reubenstr/MelodicChimes/README.md

# MelodicChimes

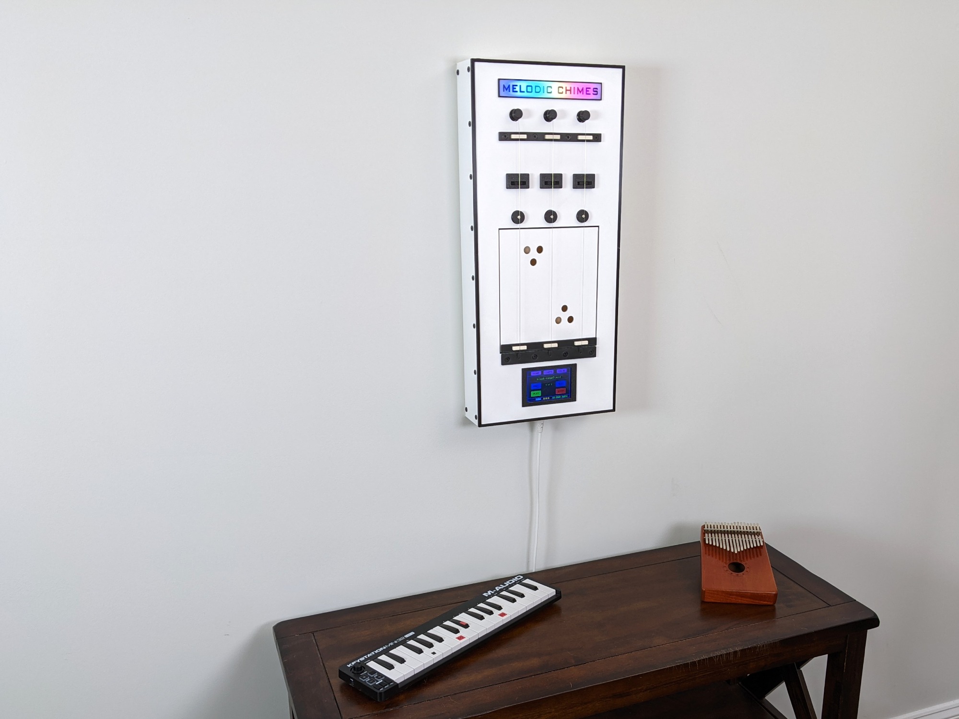
[picture p1: images/melodic-chimes-auto-tuning-string-midi-player-context.jpg]


Melodic Chimes is a three string auto-tuning wall chime playing MIDI files created in MuseScore.
