reubenstr/MelodicChimes/PCBs/README.md

# PCBs

PCBs created in the free version of DipTrace found here https://diptrace.com/
