reubenstr/MelodicChimes/notes/prototyping-notes.txt

HARDWARE:
tuning stepper mounting bolts 4x M3-20mm (12  total)
tuning stepper lower brass cover 1x M3-4mm (3 total)
tunign stepper printed mount 2x M3-10mm		
pcb M3-6mm course thread
psu M3-12mm 2x

PROJECT FIXES:
PCB main - add markings for UART headers.
PCB chime - break out stepper enables per stepper

STEPPER:
Tuner stepper: 5.18:1 gear head 200steps/rev * 5.18 = 1036

Stepper driver jumpers:
[M1 - M6]
MS1: J4, J5, J6, J10, J11, J12
MS2: J1, J2, J3, J7, J8, J9

MS1 MS2 Steps
+	-	1/2
-	+	1/4
-	-	1/8
+	+	1/16

DEVELOPMENT NOTES:

defined AUDIO_GUITARTUNER_BLOCKS value of 24 changed to 6 for
faster analysis at the sacrafice of less lower frequency detection
which is not required for this application.

Blocks : lowest frequncy (rough estimate) : milliseconds per note
3 : 233hz : 9
4 : 174hz : 12
5 : 139hz : 15

A weak magnet for the coil is has a low signal to noise ratio.
A stronger magnet provides a high signal to noise ration.
An overly strong magnet over dampens the string vibrations reducing the length of the signal.
