reubenstr/MelodicChimes/images/melodic-chimes-auto-picker-and-volume-position-steppers.jpg

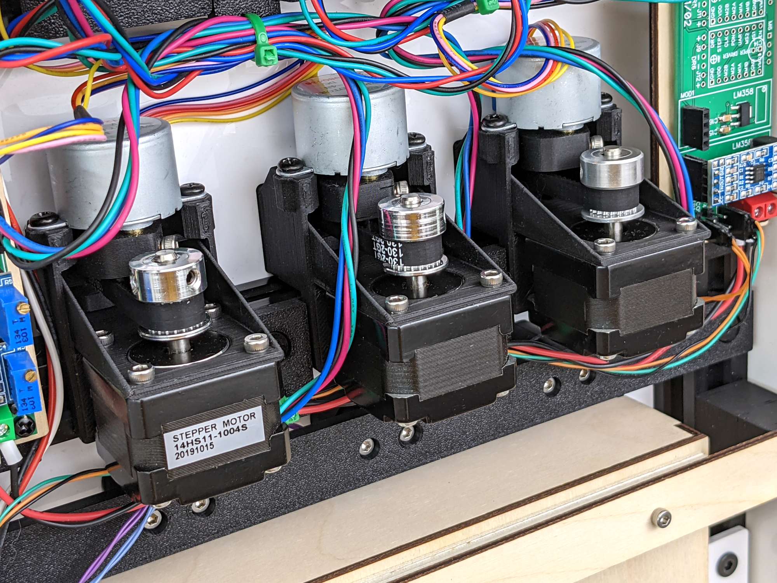
images/melodic-chimes-auto-picker-and-volume-position-steppers.jpg
