reubenstr/MelodicChimes/images/melodic-chimes-back-angled.jpg

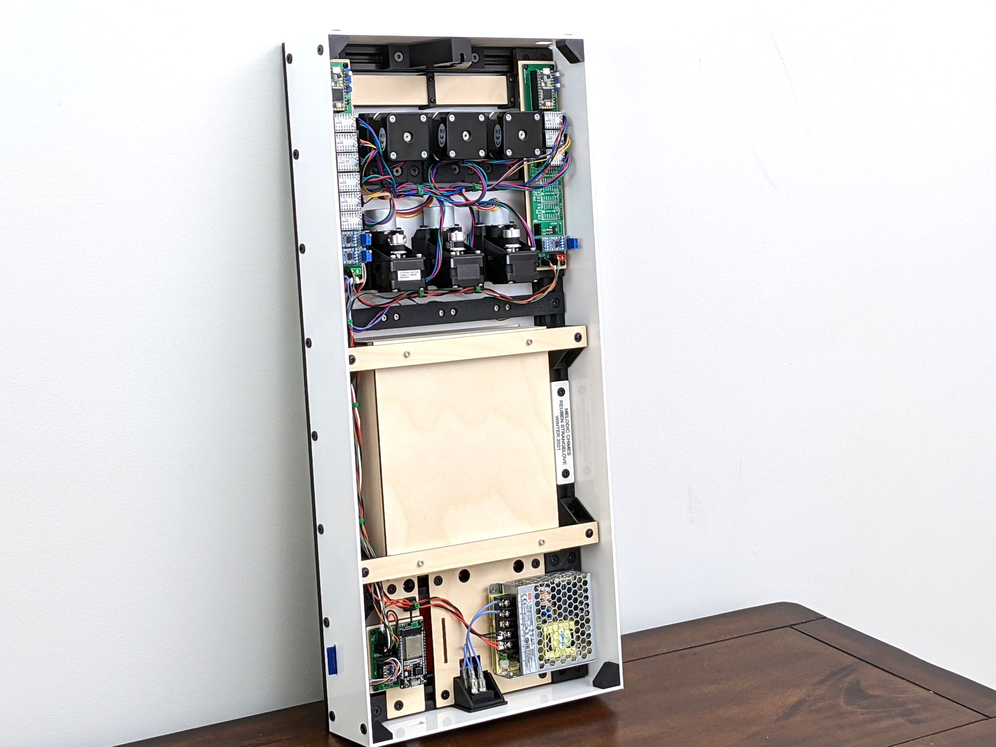
images/melodic-chimes-back-angled.jpg
