reubenstr/MelodicChimes/images/melodic-chimes-back.jpg

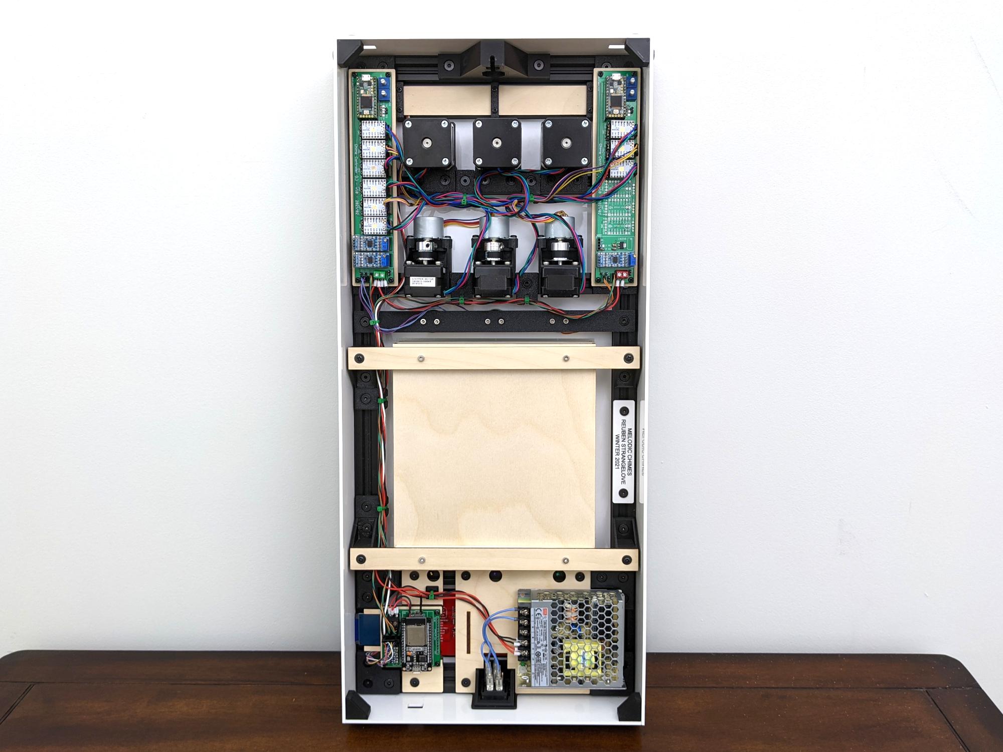
images/melodic-chimes-back.jpg
