reubenstr/MelodicChimes/images/melodic-chimes-CAD-laser-cutting.jpg

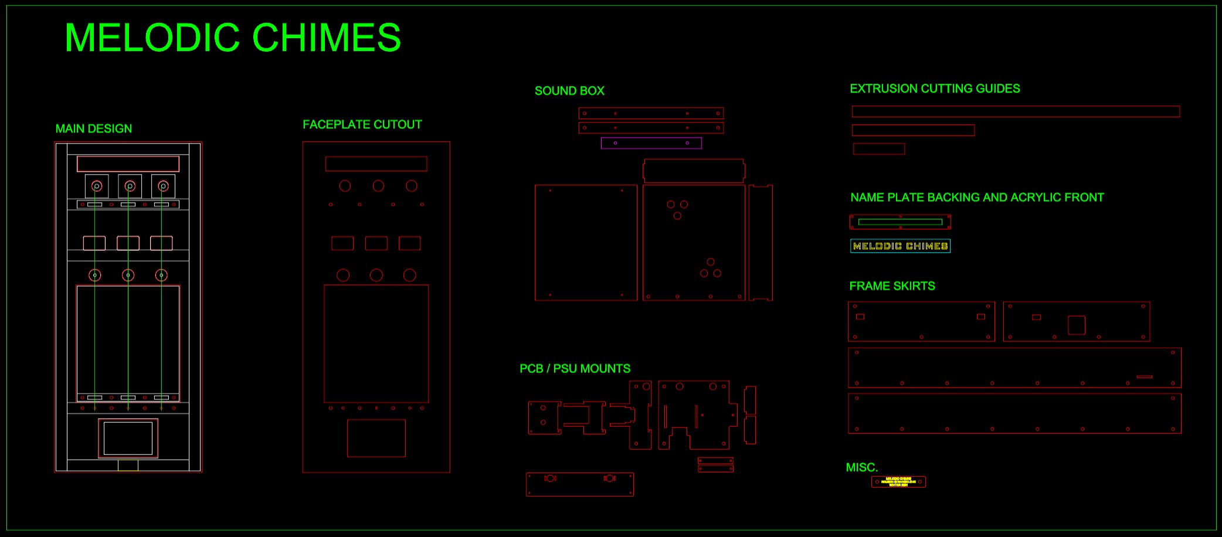
images/melodic-chimes-CAD-laser-cutting.jpg
