reubenstr/MelodicChimes/images/melodic-chimes-chime-controller-pcb-render.png

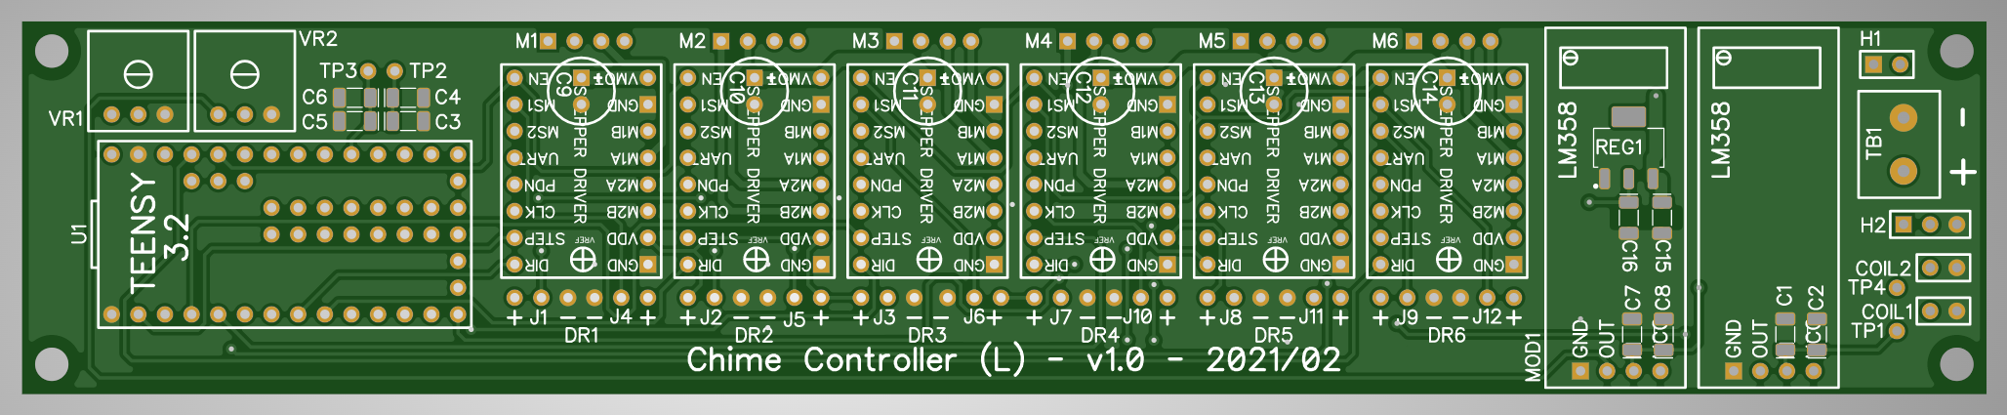
images/melodic-chimes-chime-controller-pcb-render.png
