reubenstr/MelodicChimes/images/melodic-chimes-chime-controller-schematic.png

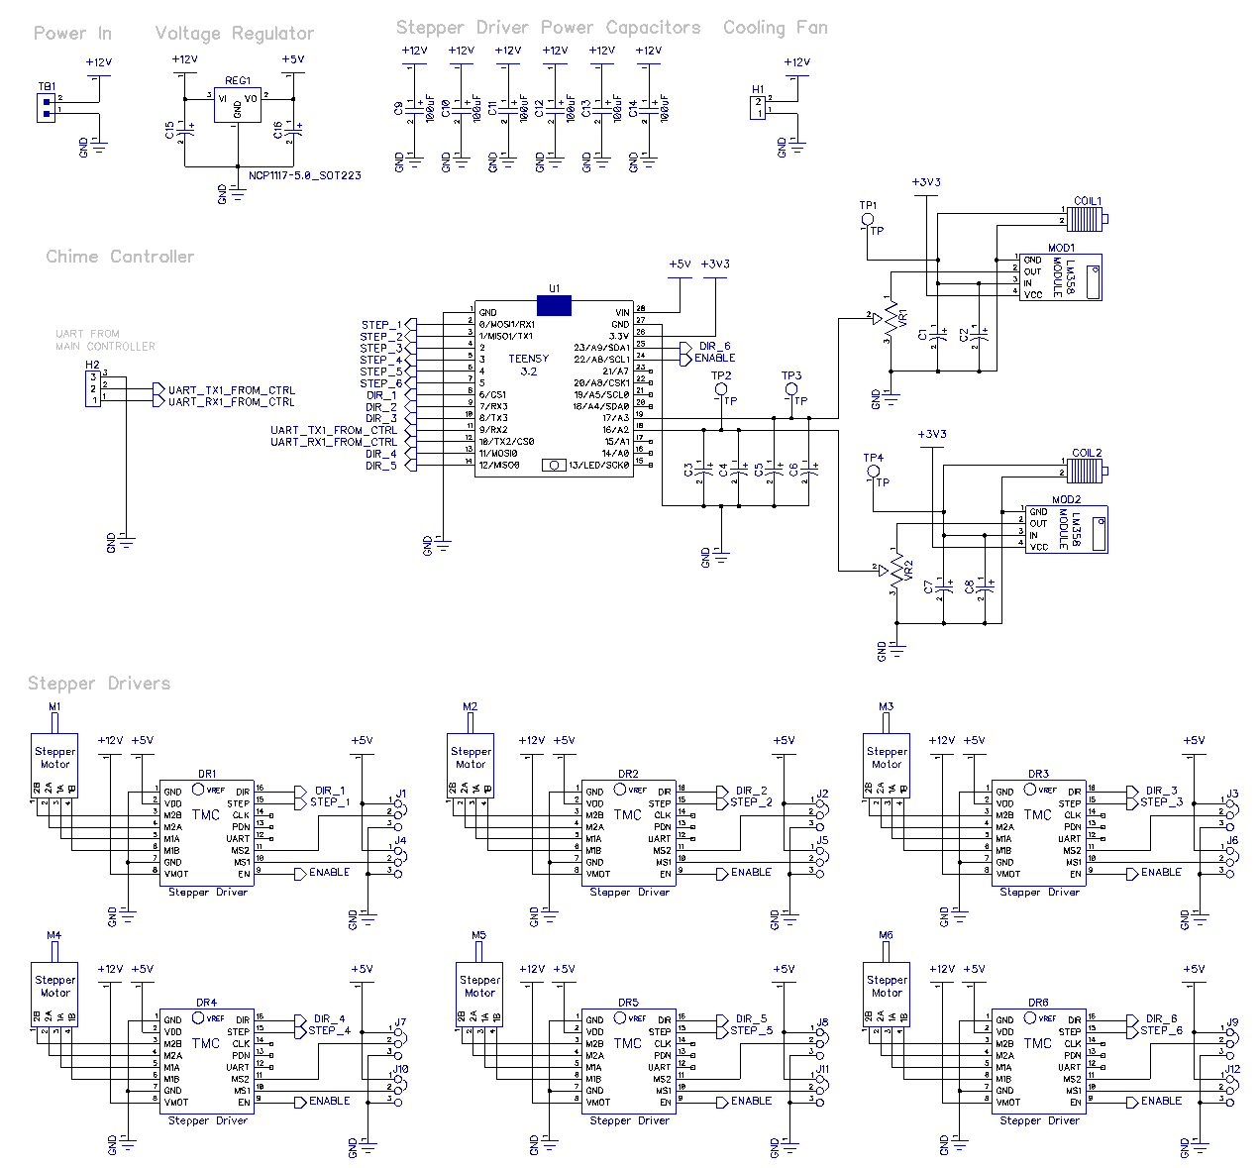
images/melodic-chimes-chime-controller-schematic.png
