reubenstr/MelodicChimes/images/melodic-chimes-corner-bracket.jpg

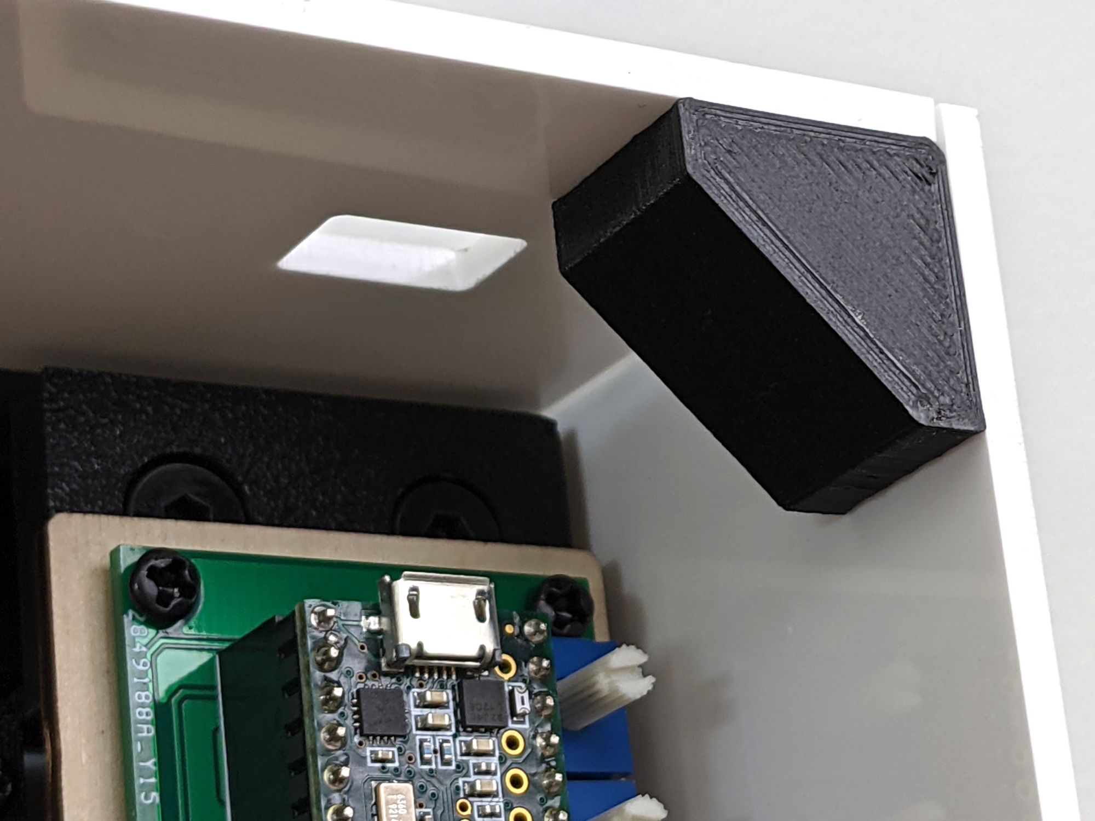
images/melodic-chimes-corner-bracket.jpg
