reubenstr/MelodicChimes/images/melodic-chimes-esp32-microcontroller-and-sd-card-slot.jpg

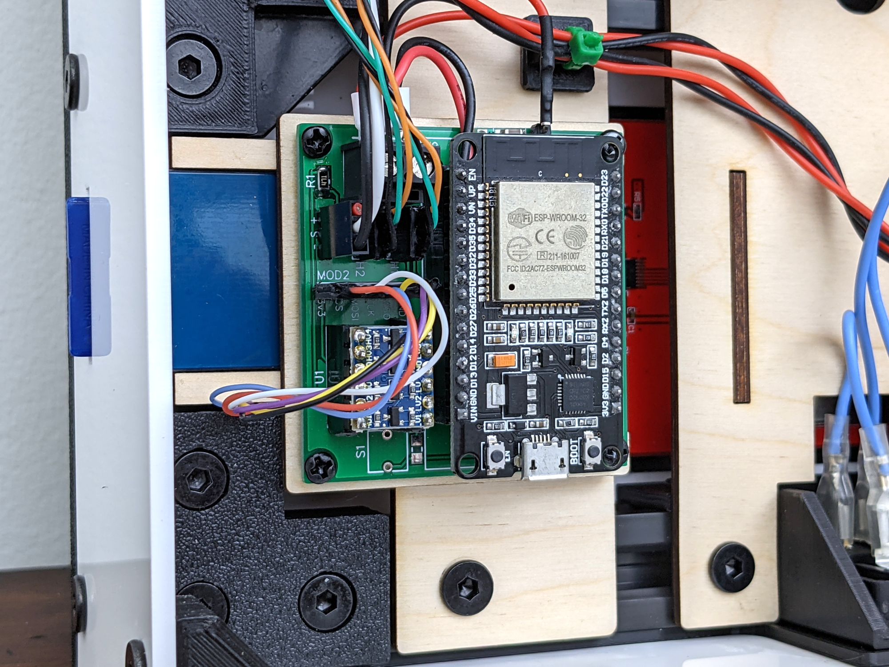
images/melodic-chimes-esp32-microcontroller-and-sd-card-slot.jpg
