reubenstr/MelodicChimes/images/melodic-chimes-guitar-string-single-pickup.jpg

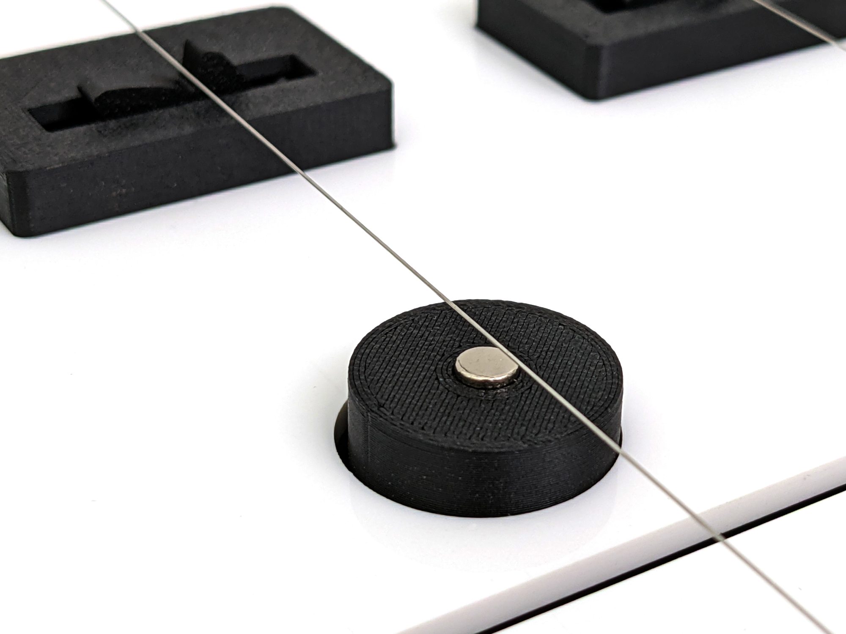
images/melodic-chimes-guitar-string-single-pickup.jpg
