reubenstr/MelodicChimes/images/melodic-chimes-illuminated-face-plate.jpg

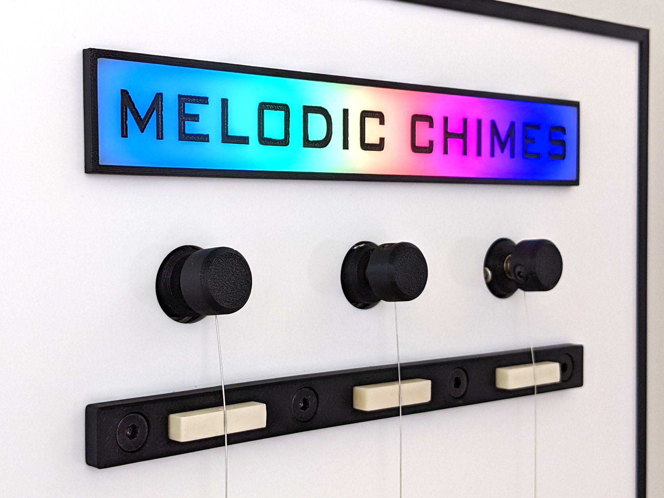
images/melodic-chimes-illuminated-face-plate.jpg
