reubenstr/MelodicChimes/images/melodic-chimes-keyboard-mini32-mk3.jpg

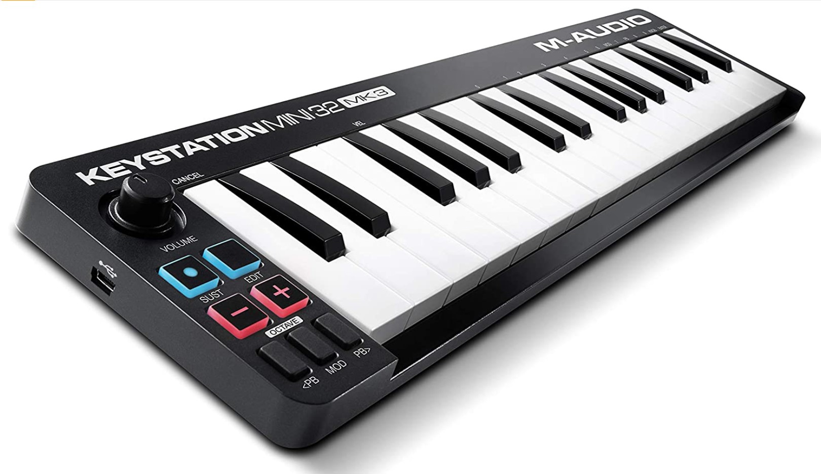
images/melodic-chimes-keyboard-mini32-mk3.jpg
