reubenstr/MelodicChimes/images/melodic-chimes-lower-bone-bridge.jpg

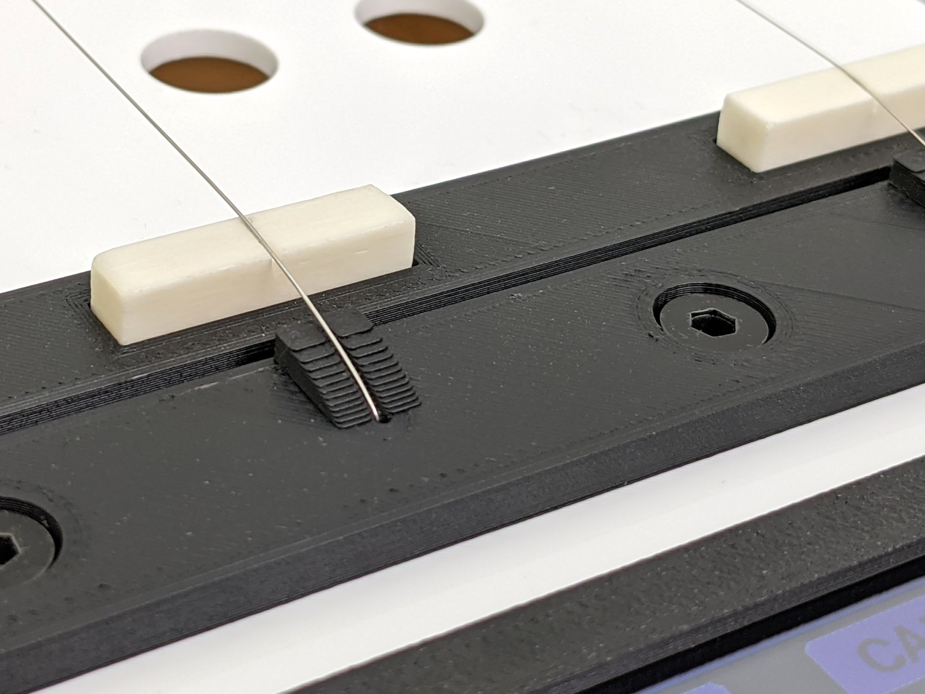
images/melodic-chimes-lower-bone-bridge.jpg
