reubenstr/MelodicChimes/images/melodic-chimes-main-controller-pcb-render.png

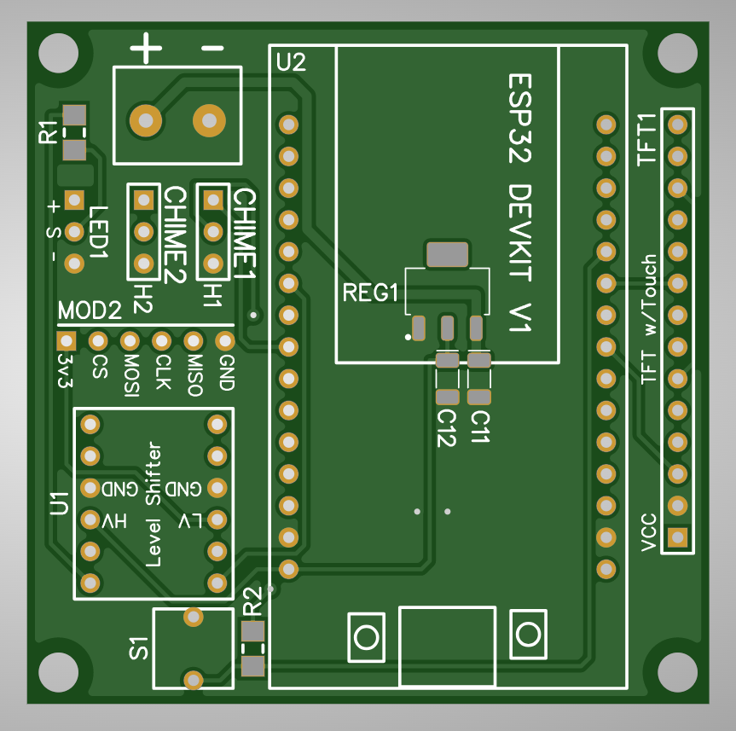
images/melodic-chimes-main-controller-pcb-render.png
