reubenstr/MelodicChimes/images/melodic-chimes-main-controller-schematic.png

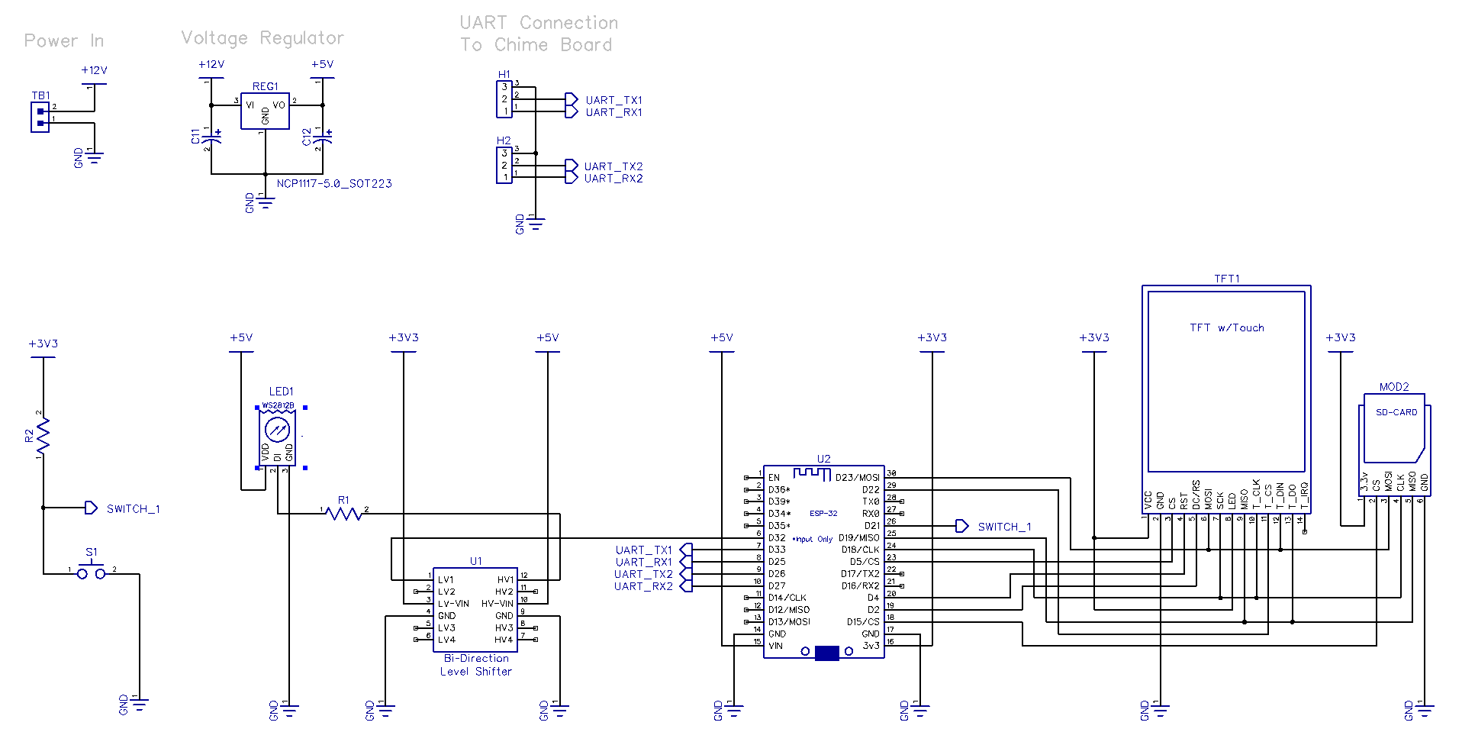
images/melodic-chimes-main-controller-schematic.png
