reubenstr/MelodicChimes/images/melodic-chimes-mean-well-power-supply.jpg

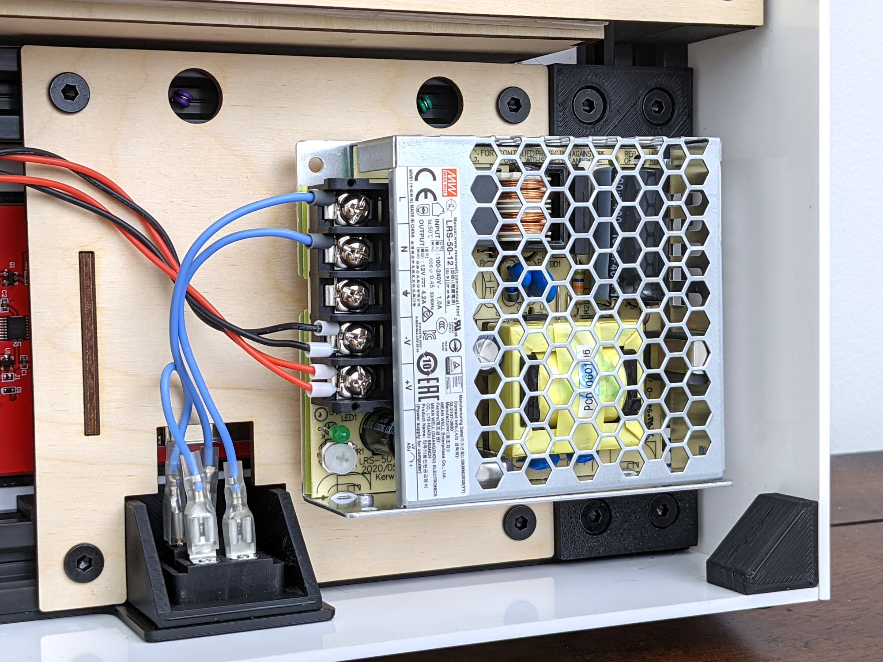
images/melodic-chimes-mean-well-power-supply.jpg
