reubenstr/MelodicChimes/images/melodic-chimes-musescore.png

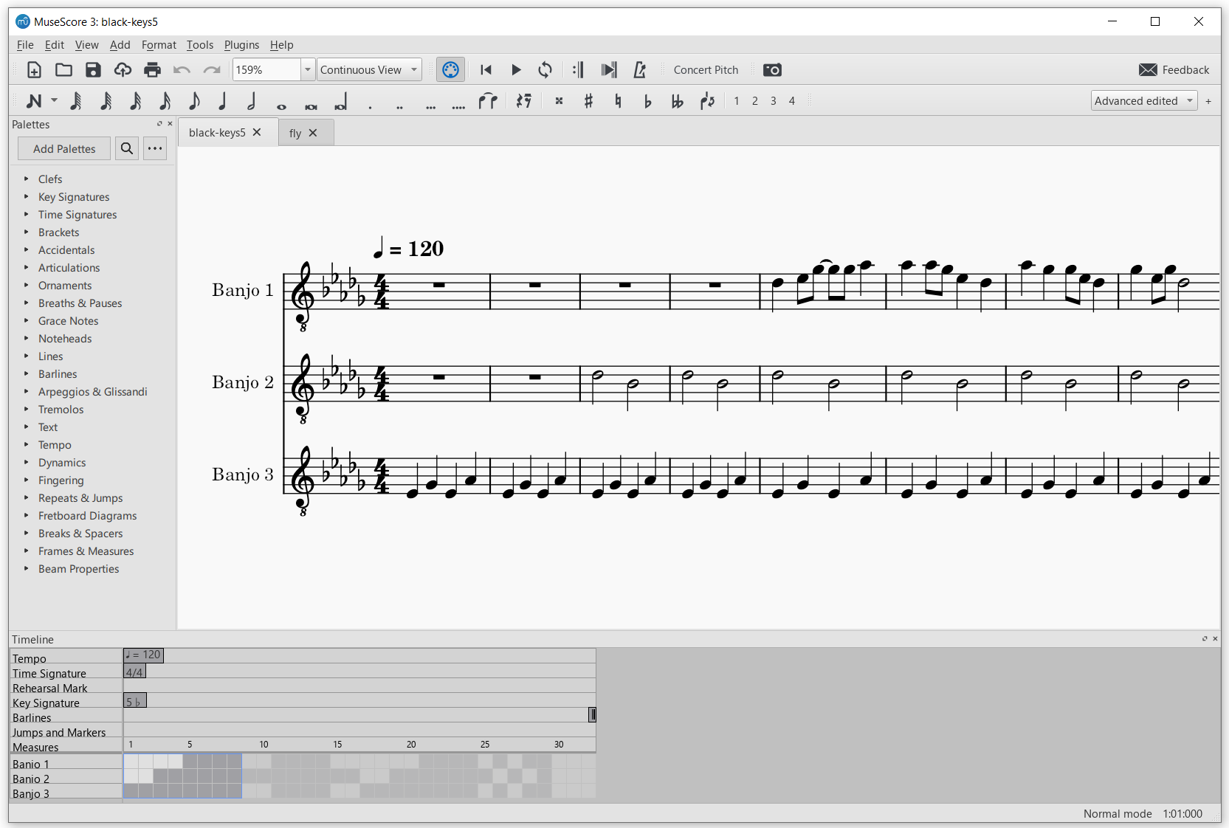
images/melodic-chimes-musescore.png
