reubenstr/MelodicChimes/images/melodic-chimes-pickup-mounting-bracket.jpg

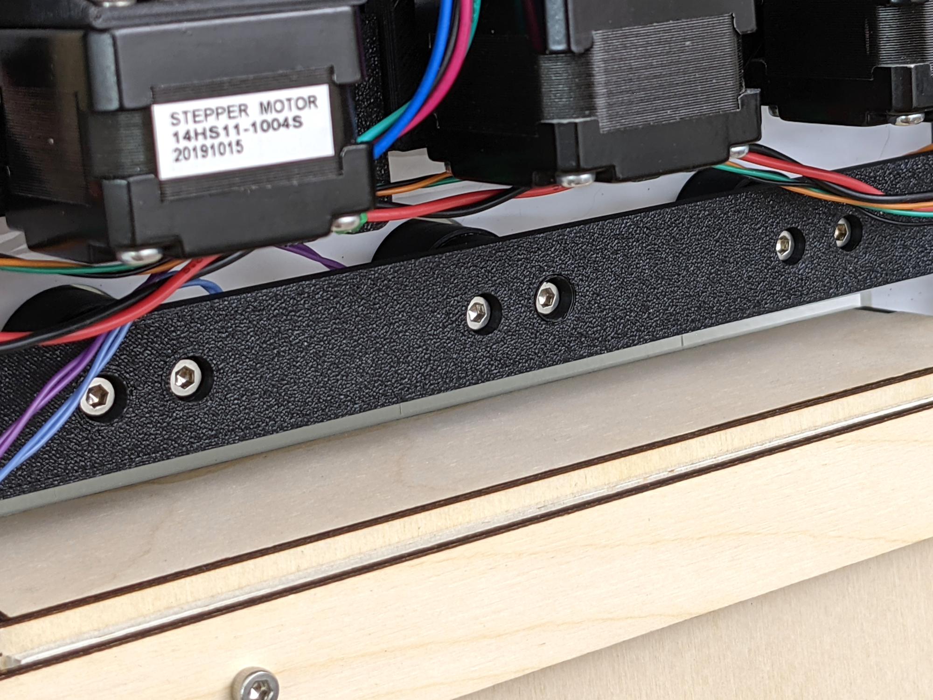
images/melodic-chimes-pickup-mounting-bracket.jpg
