reubenstr/MelodicChimes/images/melodic-chimes-pickup-preamps.jpg

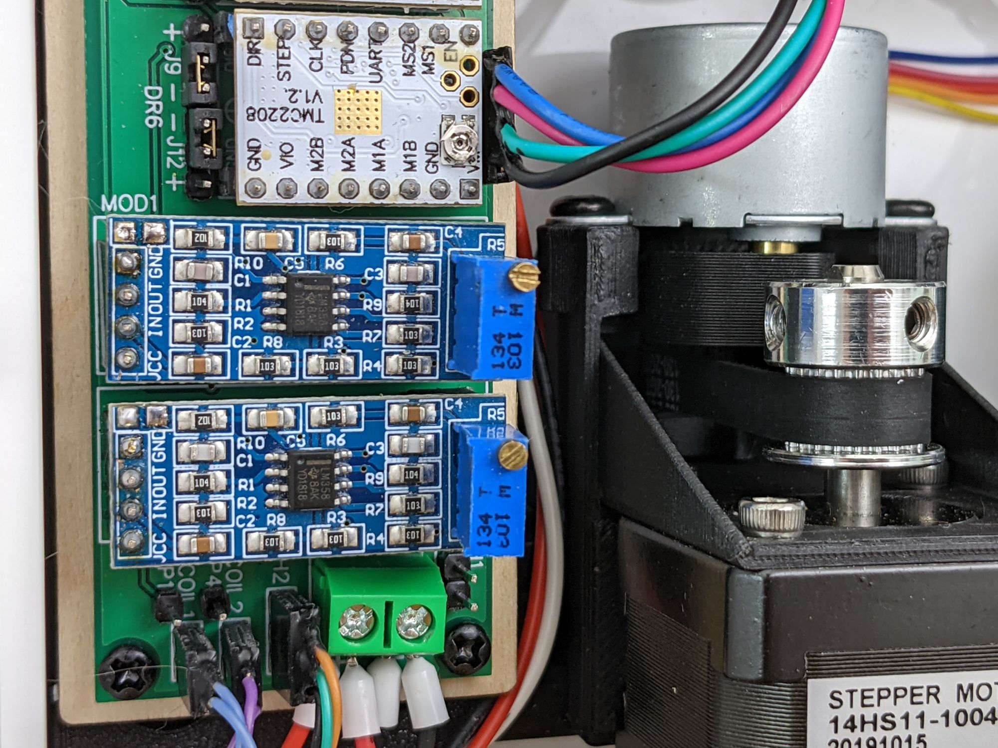
images/melodic-chimes-pickup-preamps.jpg
