reubenstr/MelodicChimes/images/melodic-chimes-pluctrum.jpg

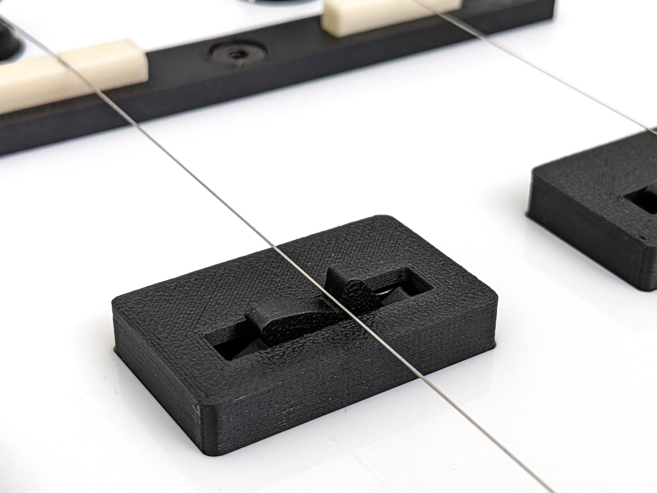
images/melodic-chimes-pluctrum.jpg
