reubenstr/MelodicChimes/images/melodic-chimes-power-plug-and-switch.jpg

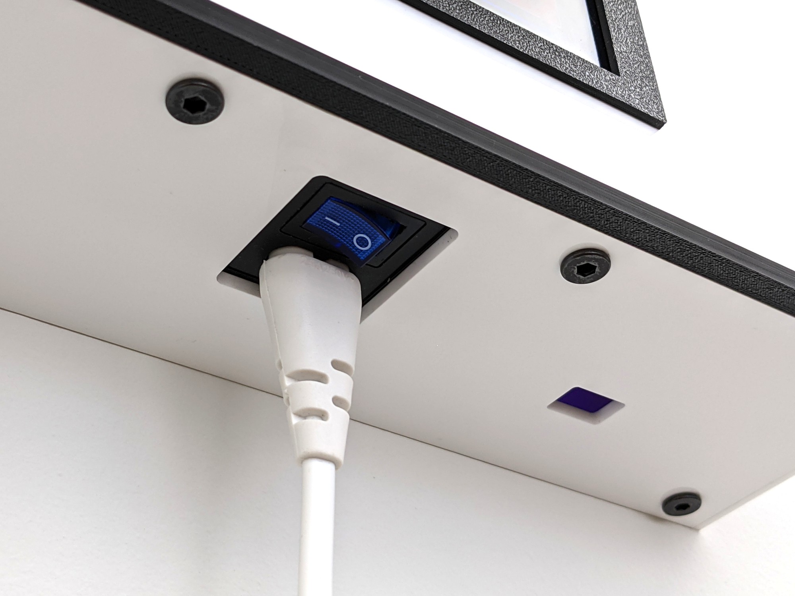
images/melodic-chimes-power-plug-and-switch.jpg
