reubenstr/MelodicChimes/images/melodic-chimes-programming-slot.jpg

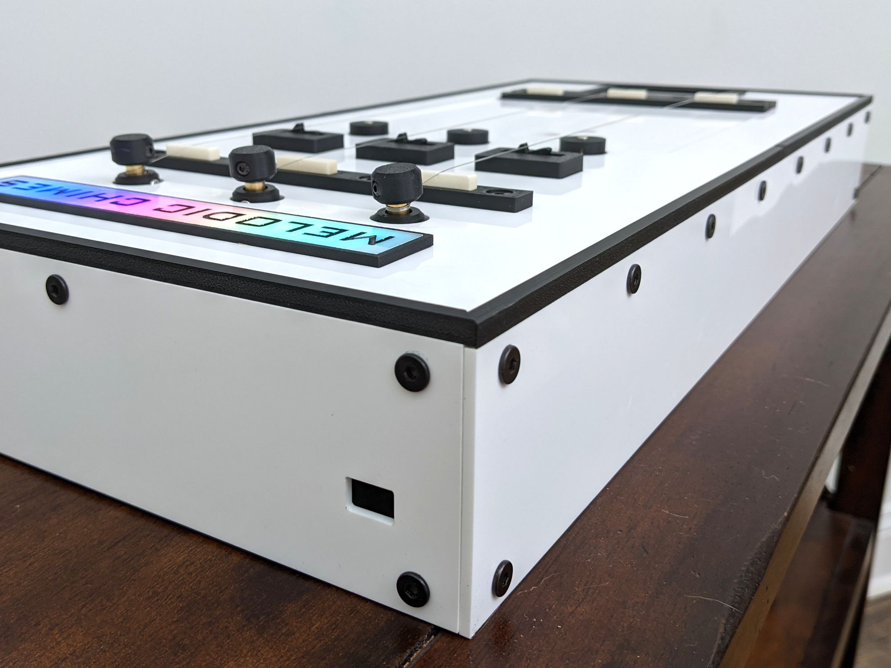
images/melodic-chimes-programming-slot.jpg
