reubenstr/MelodicChimes/images/melodic-chimes-read-sound-box.jpg

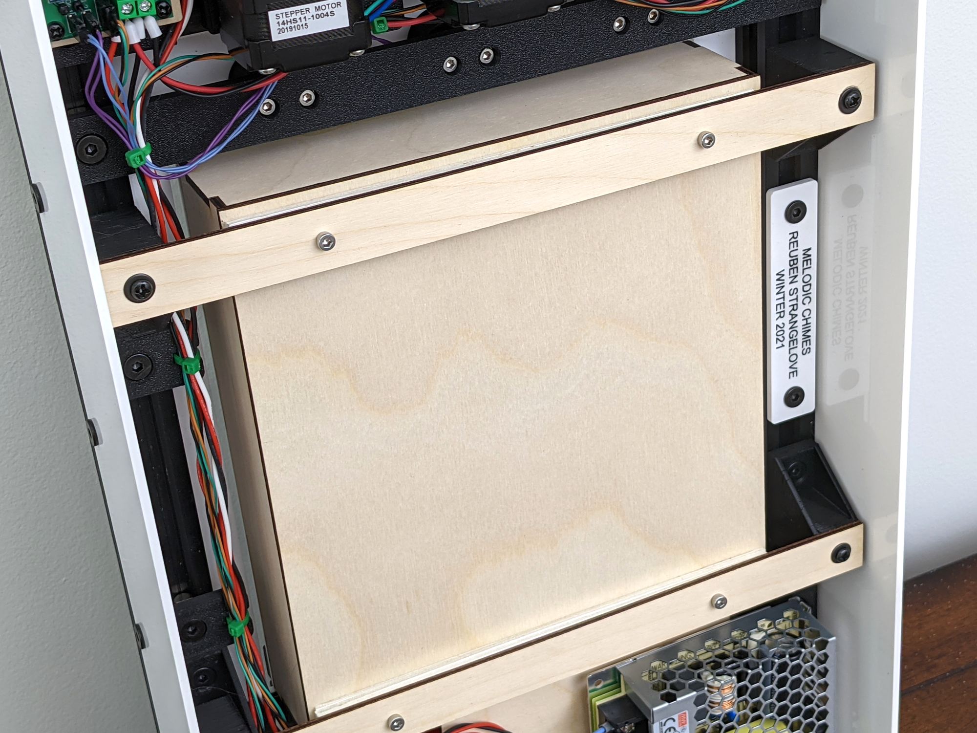
images/melodic-chimes-read-sound-box.jpg
