reubenstr/MelodicChimes/images/melodic-chimes-sd-card-slot.jpg

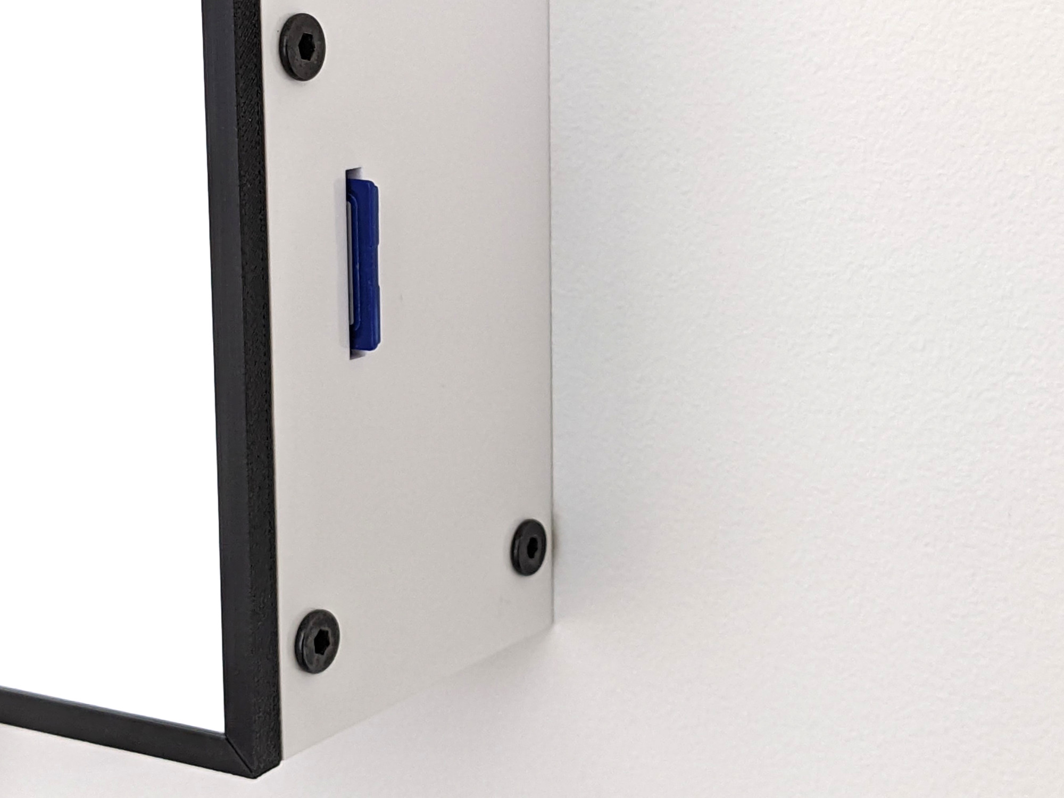
images/melodic-chimes-sd-card-slot.jpg
