reubenstr/MelodicChimes/images/melodic-chimes-sound-holes.jpg

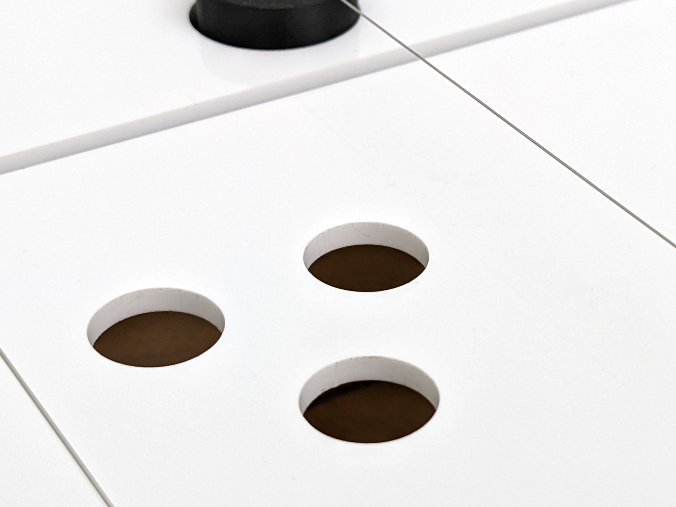
images/melodic-chimes-sound-holes.jpg
