reubenstr/MelodicChimes/images/melodic-chimes-stepper-motor-electronics.jpg

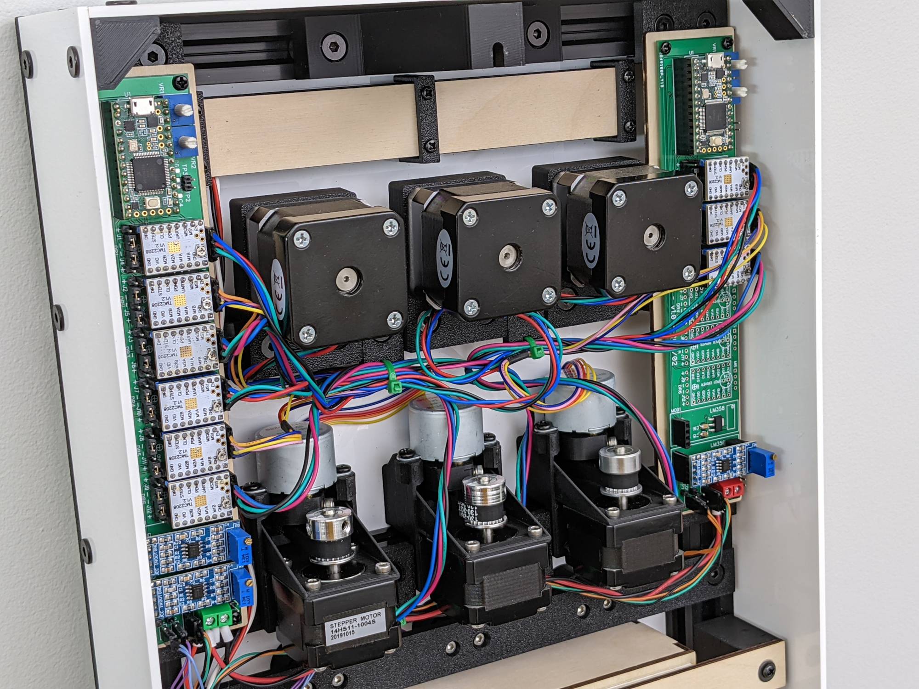
images/melodic-chimes-stepper-motor-electronics.jpg
