reubenstr/MelodicChimes/images/melodic-chimes-teensy-controller.jpg

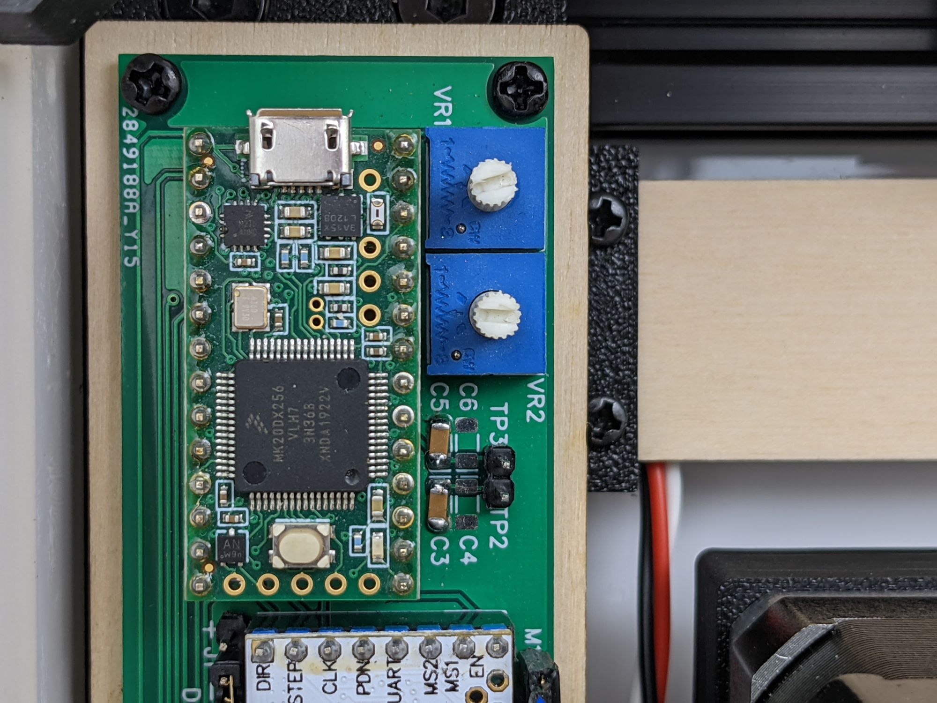
images/melodic-chimes-teensy-controller.jpg
