reubenstr/MelodicChimes/images/melodic-chimes-tft-interface.jpg

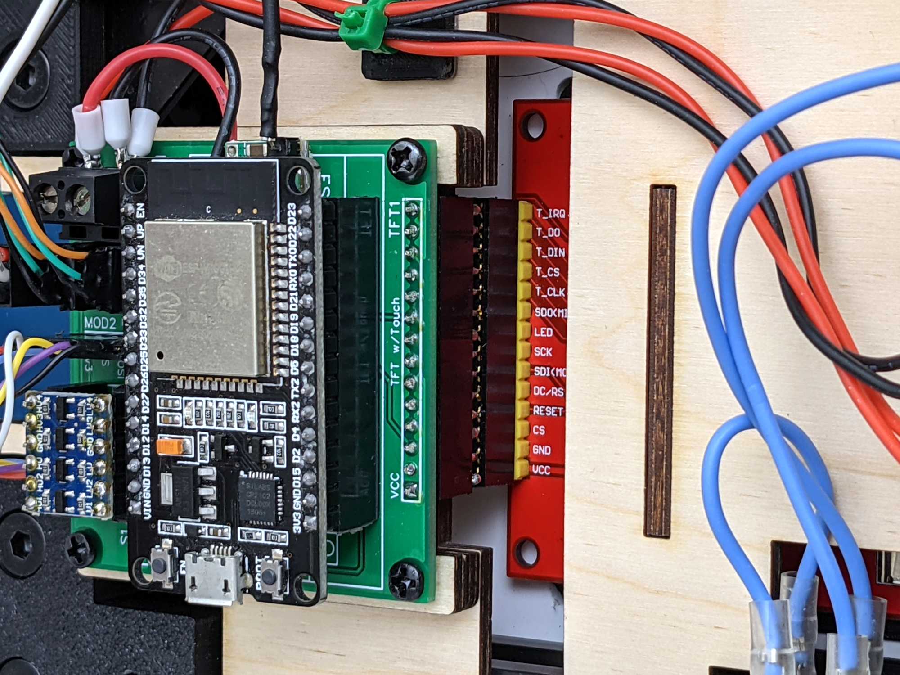
images/melodic-chimes-tft-interface.jpg
