reubenstr/MelodicChimes/images/melodic-chimes-tft-lcd-display-control-panel.jpg

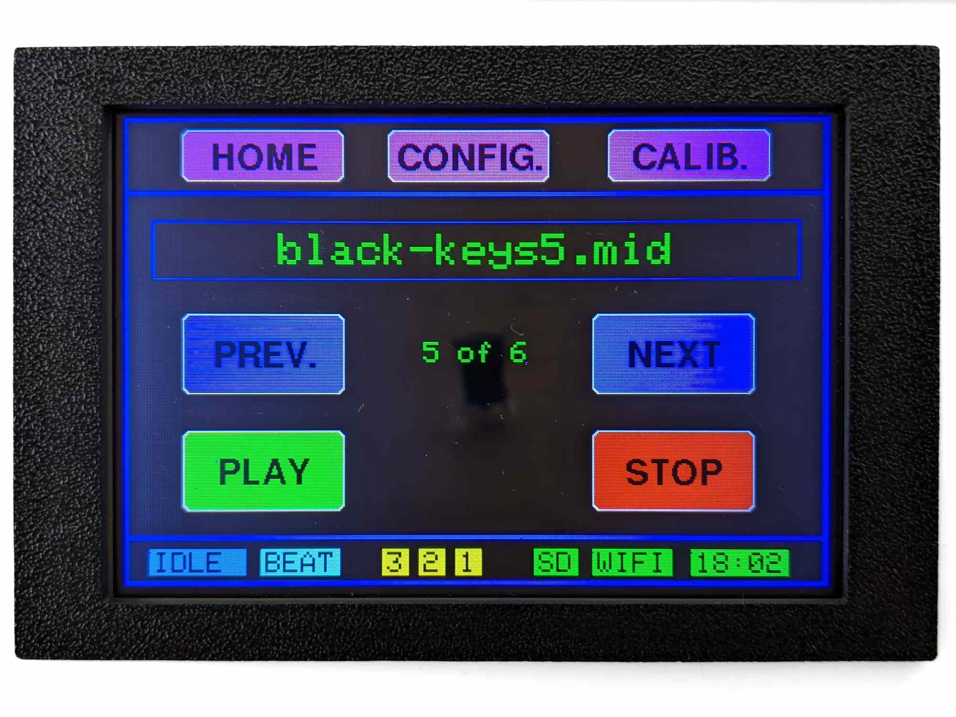
images/melodic-chimes-tft-lcd-display-control-panel.jpg
