reubenstr/MelodicChimes/images/melodic-chimes-tuner-gear-steppers.jpg

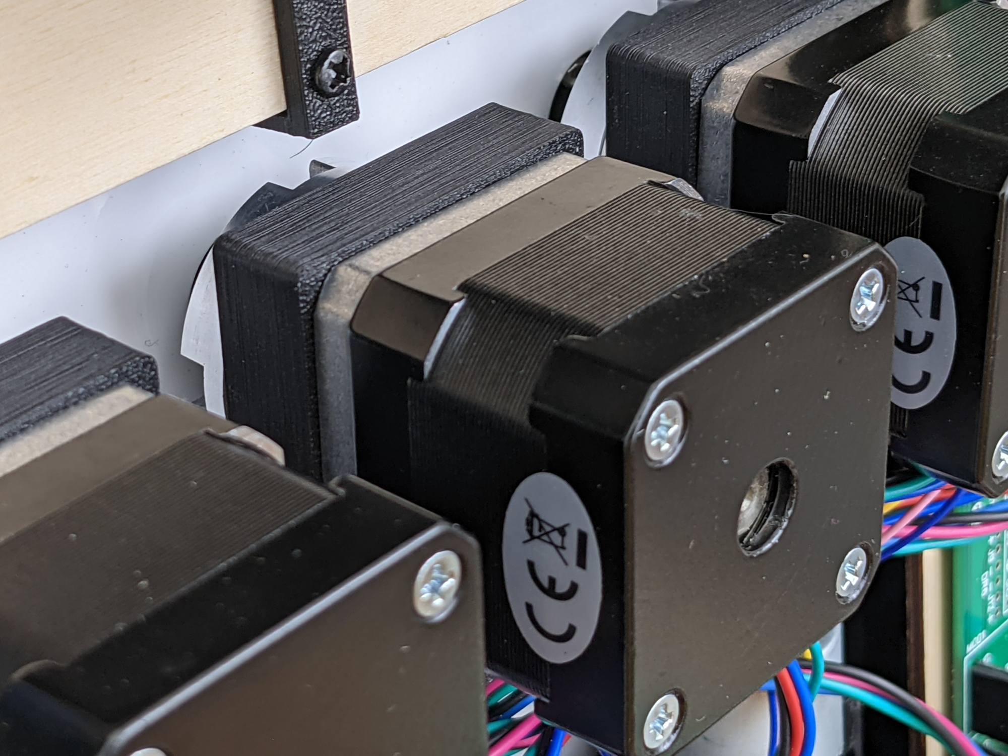
images/melodic-chimes-tuner-gear-steppers.jpg
