reubenstr/MelodicChimes/images/melodic-chimes-tuners-and-upper-bridge.jpg

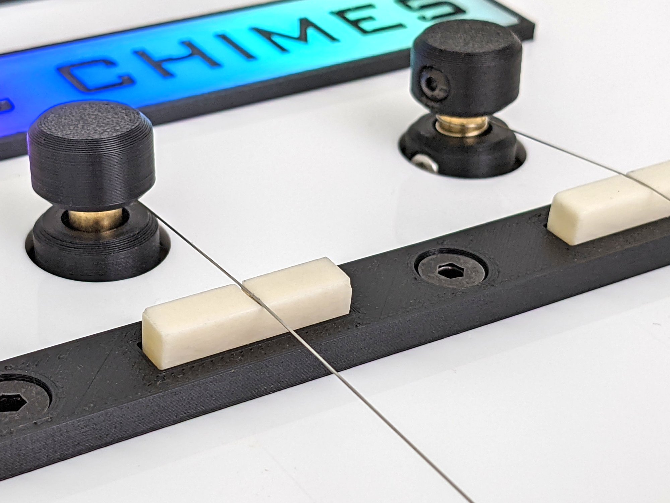
images/melodic-chimes-tuners-and-upper-bridge.jpg
