reubenstr/MelodicChimes/images/melodic-chimes-underview.jpg

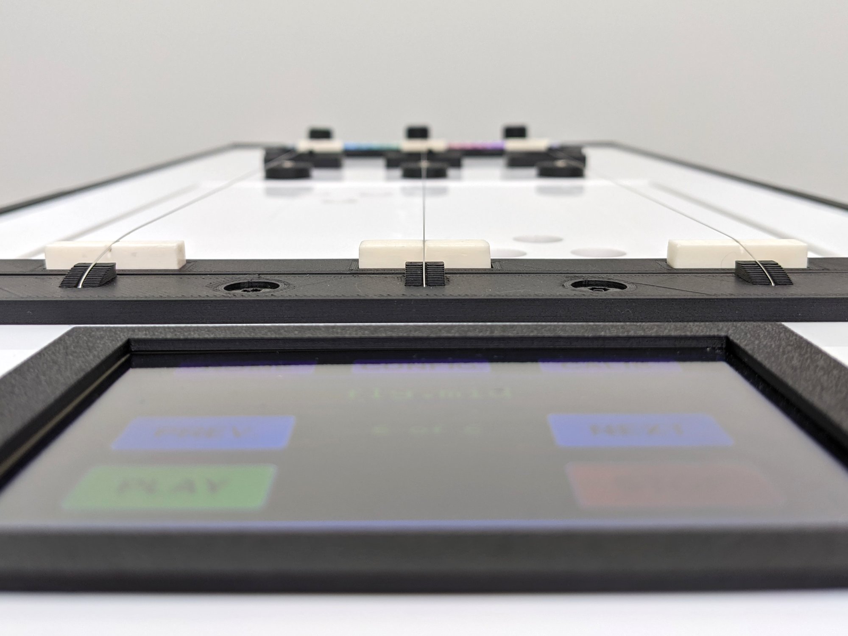
images/melodic-chimes-underview.jpg
