reubenstr/MelodicChimes/images/prototyping/melodic-chimes-prototype-breadboard.jpg

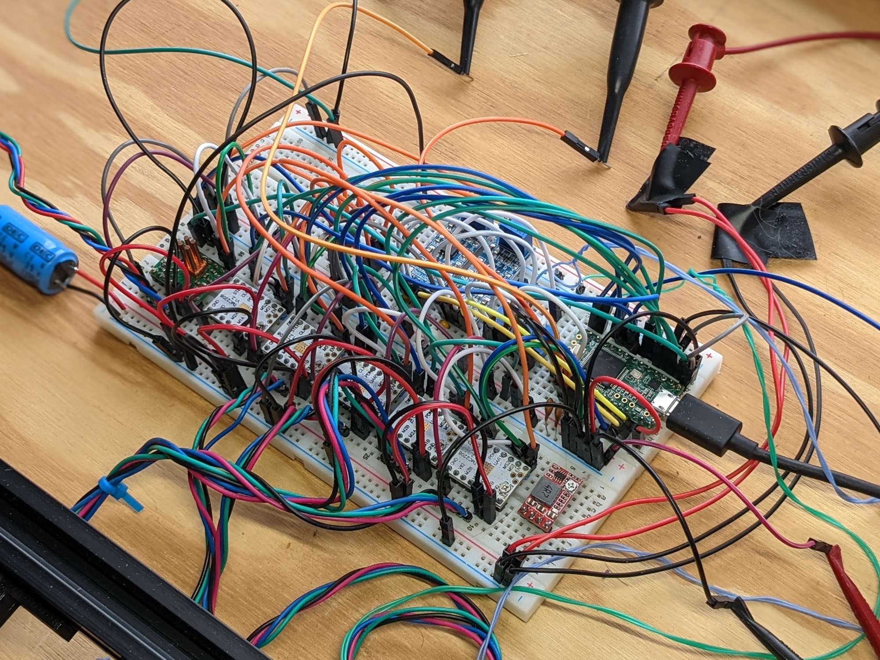
images/prototyping/melodic-chimes-prototype-breadboard.jpg
