reubenstr/MelodicChimes/images/prototyping/melodic-chimes-prototype-gear-head-picker.jpg

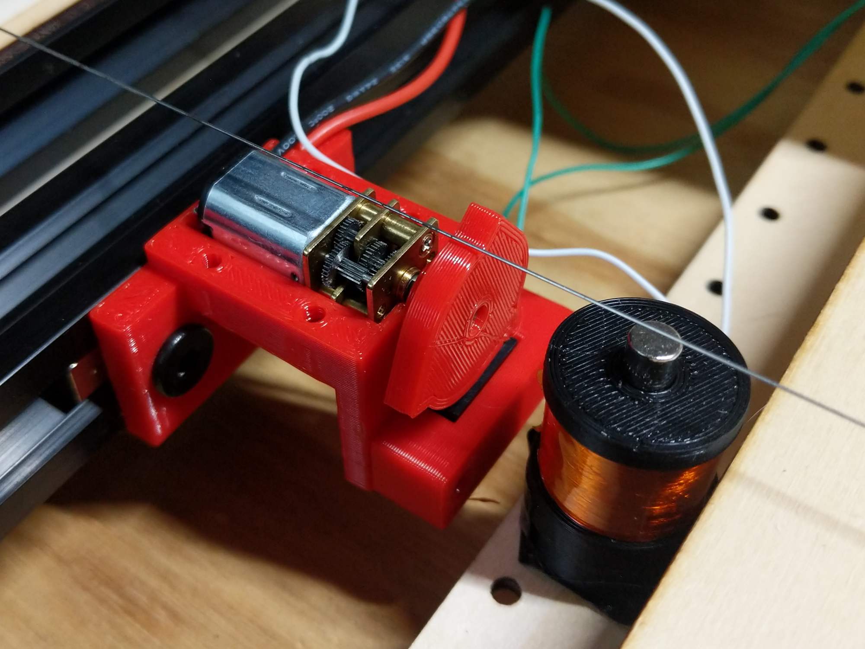
images/prototyping/melodic-chimes-prototype-gear-head-picker.jpg
