reubenstr/MelodicChimes/images/prototyping/melodic-chimes-prototype-glueing-soundboard.jpg

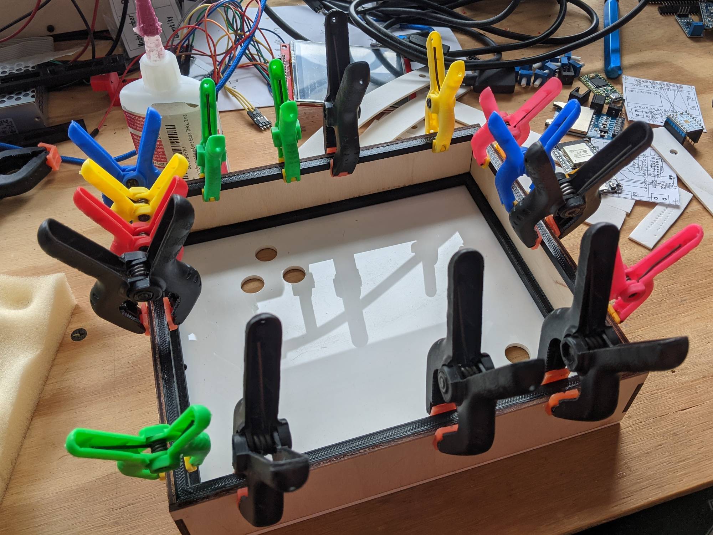
images/prototyping/melodic-chimes-prototype-glueing-soundboard.jpg
