reubenstr/MelodicChimes/images/prototyping/melodic-chimes-prototype-main-controller-pcb.jpg

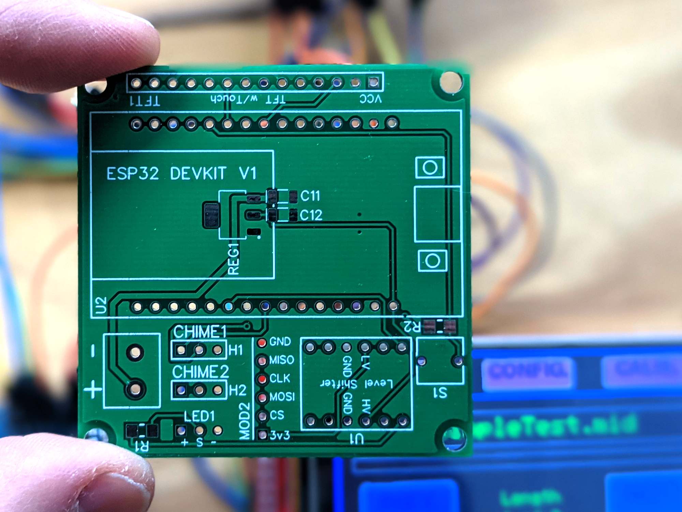
images/prototyping/melodic-chimes-prototype-main-controller-pcb.jpg
