reubenstr/MelodicChimes/images/prototyping/melodic-chimes-prototype-picker.jpg

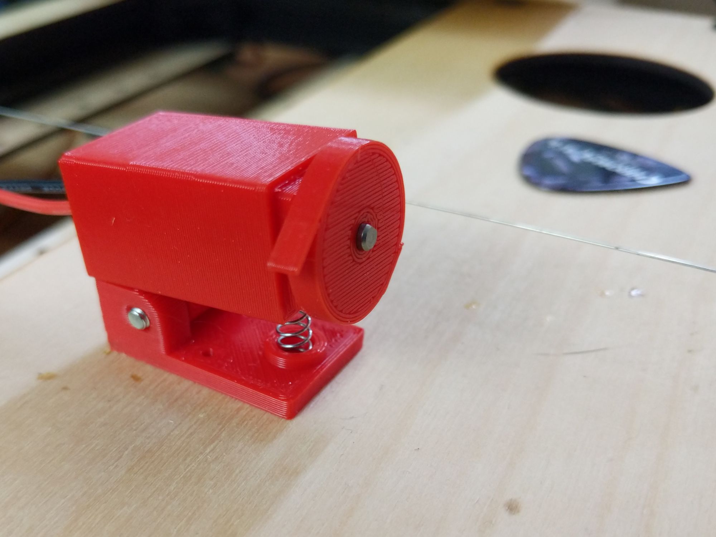
images/prototyping/melodic-chimes-prototype-picker.jpg
