reubenstr/MelodicChimes/images/prototyping/melodic-chimes-prototype-rc-servo-gearhead-motor.jpg

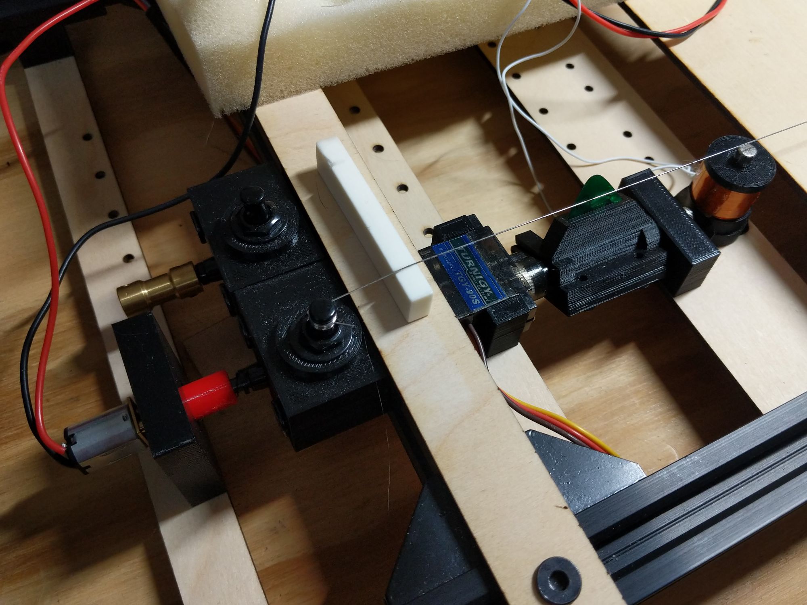
images/prototyping/melodic-chimes-prototype-rc-servo-gearhead-motor.jpg
