reubenstr/MelodicChimes/images/prototyping/melodic-chimes-prototype-snowfall.jpg

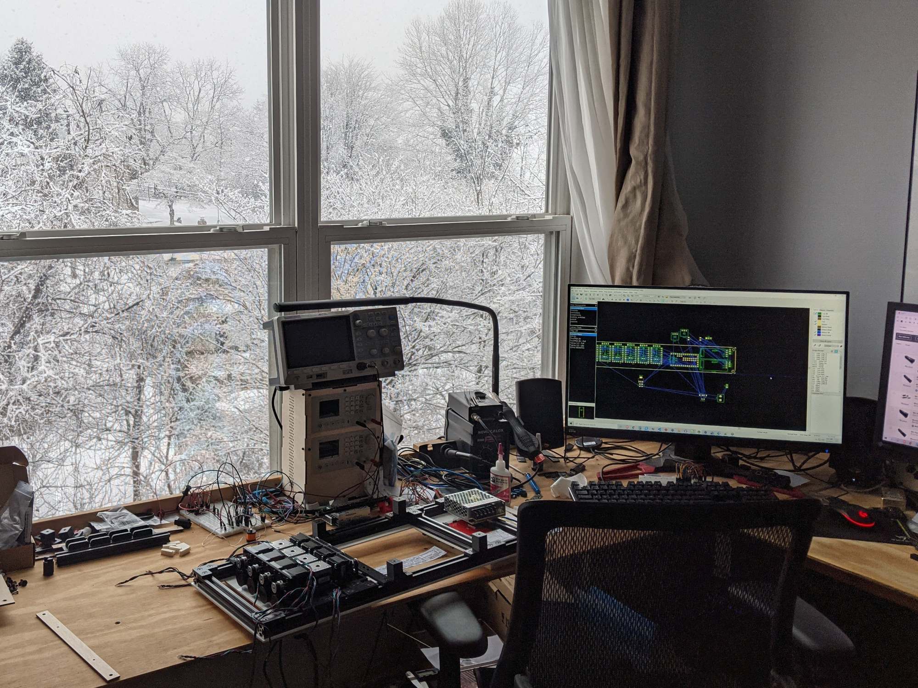
images/prototyping/melodic-chimes-prototype-snowfall.jpg
