reubenstr/MelodicChimes/images/prototyping/melodic-chimes-prototype-tft-lcd-dev.jpg

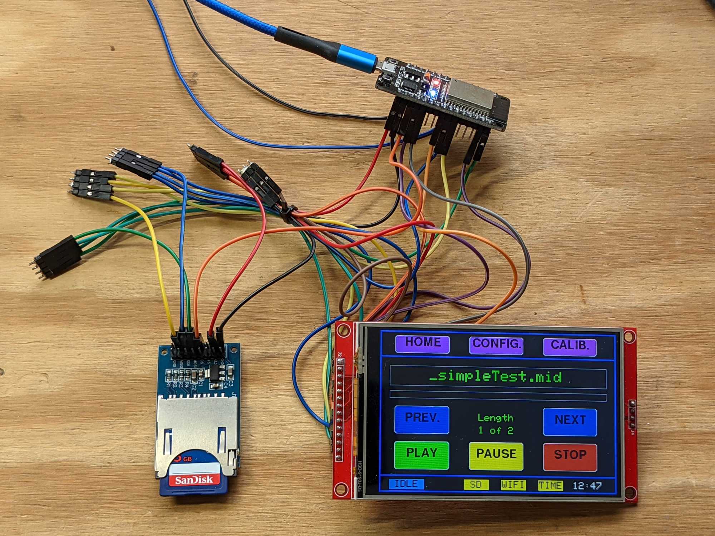
images/prototyping/melodic-chimes-prototype-tft-lcd-dev.jpg
