reubenstr/MelodicChimes/midi/note-range-per-chime.png

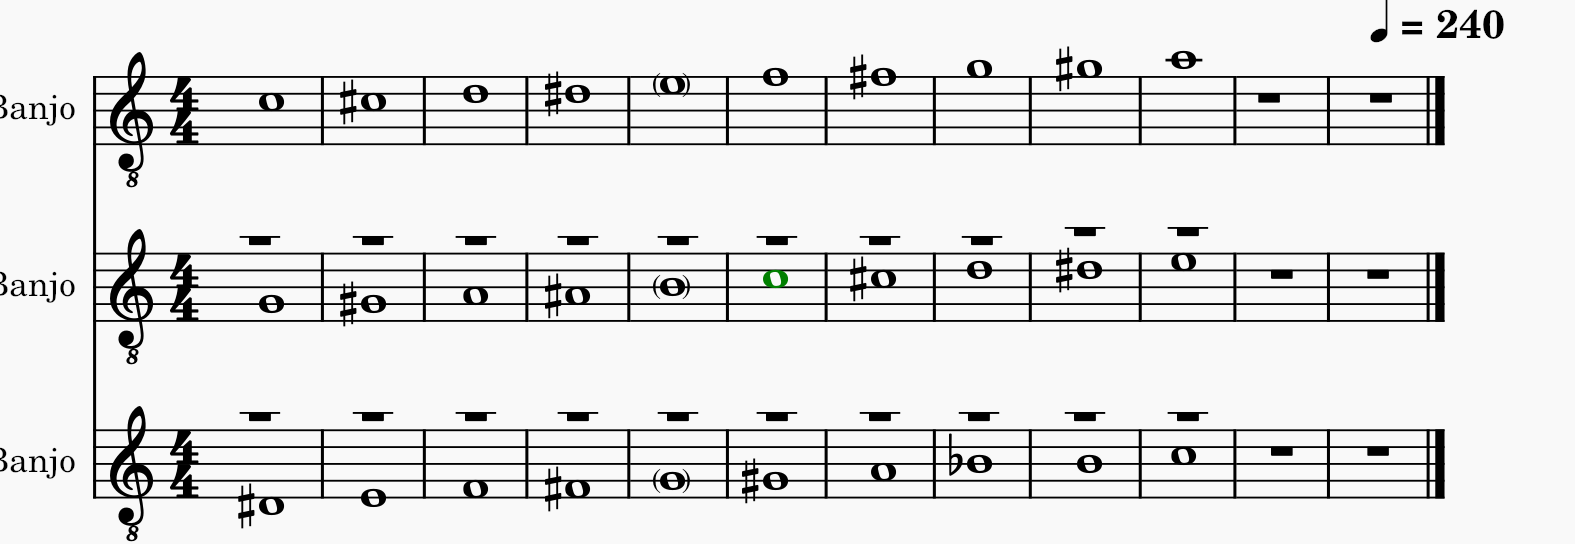
midi/note-range-per-chime.png
