reubenstr/MelodicChimes/notes/strings/guitar-fretboard.jpg

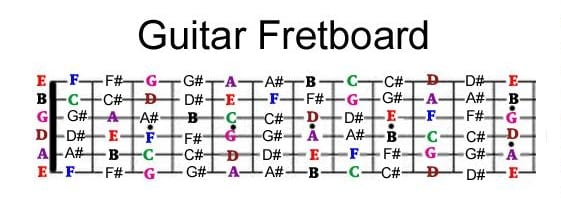
notes/strings/guitar-fretboard.jpg
