reubenstr/MelodicChimes/notes/strings/mechanism_a02_04.gif

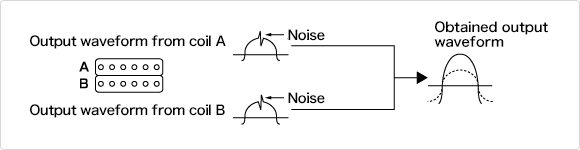
notes/strings/mechanism_a02_04.gif
