reubenstr/MelodicChimes/notes/strings/seventhstring-com-resources-notefrequencies.png

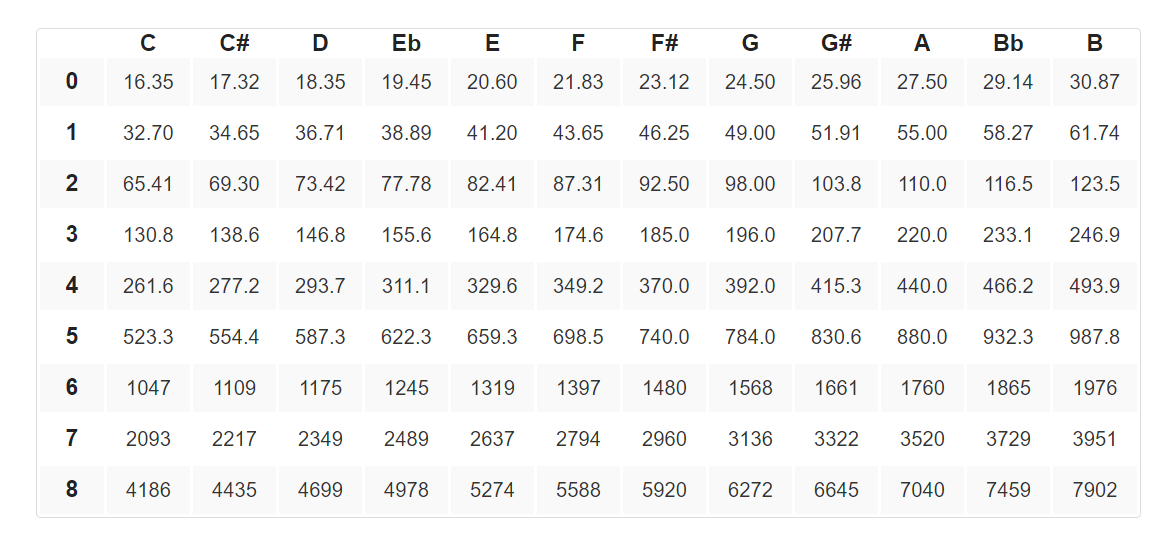
notes/strings/seventhstring-com-resources-notefrequencies.png
