reubenstr/MelodicChimes/images/melodic-chimes-fusion-360-CAD-3d-printed-parts.jpg

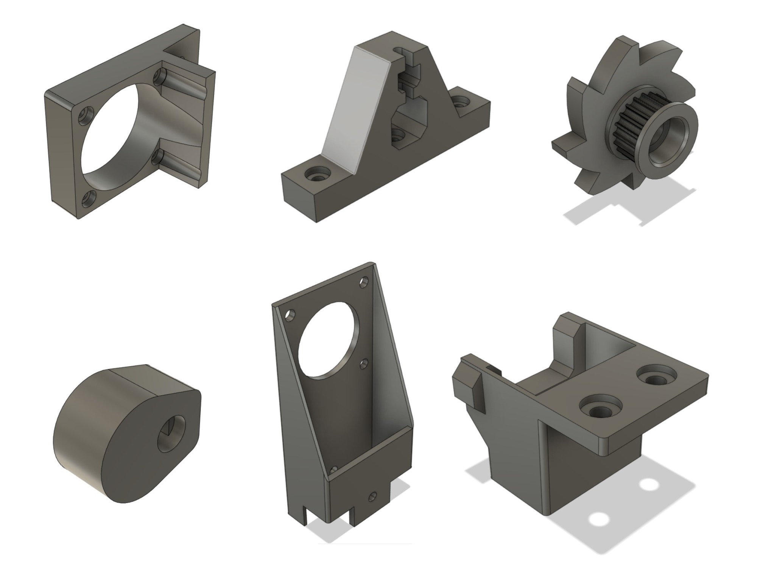
images/melodic-chimes-fusion-360-CAD-3d-printed-parts.jpg
