reubenstr/MelodicChimes/CAD/dxf/melodic-chimes-3.dxf

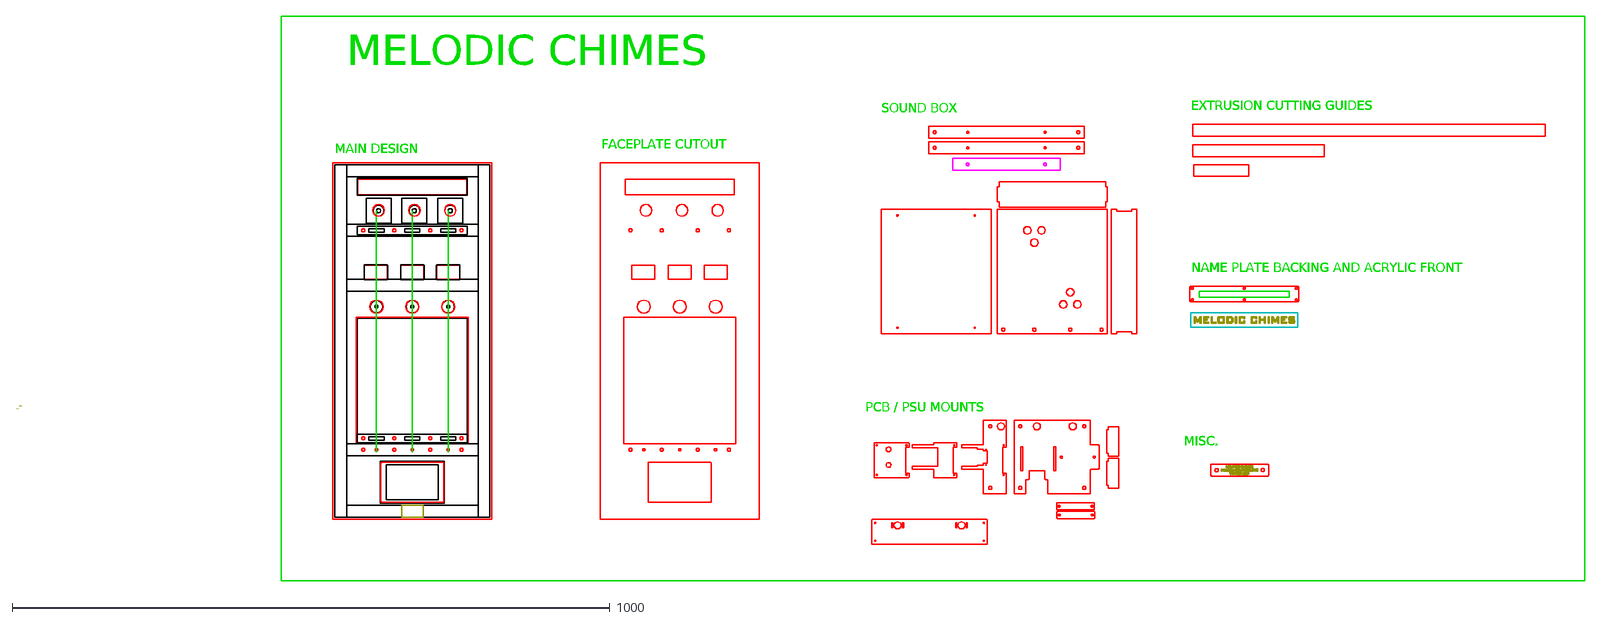
[picture p46: CAD file, 2021-12-23]
CAD/dxf/melodic-chimes-3.dxf
MELODIC CHIMES
FRAME CONTRUCTOR SPACERS
PCB / PSU MOUNTS
SOUND BOX
EXTRUSION CUTTING GUIDES
MISC.
NAME PLATE BACKING AND ACRYLIC FRONT
FACEPLATE CUTOUT
MAIN DESIGN
