reubenstr/MelodicChimes/CAD/stl/upper bridge v3.stl

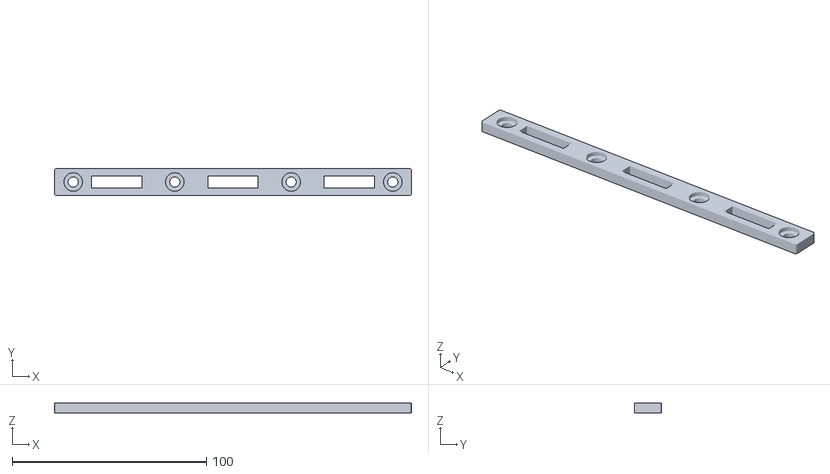
[picture p47: CAD file, 2022-01-09]
CAD/stl/upper bridge v3.stl
184.0 x 14.0 x 5.00
