reubenstr/MelodicChimes/CAD/stl/pcb mount riser v5.stl

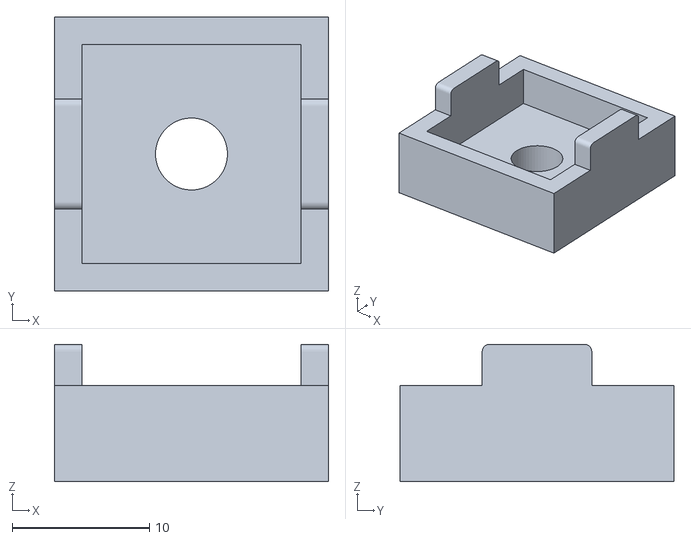
[picture p48: CAD file, 2022-01-09]
CAD/stl/pcb mount riser v5.stl
20.0 x 20.0 x 10.0
