reubenstr/MelodicChimes/CAD/stl/string cradle v8.stl

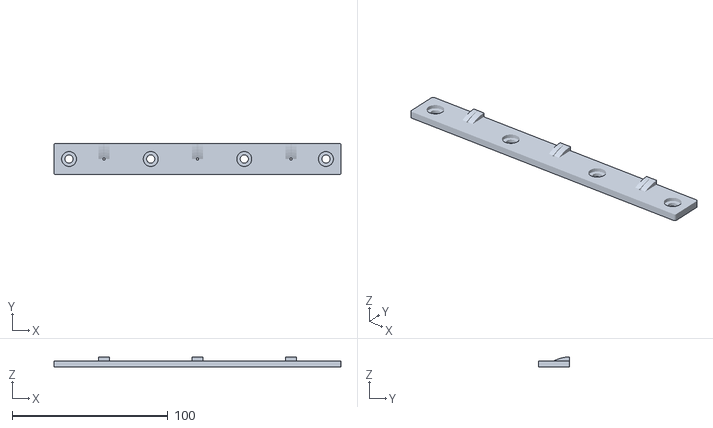
[picture p49: CAD file, 2022-01-09]
CAD/stl/string cradle v8.stl
184.0 x 20.0 x 6.50
