reubenstr/MelodicChimes/CAD/stl/name plate - housing v9.stl

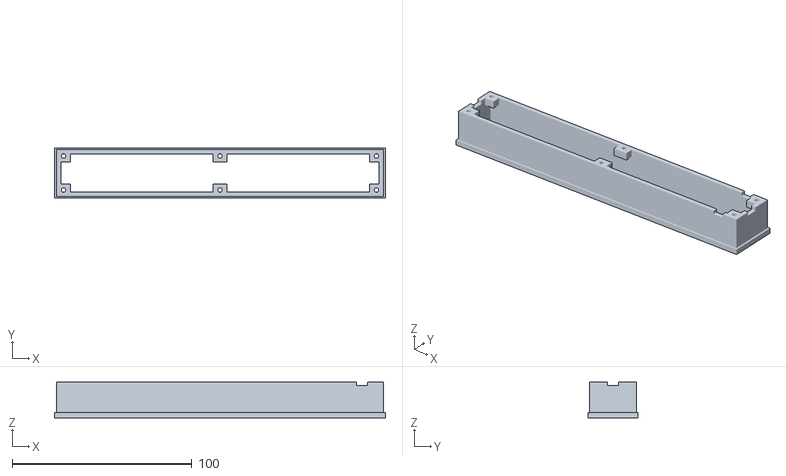
[picture p50: CAD file, 2022-01-09]
CAD/stl/name plate - housing v9.stl
184.0 x 28.0 x 20.0
