reubenstr/MelodicChimes/CAD/stl/rail wire clip v1.stl

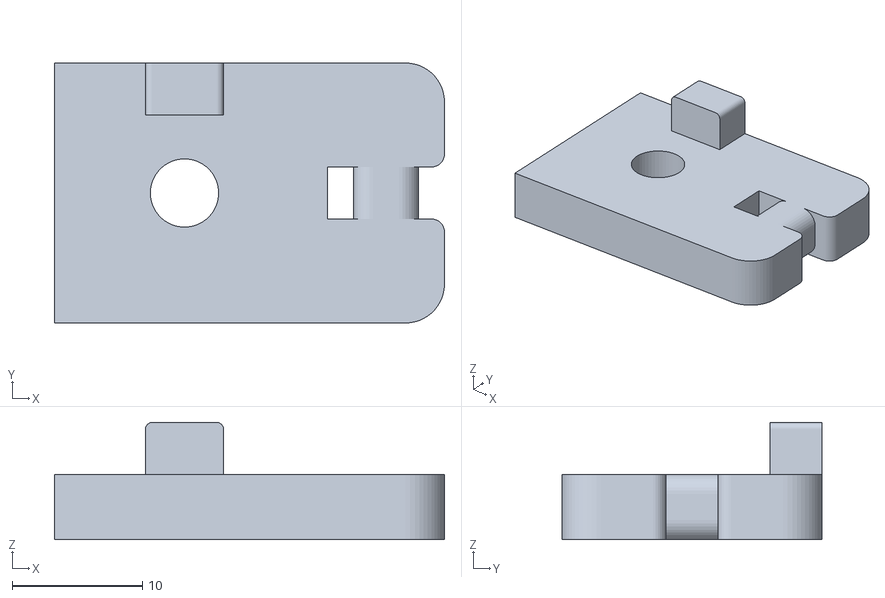
[picture p51: CAD file, 2022-01-09]
CAD/stl/rail wire clip v1.stl
30.0 x 20.0 x 9.00
