reubenstr/MelodicChimes/CAD/stl/pcb - opamp - level block v2.stl

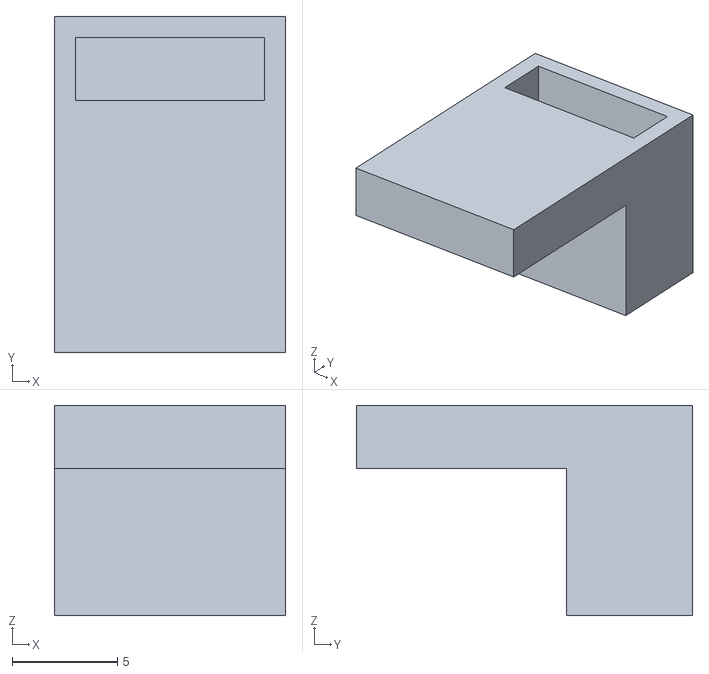
[picture p52: CAD file, 2022-01-09]
CAD/stl/pcb - opamp - level block v2.stl
11.0 x 16.0 x 10.0
