reubenstr/MelodicChimes/CAD/stl/frame hanger v5.stl

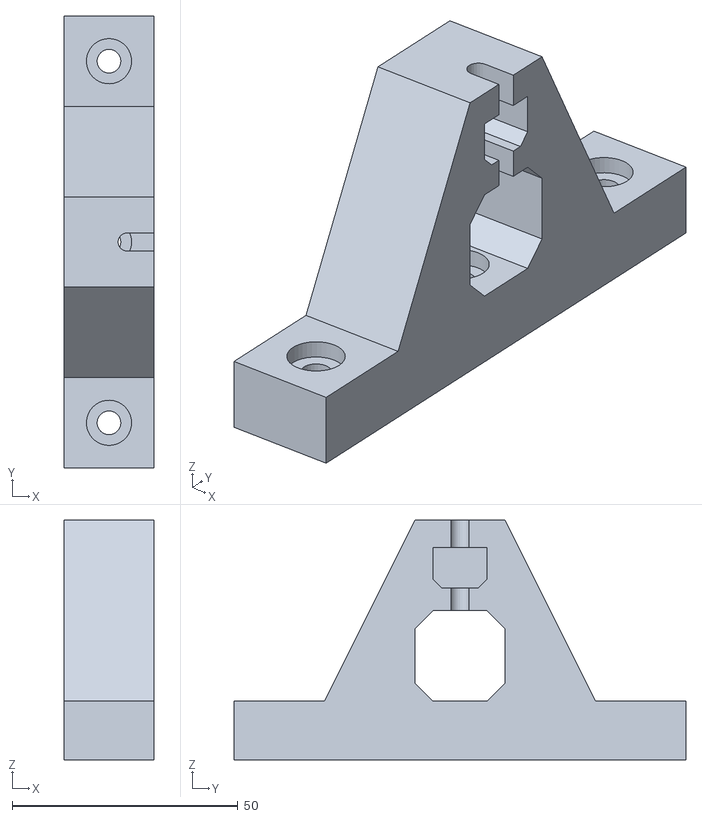
[picture p53: CAD file, 2022-01-09]
CAD/stl/frame hanger v5.stl
20.0 x 100.0 x 53.0
