reubenstr/MelodicChimes/CAD/stl/lower bridge v2.stl

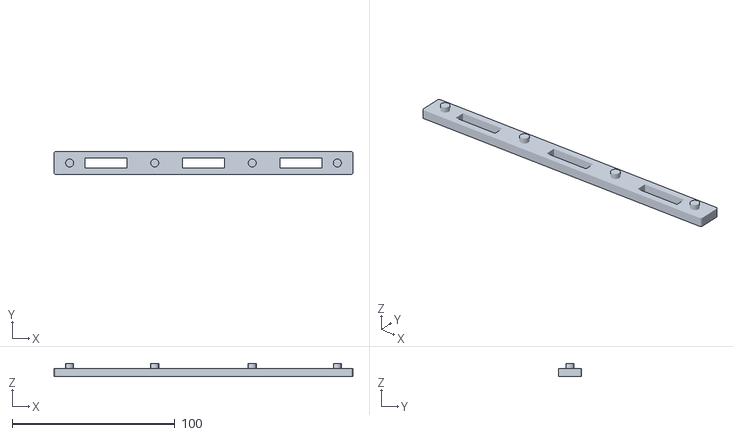
[picture p54: CAD file, 2022-01-09]
CAD/stl/lower bridge v2.stl
184.0 x 14.0 x 8.00
