reubenstr/MelodicChimes/CAD/stl/tuning peg - upper cover v12.stl

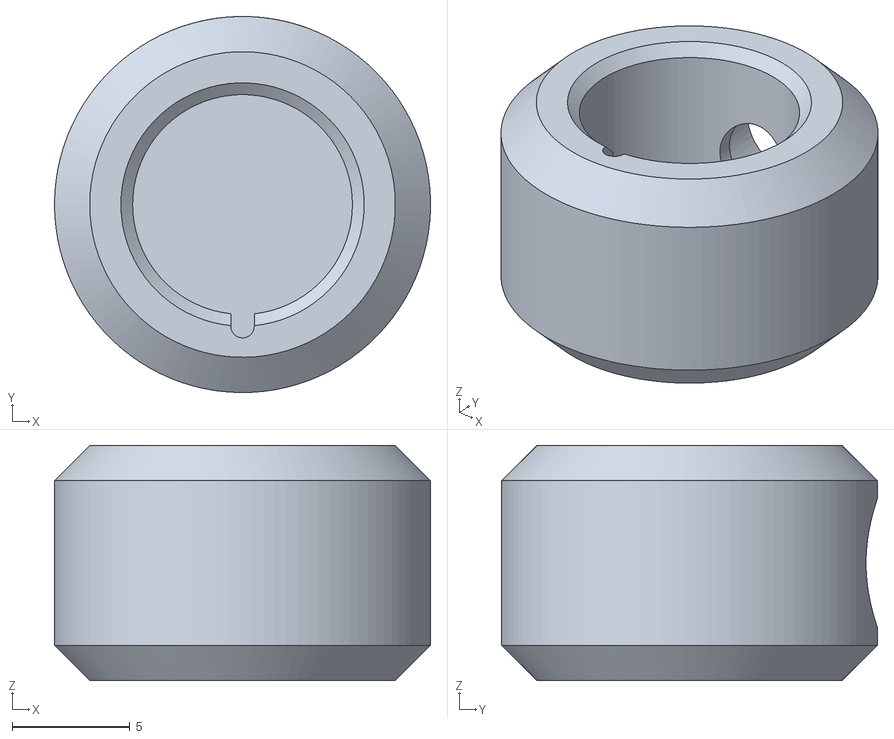
[picture p55: CAD file, 2022-01-09]
CAD/stl/tuning peg - upper cover v12.stl
16.0 x 16.0 x 10.0
