reubenstr/MelodicChimes/CAD/stl/volume cam v23.stl

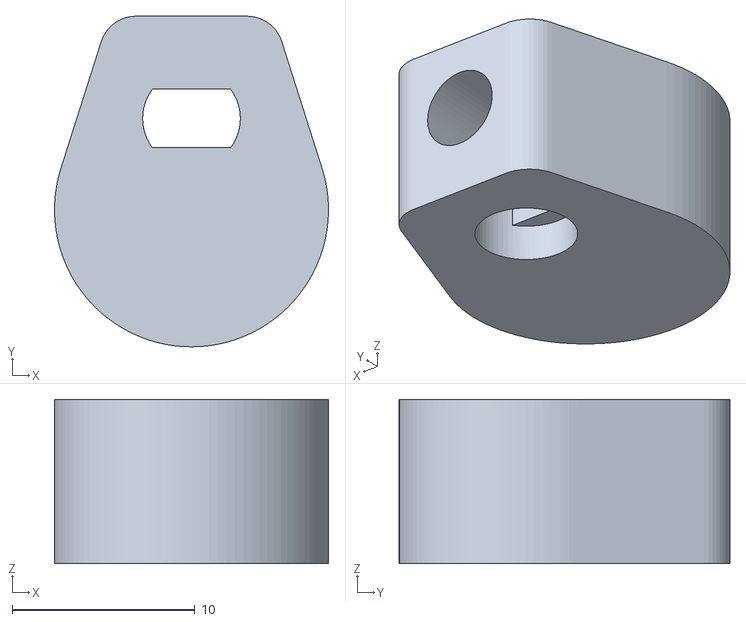
[picture p56: CAD file, 2022-01-09]
CAD/stl/volume cam v23.stl
15.0 x 18.1 x 9.00
