reubenstr/MelodicChimes/CAD/stl/name plate clip v3.stl

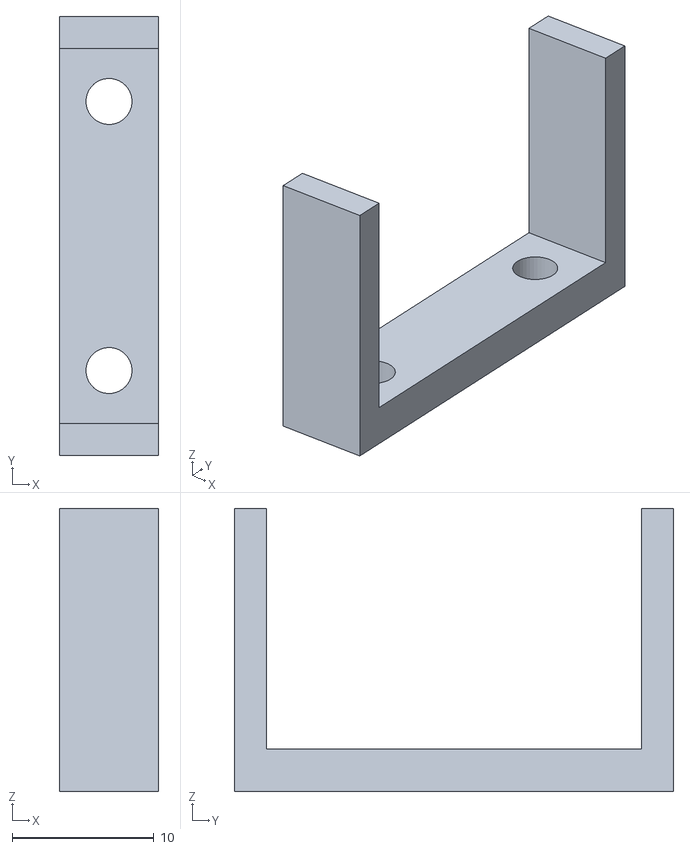
[picture p57: CAD file, 2022-01-09]
CAD/stl/name plate clip v3.stl
7.00 x 31.0 x 20.0
