reubenstr/MelodicChimes/CAD/stl/rail wire clip - thin v3.stl

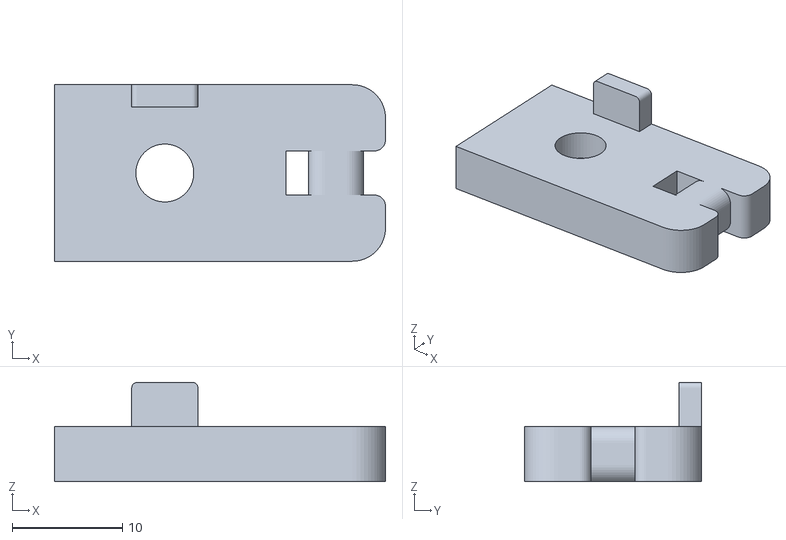
[picture p58: CAD file, 2022-01-09]
CAD/stl/rail wire clip - thin v3.stl
30.0 x 16.0 x 9.00
