reubenstr/MelodicChimes/CAD/stl/plectrum v14.stl

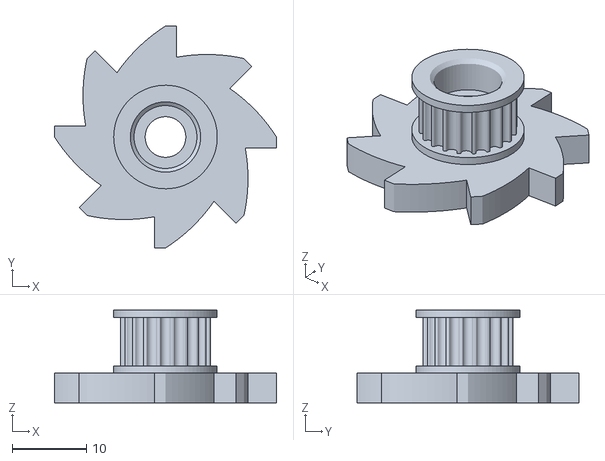
[picture p59: CAD file, 2022-01-09]
CAD/stl/plectrum v14.stl
30.0 x 30.0 x 12.5
