reubenstr/MelodicChimes/CAD/stl/tuning peg - lower cover v4.stl

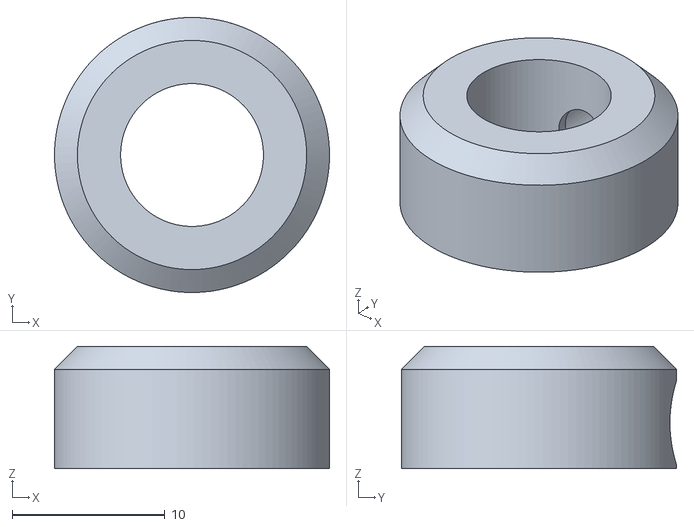
[picture p60: CAD file, 2022-01-09]
CAD/stl/tuning peg - lower cover v4.stl
18.0 x 18.0 x 8.00
