reubenstr/MelodicChimes/CAD/stl/plectrum bracket v17.stl

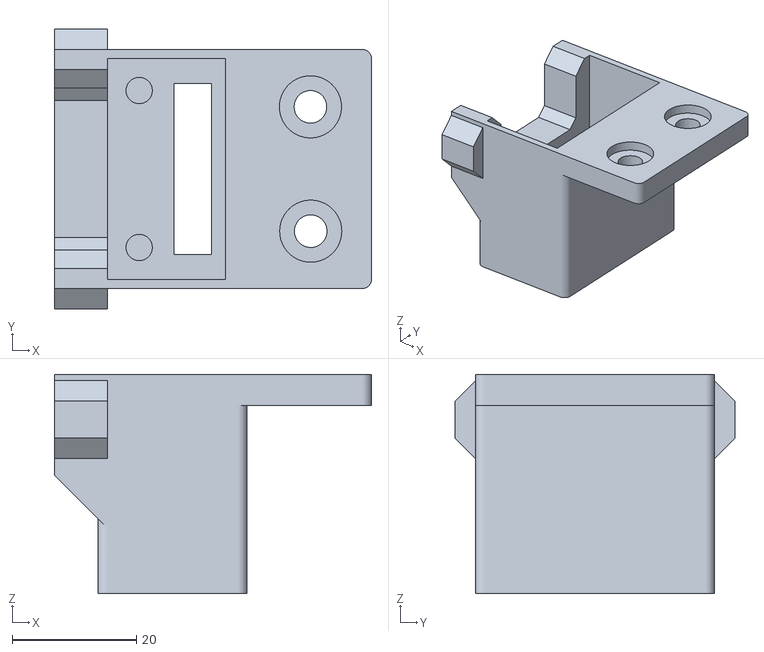
[picture p61: CAD file, 2022-01-09]
CAD/stl/plectrum bracket v17.stl
51.0 x 45.0 x 35.2
