reubenstr/MelodicChimes/CAD/stl/pick cam v15.stl

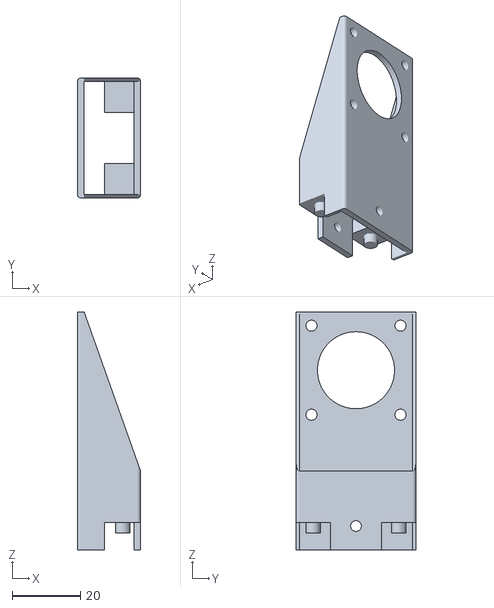
[picture p62: CAD file, 2022-01-09]
CAD/stl/pick cam v15.stl
18.5 x 35.0 x 69.5
