reubenstr/MelodicChimes/CAD/stl/sound box riser v5.stl

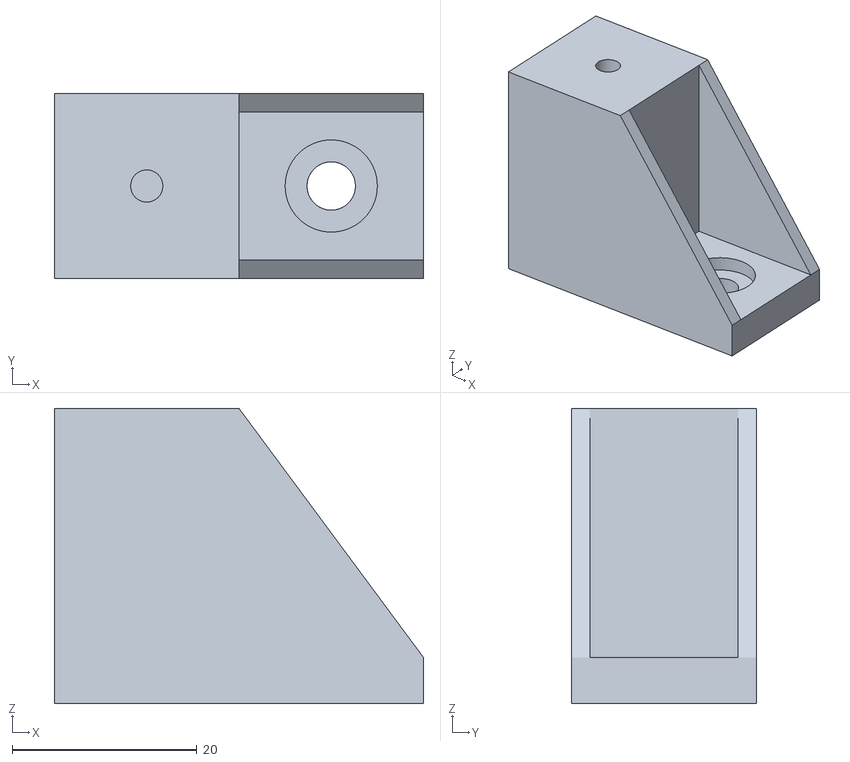
[picture p63: CAD file, 2022-01-09]
CAD/stl/sound box riser v5.stl
40.0 x 20.0 x 32.0
