reubenstr/MelodicChimes/CAD/stl/tuning motor bracket v8.stl

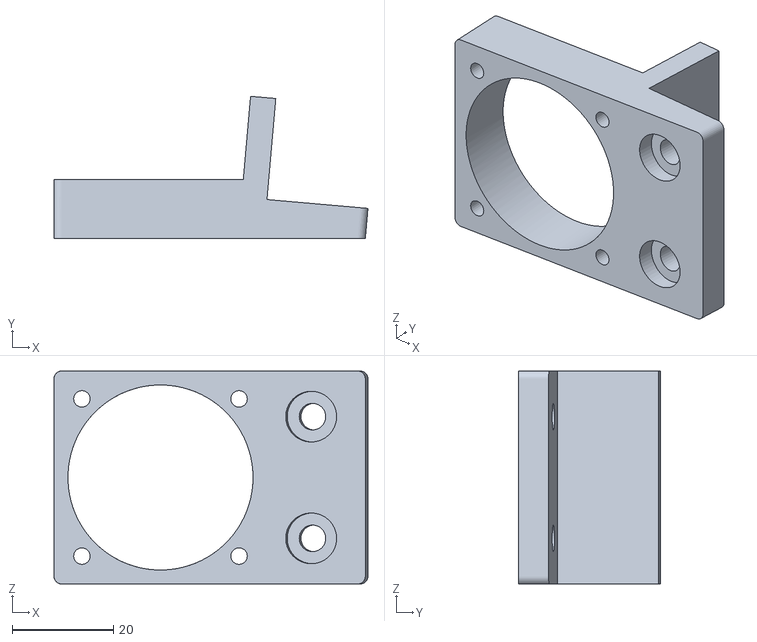
[picture p64: CAD file, 2022-01-09]
CAD/stl/tuning motor bracket v8.stl
61.9 x 28.1 x 42.0
