reubenstr/MelodicChimes/images/melodic-chimes-3d-printer-wall-mount.jpg

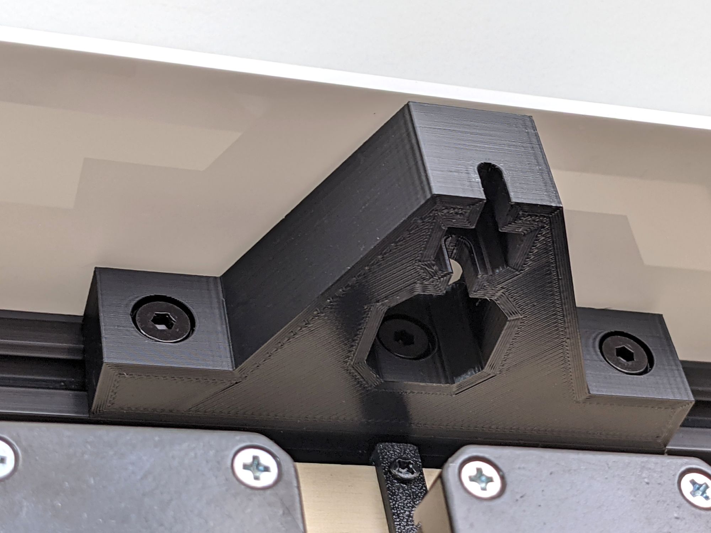
images/melodic-chimes-3d-printer-wall-mount.jpg
