reubenstr/MelodicChimes/notes/datasheets/tmc2208-step-table.png

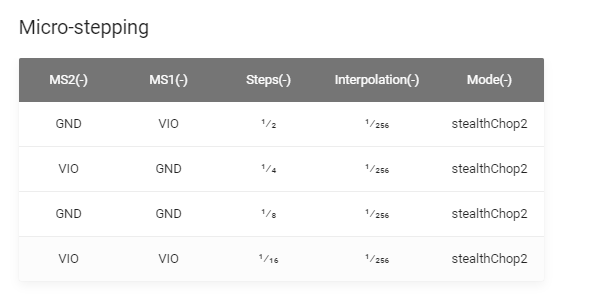
notes/datasheets/tmc2208-step-table.png
