reubenstr/MelodicChimes/notes/debug-timing-tests-2.txt

> Executing task: C:\Users\Dr. Zoidburg\.platformio\penv\Scripts\pio.exe device monitor <

--- Available filters and text transformations: colorize, debug, default, direct, hexlify, log2file, nocontrol, printable, send_on_enter, time
--- More details at http://bit.ly/pio-monitor-filters
--- Miniterm on COM9  115200,8,N,1 ---
--- Quit: Ctrl+C | Menu: Ctrl+T | Help: Ctrl+T followed by Ctrl+H ---
Teensy starting up.
New note: 63
StepTune: Target position: 244 (noteID: 63 | freq: 311.13)
   1 (   0ms) | Detected: 481.85 | Target: 311.13 | Delta: -170.72 | Target Position: -100 | DOWN | Step Speed:   -66 | Current Position: 244
   2 (  14ms) | Detected: 481.93 | Target: 311.13 | Delta: -170.81 | Target Position: -100 | DOWN | Step Speed:  -168 | Current Position: 242
   3 (  14ms) | Detected: 481.80 | Target: 311.13 | Delta: -170.68 | Target Position: -100 | DOWN | Step Speed:  -245 | Current Position: 239
   4 (  14ms) | Detected: 481.55 | Target: 311.13 | Delta: -170.42 | Target Position: -100 | DOWN | Step Speed:  -316 | Current Position: 235
   5 (  14ms) | Detected: 478.84 | Target: 311.13 | Delta: -167.71 | Target Position: -100 | DOWN | Step Speed:  -385 | Current Position: 230
   6 (  14ms) | Detected: 477.70 | Target: 311.13 | Delta: -166.57 | Target Position: -100 | DOWN | Step Speed:  -452 | Current Position: 224
   7 (  14ms) | Detected: 478.29 | Target: 311.13 | Delta: -167.16 | Target Position: -100 | DOWN | Step Speed:  -518 | Current Position: 217
   8 (  14ms) | Detected: 476.47 | Target: 311.13 | Delta: -165.35 | Target Position: -100 | DOWN | Step Speed:  -576 | Current Position: 210
   9 (  14ms) | Detected: 475.74 | Target: 311.13 | Delta: -164.61 | Target Position: -100 | DOWN | Step Speed:  -636 | Current Position: 202
  10 (  14ms) | Detected: 474.20 | Target: 311.13 | Delta: -163.08 | Target Position: -100 | DOWN | Step Speed:  -696 | Current Position: 193
  11 (  14ms) | Detected: 472.79 | Target: 311.13 | Delta: -161.66 | Target Position: -100 | DOWN | Step Speed:  -756 | Current Position: 183
  12 (  15ms) | Detected: 471.46 | Target: 311.13 | Delta: -160.33 | Target Position: -100 | DOWN | Step Speed:  -817 | Current Position: 172
  13 (  14ms) | Detected: 470.36 | Target: 311.13 | Delta: -159.23 | Target Position: -100 | DOWN | Step Speed:  -846 | Current Position: 161
  14 (  15ms) | Detected: 468.23 | Target: 311.13 | Delta: -157.11 | Target Position: -100 | DOWN | Step Speed:  -847 | Current Position: 150
  15 (  43ms) | Detected: 461.40 | Target: 311.13 | Delta: -150.28 | Target Position: -100 | DOWN | Step Speed:  -735 | Current Position: 117
  16 (  14ms) | Detected: 460.45 | Target: 311.13 | Delta: -149.33 | Target Position: -100 | DOWN | Step Speed:  -794 | Current Position: 107
  17 (  14ms) | Detected: 459.46 | Target: 311.13 | Delta: -148.33 | Target Position: -100 | DOWN | Step Speed:  -853 | Current Position: 96
  18 (  14ms) | Detected: 455.37 | Target: 311.13 | Delta: -144.24 | Target Position: -100 | DOWN | Step Speed:  -844 | Current Position: 85
  19 (  14ms) | Detected: 452.95 | Target: 311.13 | Delta: -141.83 | Target Position: -100 | DOWN | Step Speed:  -845 | Current Position: 74
  20 (  14ms) | Detected: 451.08 | Target: 311.13 | Delta: -139.95 | Target Position: -100 | DOWN | Step Speed:  -840 | Current Position: 62
  21 (  14ms) | Detected: 448.85 | Target: 311.13 | Delta: -137.73 | Target Position: -100 | DOWN | Step Speed:  -845 | Current Position: 50
  22 (  14ms) | Detected: 444.50 | Target: 311.13 | Delta: -133.37 | Target Position: -100 | DOWN | Step Speed:  -841 | Current Position: 38
  23 (  29ms) | Detected: 439.56 | Target: 311.13 | Delta: -128.43 | Target Position: -100 | DOWN | Step Speed:  -792 | Current Position: 15
  24 (  14ms) | Detected: 437.42 | Target: 311.13 | Delta: -126.29 | Target Position: -100 | DOWN | Step Speed:  -847 | Current Position: 5
  25 (  14ms) | Detected: 435.75 | Target: 311.13 | Delta: -124.62 | Target Position: -100 | DOWN | Step Speed:  -847 | Current Position: -6
  26 (  14ms) | Detected: 433.37 | Target: 311.13 | Delta: -122.25 | Target Position: -100 | DOWN | Step Speed:  -842 | Current Position: -18
  27 (  14ms) | Detected: 430.83 | Target: 311.13 | Delta: -119.70 | Target Position: -100 | DOWN | Step Speed:  -852 | Current Position: -29
  28 (  14ms) | Detected: 429.05 | Target: 311.13 | Delta: -117.92 | Target Position: -100 | DOWN | Step Speed:  -848 | Current Position: -41
  29 (  14ms) | Detected: 426.44 | Target: 311.13 | Delta: -115.32 | Target Position: -100 | DOWN | Step Speed:  -848 | Current Position: -52
  30 (  14ms) | Detected: 425.49 | Target: 311.13 | Delta: -114.36 | Target Position: -100 | DOWN | Step Speed:  -849 | Current Position: -63
  31 (  14ms) | Detected: 424.42 | Target: 311.13 | Delta: -113.30 | Target Position: -100 | DOWN | Step Speed:  -849 | Current Position: -74
  32 (  29ms) | Detected: 418.26 | Target: 311.13 | Delta: -107.13 | Target Position: -100 | DOWN | Step Speed:  -796 | Current Position: -96
  33 (  14ms) | Detected: 416.73 | Target: 311.13 | Delta: -105.60 | Target Position: -100 | DOWN | Step Speed:  -845 | Current Position: -107
  34 (  14ms) | Detected: 413.84 | Target: 311.13 | Delta: -102.71 | Target Position: -100 | DOWN | Step Speed:  -841 | Current Position: -119
  35 (  14ms) | Detected: 412.47 | Target: 311.13 | Delta: -101.35 | Target Position: -100 | DOWN | Step Speed:  -851 | Current Position: -130
  36 (  14ms) | Detected: 409.88 | Target: 311.13 | Delta:  -98.75 | Target Position: -100 | DOWN | Step Speed:  -851 | Current Position: -141
  37 (  14ms) | Detected: 407.01 | Target: 311.13 | Delta:  -95.88 | Target Position: -100 | DOWN | Step Speed:  -851 | Current Position: -152
  38 (  14ms) | Detected: 405.20 | Target: 311.13 | Delta:  -94.08 | Target Position: -100 | DOWN | Step Speed:  -852 | Current Position: -163
  39 (  29ms) | Detected: 400.21 | Target: 311.13 | Delta:  -89.09 | Target Position: -100 | DOWN | Step Speed:  -798 | Current Position: -185
  40 (  14ms) | Detected: 397.72 | Target: 311.13 | Delta:  -86.60 | Target Position: -100 | DOWN | Step Speed:  -848 | Current Position: -196
  41 (  14ms) | Detected: 395.51 | Target: 311.13 | Delta:  -84.39 | Target Position: -100 | DOWN | Step Speed:  -848 | Current Position: -207
  42 (  15ms) | Detected: 392.69 | Target: 311.13 | Delta:  -81.56 | Target Position: -100 | DOWN | Step Speed:  -844 | Current Position: -219
  43 (  14ms) | Detected: 390.85 | Target: 311.13 | Delta:  -79.72 | Target Position: -100 | DOWN | Step Speed:  -844 | Current Position: -230
  44 (  15ms) | Detected: 387.79 | Target: 311.13 | Delta:  -76.67 | Target Position: -100 | DOWN | Step Speed:  -845 | Current Position: -241
  45 (  29ms) | Detected: 384.27 | Target: 311.13 | Delta:  -73.14 | Target Position: -100 | DOWN | Step Speed:  -786 | Current Position: -264
  46 (  14ms) | Detected: 380.99 | Target: 311.13 | Delta:  -69.86 | Target Position: -100 | DOWN | Step Speed:  -846 | Current Position: -275
  47 (  14ms) | Detected: 378.76 | Target: 311.13 | Delta:  -67.64 | Target Position: -100 | DOWN | Step Speed:  -841 | Current Position: -287
  48 (  14ms) | Detected: 377.10 | Target: 311.13 | Delta:  -65.97 | Target Position: -100 | DOWN | Step Speed:  -846 | Current Position: -299
  49 (  14ms) | Detected: 373.62 | Target: 311.13 | Delta:  -62.49 | Target Position: -100 | DOWN | Step Speed:  -847 | Current Position: -310
  50 (  14ms) | Detected: 370.86 | Target: 311.13 | Delta:  -59.73 | Target Position: -100 | DOWN | Step Speed:  -842 | Current Position: -322
  51 (  28ms) | Detected: 365.58 | Target: 311.13 | Delta:  -54.45 | Target Position: -100 | DOWN | Step Speed:  -799 | Current Position: -344
  52 (  14ms) | Detected: 361.91 | Target: 311.13 | Delta:  -50.78 | Target Position: -100 | DOWN | Step Speed:  -848 | Current Position: -355
  53 (  14ms) | Detected: 359.19 | Target: 311.13 | Delta:  -48.07 | Target Position: -100 | DOWN | Step Speed:  -844 | Current Position: -367
  54 (  14ms) | Detected: 355.96 | Target: 311.13 | Delta:  -44.83 | Target Position: -100 | DOWN | Step Speed:  -844 | Current Position: -378
  55 (  16ms) | Detected: 351.42 | Target: 311.13 | Delta:  -40.29 | Target Position: -100 | DOWN | Step Speed:  -835 | Current Position: -391
  56 (  14ms) | Detected: 349.07 | Target: 311.13 | Delta:  -37.95 | Target Position: -100 | DOWN | Step Speed:  -845 | Current Position: -402
  57 (  14ms) | Detected: 345.74 | Target: 311.13 | Delta:  -34.62 | Target Position: -100 | DOWN | Step Speed:  -845 | Current Position: -413
  58 (  14ms) | Detected: 342.64 | Target: 311.13 | Delta:  -31.51 | Target Position: -100 | DOWN | Step Speed:  -845 | Current Position: -424
  59 (  14ms) | Detected: 338.68 | Target: 311.13 | Delta:  -27.56 | Target Position: -100 | DOWN | Step Speed:  -846 | Current Position: -435
  60 (  14ms) | Detected: 334.80 | Target: 311.13 | Delta:  -23.67 | Target Position: -100 | DOWN | Step Speed:  -846 | Current Position: -446
  61 (  14ms) | Detected: 331.05 | Target: 311.13 | Delta:  -19.93 | Target Position: -90 | DOWN | Step Speed:  -846 | Current Position: -457
  62 (  29ms) | Detected: 324.36 | Target: 311.13 | Delta:  -13.24 | Target Position: -60 | DOWN | Step Speed:  -730 | Current Position: -479
  63 (  14ms) | Detected: 320.71 | Target: 311.13 | Delta:   -9.58 | Target Position: -43 | DOWN | Step Speed:  -666 | Current Position: -489
  64 (  15ms) | Detected: 317.56 | Target: 311.13 | Delta:   -6.44 | Target Position: -29 | DOWN | Step Speed:  -610 | Current Position: -497
  65 (  14ms) | Detected: 315.12 | Target: 311.13 | Delta:   -4.00 | Target Position: -18 | DOWN | Step Speed:  -548 | Current Position: -505
  66 (  14ms) | Detected: 312.52 | Target: 311.13 | Delta:   -1.39 | Target Position:  -6 | DOWN | Step Speed:  -486 | Current Position: -512
  67 (  14ms) | Detected: 311.06 | Target: 311.13 | Delta:    0.07 | Target Position:   0 | STOP | Step Speed:  -434 | Current Position: -518
  68 (  14ms) | Detected: 309.04 | Target: 311.13 | Delta:    2.08 | Target Position:   9 |   UP | Step Speed:  -363 | Current Position: -524
  69 (  14ms) | Detected: 307.32 | Target: 311.13 | Delta:    3.81 | Target Position:  17 |   UP | Step Speed:  -290 | Current Position: -529
  70 (  14ms) | Detected: 305.94 | Target: 311.13 | Delta:    5.19 | Target Position:  23 |   UP | Step Speed:  -210 | Current Position: -533
  71 (  14ms) | Detected: 304.70 | Target: 311.13 | Delta:    6.43 | Target Position:  29 |   UP | Step Speed:  -142 | Current Position: -535
  72 (  14ms) | Detected: 303.47 | Target: 311.13 | Delta:    7.66 | Target Position:  34 |   UP | Step Speed:    66 | Current Position: -537
  73 (  14ms) | Detected: 302.82 | Target: 311.13 | Delta:    8.31 | Target Position:  37 |   UP | Step Speed:   142 | Current Position: -536
  74 (  14ms) | Detected: 302.39 | Target: 311.13 | Delta:    8.73 | Target Position:  39 |   UP | Step Speed:   210 | Current Position: -534
  75 (  14ms) | Detected: 302.48 | Target: 311.13 | Delta:    8.65 | Target Position:  39 |   UP | Step Speed:   290 | Current Position: -530
  76 (  14ms) | Detected: 302.49 | Target: 311.13 | Delta:    8.64 | Target Position:  39 |   UP | Step Speed:   352 | Current Position: -526
  77 (  14ms) | Detected: 302.40 | Target: 311.13 | Delta:    8.72 | Target Position:  39 |   UP | Step Speed:   415 | Current Position: -521
  78 (  14ms) | Detected: 302.82 | Target: 311.13 | Delta:    8.30 | Target Position:  37 |   UP | Step Speed:   477 | Current Position: -515
  79 (  14ms) | Detected: 302.62 | Target: 311.13 | Delta:    8.50 | Target Position:  38 |   UP | Step Speed:   502 | Current Position: -509
  80 (  14ms) | Detected: 303.32 | Target: 311.13 | Delta:    7.81 | Target Position:  35 |   UP | Step Speed:   511 | Current Position: -503
  81 (  14ms) | Detected: 304.70 | Target: 311.13 | Delta:    6.43 | Target Position:  29 |   UP | Step Speed:   479 | Current Position: -496
  82 (  14ms) | Detected: 305.17 | Target: 311.13 | Delta:    5.96 | Target Position:  27 |   UP | Step Speed:   445 | Current Position: -491
New note: 64
StepTune: Target position: 59 (noteID: 64 | freq: 329.63)
   0 ( 275ms) | Detected: 329.10 | Target: 329.63 | Delta:    0.53 | Target Position:   0 | STOP | Step Speed:     0 | Current Position: 59
   1 (  14ms) | Detected: 330.66 | Target: 329.63 | Delta:   -1.03 | Target Position:  -4 | DOWN | Step Speed:   -66 | Current Position: 59
   2 (  14ms) | Detected: 330.27 | Target: 329.63 | Delta:   -0.65 | Target Position:   0 | STOP | Step Speed:  -168 | Current Position: 57
   3 (  14ms) | Detected: 328.57 | Target: 329.63 | Delta:    1.06 | Target Position:   4 |   UP | Step Speed:   -66 | Current Position: 55
   4 (  14ms) | Detected: 328.16 | Target: 329.63 | Delta:    1.47 | Target Position:   6 |   UP | Step Speed:   110 | Current Position: 54
   5 (  14ms) | Detected: 328.21 | Target: 329.63 | Delta:    1.42 | Target Position:   6 |   UP | Step Speed:   190 | Current Position: 56
   6 (  14ms) | Detected: 328.32 | Target: 329.63 | Delta:    1.31 | Target Position:   5 |   UP | Step Speed:   198 | Current Position: 59
   7 (  14ms) | Detected: 330.04 | Target: 329.63 | Delta:   -0.42 | Target Position:   0 | STOP | Step Speed:   115 | Current Position: 61
   8 (  14ms) | Detected: 328.75 | Target: 329.63 | Delta:    0.88 | Target Position:   0 | STOP | Step Speed:     0 | Current Position: 62
   9 (  14ms) | Detected: 329.61 | Target: 329.63 | Delta:    0.02 | Target Position:   0 | STOP | Step Speed:     0 | Current Position: 62
  10 (  14ms) | Detected: 330.16 | Target: 329.63 | Delta:   -0.53 | Target Position:   0 | STOP | Step Speed:     0 | Current Position: 62
  11 (  14ms) | Detected: 328.94 | Target: 329.63 | Delta:    0.69 | Target Position:   0 | STOP | Step Speed:     0 | Current Position: 62
  12 (  14ms) | Detected: 330.24 | Target: 329.63 | Delta:   -0.61 | Target Position:   0 | STOP | Step Speed:     0 | Current Position: 62
  13 (  14ms) | Detected: 328.94 | Target: 329.63 | Delta:    0.68 | Target Position:   0 | STOP | Step Speed:     0 | Current Position: 62
  14 (  14ms) | Detected: 328.50 | Target: 329.63 | Delta:    1.13 | Target Position:   5 |   UP | Step Speed:    66 | Current Position: 62
  15 (  14ms) | Detected: 330.04 | Target: 329.63 | Delta:   -0.42 | Target Position:   0 | STOP | Step Speed:   168 | Current Position: 64
  16 (  14ms) | Detected: 329.41 | Target: 329.63 | Delta:    0.22 | Target Position:   0 | STOP | Step Speed:     0 | Current Position: 66
  17 (  28ms) | Detected: 330.75 | Target: 329.63 | Delta:   -1.12 | Target Position:  -5 | DOWN | Step Speed:   -66 | Current Position: 66
  18 (  14ms) | Detected: 330.92 | Target: 329.63 | Delta:   -1.29 | Target Position:  -5 | DOWN | Step Speed:  -168 | Current Position: 64
  19 (  14ms) | Detected: 330.43 | Target: 329.63 | Delta:   -0.80 | Target Position:   0 | STOP | Step Speed:  -110 | Current Position: 61
  20 (  14ms) | Detected: 331.23 | Target: 329.63 | Delta:   -1.60 | Target Position:  -7 | DOWN | Step Speed:   -66 | Current Position: 60
  21 (  14ms) | Detected: 330.33 | Target: 329.63 | Delta:   -0.70 | Target Position:   0 | STOP | Step Speed:     0 | Current Position: 59
  22 (  14ms) | Detected: 330.29 | Target: 329.63 | Delta:   -0.66 | Target Position:   0 | STOP | Step Speed:     0 | Current Position: 59
  23 (  14ms) | Detected: 330.12 | Target: 329.63 | Delta:   -0.50 | Target Position:   0 | STOP | Step Speed:     0 | Current Position: 59
  24 (  14ms) | Detected: 329.97 | Target: 329.63 | Delta:   -0.34 | Target Position:   0 | STOP | Step Speed:     0 | Current Position: 59
  25 (  14ms) | Detected: 330.25 | Target: 329.63 | Delta:   -0.62 | Target Position:   0 | STOP | Step Speed:     0 | Current Position: 59
  26 (  14ms) | Detected: 330.43 | Target: 329.63 | Delta:   -0.80 | Target Position:   0 | STOP | Step Speed:     0 | Current Position: 59
  27 (  14ms) | Detected: 330.01 | Target: 329.63 | Delta:   -0.38 | Target Position:   0 | STOP | Step Speed:     0 | Current Position: 59
  28 (  14ms) | Detected: 329.72 | Target: 329.63 | Delta:   -0.09 | Target Position:   0 | STOP | Step Speed:     0 | Current Position: 59
  29 (  14ms) | Detected: 329.57 | Target: 329.63 | Delta:    0.06 | Target Position:   0 | STOP | Step Speed:     0 | Current Position: 59
  30 (  14ms) | Detected: 329.89 | Target: 329.63 | Delta:   -0.26 | Target Position:   0 | STOP | Step Speed:     0 | Current Position: 59
  31 (  14ms) | Detected: 330.20 | Target: 329.63 | Delta:   -0.57 | Target Position:   0 | STOP | Step Speed:     0 | Current Position: 59
  32 (  14ms) | Detected: 330.05 | Target: 329.63 | Delta:   -0.43 | Target Position:   0 | STOP | Step Speed:     0 | Current Position: 59
  33 (  14ms) | Detected: 329.74 | Target: 329.63 | Delta:   -0.11 | Target Position:   0 | STOP | Step Speed:     0 | Current Position: 59
  34 (  14ms) | Detected: 329.79 | Target: 329.63 | Delta:   -0.16 | Target Position:   0 | STOP | Step Speed:     0 | Current Position: 59
  35 (  14ms) | Detected: 330.09 | Target: 329.63 | Delta:   -0.46 | Target Position:   0 | STOP | Step Speed:     0 | Current Position: 59
  36 (  14ms) | Detected: 330.33 | Target: 329.63 | Delta:   -0.71 | Target Position:   0 | STOP | Step Speed:     0 | Current Position: 59
  37 (  14ms) | Detected: 330.31 | Target: 329.63 | Delta:   -0.69 | Target Position:   0 | STOP | Step Speed:     0 | Current Position: 59
  38 (  14ms) | Detected: 330.22 | Target: 329.63 | Delta:   -0.59 | Target Position:   0 | STOP | Step Speed:     0 | Current Position: 59
  39 (  14ms) | Detected: 329.79 | Target: 329.63 | Delta:   -0.17 | Target Position:   0 | STOP | Step Speed:     0 | Current Position: 59
  40 (  14ms) | Detected: 329.79 | Target: 329.63 | Delta:   -0.17 | Target Position:   0 | STOP | Step Speed:     0 | Current Position: 59
  41 (  14ms) | Detected: 329.89 | Target: 329.63 | Delta:   -0.26 | Target Position:   0 | STOP | Step Speed:     0 | Current Position: 59
  42 (  14ms) | Detected: 329.81 | Target: 329.63 | Delta:   -0.18 | Target Position:   0 | STOP | Step Speed:     0 | Current Position: 59
  43 (  15ms) | Detected: 329.99 | Target: 329.63 | Delta:   -0.36 | Target Position:   0 | STOP | Step Speed:     0 | Current Position: 59
  44 (  14ms) | Detected: 330.19 | Target: 329.63 | Delta:   -0.56 | Target Position:   0 | STOP | Step Speed:     0 | Current Position: 59
  45 (  15ms) | Detected: 330.38 | Target: 329.63 | Delta:   -0.75 | Target Position:   0 | STOP | Step Speed:     0 | Current Position: 59
  46 (  14ms) | Detected: 330.07 | Target: 329.63 | Delta:   -0.45 | Target Position:   0 | STOP | Step Speed:     0 | Current Position: 59
  47 (  15ms) | Detected: 329.86 | Target: 329.63 | Delta:   -0.24 | Target Position:   0 | STOP | Step Speed:     0 | Current Position: 59
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
  99 (  14ms) | Detected: 330.25 | Target: 329.63 | Delta:   -0.63 | Target Position:   0 | STOP | Step Speed:     0 | Current Position: 59
 100 (  14ms) | Detected: 329.90 | Target: 329.63 | Delta:   -0.27 | Target Position:   0 | STOP | Step Speed:     0 | Current Position: 59
 101 (  14ms) | Detected: 330.03 | Target: 329.63 | Delta:   -0.40 | Target Position:   0 | STOP | Step Speed:     0 | Current Position: 59
 102 (  14ms) | Detected: 329.95 | Target: 329.63 | Delta:   -0.33 | Target Position:   0 | STOP | Step Speed:     0 | Current Position: 59
 103 (  14ms) | Detected: 330.07 | Target: 329.63 | Delta:   -0.45 | Target Position:   0 | STOP | Step Speed:     0 | Current Position: 59
 104 (  14ms) | Detected: 330.12 | Target: 329.63 | Delta:   -0.49 | Target Position:   0 | STOP | Step Speed:     0 | Current Position: 59
 105 (  14ms) | Detected: 329.96 | Target: 329.63 | Delta:   -0.33 | Target Position:   0 | STOP | Step Speed:     0 | Current Position: 59
 106 (  14ms) | Detected: 330.44 | Target: 329.63 | Delta:   -0.81 | Target Position:   0 | STOP | Step Speed:     0 | Current Position: 59
 107 (  14ms) | Detected: 330.16 | Target: 329.63 | Delta:   -0.53 | Target Position:   0 | STOP | Step Speed:     0 | Current Position: 59
 108 (  14ms) | Detected: 330.39 | Target: 329.63 | Delta:   -0.76 | Target Position:   0 | STOP | Step Speed:     0 | Current Position: 59
 109 (  14ms) | Detected: 330.34 | Target: 329.63 | Delta:   -0.72 | Target Position:   0 | STOP | Step Speed:     0 | Current Position: 59
 110 (  14ms) | Detected: 330.35 | Target: 329.63 | Delta:   -0.72 | Target Position:   0 | STOP | Step Speed:     0 | Current Position: 59
 111 (  14ms) | Detected: 330.25 | Target: 329.63 | Delta:   -0.62 | Target Position:   0 | STOP | Step Speed:     0 | Current Position: 59
 112 (  14ms) | Detected: 330.15 | Target: 329.63 | Delta:   -0.52 | Target Position:   0 | STOP | Step Speed:     0 | Current Position: 59
 113 (  14ms) | Detected: 330.00 | Target: 329.63 | Delta:   -0.38 | Target Position:   0 | STOP | Step Speed:     0 | Current Position: 59
 114 (  14ms) | Detected: 330.25 | Target: 329.63 | Delta:   -0.62 | Target Position:   0 | STOP | Step Speed:     0 | Current Position: 59
 115 (  14ms) | Detected: 330.20 | Target: 329.63 | Delta:   -0.57 | Target Position:   0 | STOP | Step Speed:     0 | Current Position: 59
 116 (  15ms) | Detected: 330.47 | Target: 329.63 | Delta:   -0.84 | Target Position:   0 | STOP | Step Speed:     0 | Current Position: 59
 117 (  14ms) | Detected: 330.50 | Target: 329.63 | Delta:   -0.88 | Target Position:   0 | STOP | Step Speed:     0 | Current Position: 59
 118 (  15ms) | Detected: 330.28 | Target: 329.63 | Delta:   -0.65 | Target Position:   0 | STOP | Step Speed:     0 | Current Position: 59
New note: 65
StepTune: Target position: 68 (noteID: 65 | freq: 349.23)
   0 ( 493ms) | Detected: 351.68 | Target: 349.23 | Delta:   -2.45 | Target Position: -11 | DOWN | Step Speed:   -66 | Current Position: 68
   1 (  43ms) | Detected: 350.91 | Target: 349.23 | Delta:   -1.69 | Target Position:  -7 | DOWN | Step Speed:  -198 | Current Position: 61
   2 (  14ms) | Detected: 351.01 | Target: 349.23 | Delta:   -1.78 | Target Position:  -8 | DOWN | Step Speed:  -212 | Current Position: 58
   3 (  14ms) | Detected: 350.67 | Target: 349.23 | Delta:   -1.44 | Target Position:  -6 | DOWN | Step Speed:  -221 | Current Position: 55
   4 (  14ms) | Detected: 350.40 | Target: 349.23 | Delta:   -1.17 | Target Position:  -5 | DOWN | Step Speed:  -192 | Current Position: 52
   5 (  14ms) | Detected: 349.02 | Target: 349.23 | Delta:    0.21 | Target Position:   0 | STOP | Step Speed:  -111 | Current Position: 50
   6 (  14ms) | Detected: 346.70 | Target: 349.23 | Delta:    2.53 | Target Position:  11 |   UP | Step Speed:    66 | Current Position: 49
   7 (  14ms) | Detected: 346.09 | Target: 349.23 | Delta:    3.14 | Target Position:  14 |   UP | Step Speed:   168 | Current Position: 51
   8 (  14ms) | Detected: 346.38 | Target: 349.23 | Delta:    2.85 | Target Position:  12 |   UP | Step Speed:   245 | Current Position: 54
   9 (  14ms) | Detected: 346.65 | Target: 349.23 | Delta:    2.58 | Target Position:  11 |   UP | Step Speed:   278 | Current Position: 57
  10 (  14ms) | Detected: 347.31 | Target: 349.23 | Delta:    1.92 | Target Position:   8 |   UP | Step Speed:   266 | Current Position: 61
  11 (  14ms) | Detected: 348.31 | Target: 349.23 | Delta:    0.92 | Target Position:   0 | STOP | Step Speed:   171 | Current Position: 65
  12 (  14ms) | Detected: 349.92 | Target: 349.23 | Delta:   -0.69 | Target Position:   0 | STOP | Step Speed:     0 | Current Position: 67
  13 (  14ms) | Detected: 351.42 | Target: 349.23 | Delta:   -2.19 | Target Position:  -9 | DOWN | Step Speed:   -66 | Current Position: 67
  14 (  14ms) | Detected: 351.32 | Target: 349.23 | Delta:   -2.09 | Target Position:  -9 | DOWN | Step Speed:  -168 | Current Position: 65
  15 (  14ms) | Detected: 351.46 | Target: 349.23 | Delta:   -2.23 | Target Position: -10 | DOWN | Step Speed:  -245 | Current Position: 62
  16 (  14ms) | Detected: 351.13 | Target: 349.23 | Delta:   -1.90 | Target Position:  -8 | DOWN | Step Speed:  -232 | Current Position: 58
  17 (  14ms) | Detected: 350.72 | Target: 349.23 | Delta:   -1.49 | Target Position:  -6 | DOWN | Step Speed:  -239 | Current Position: 55
  18 (  14ms) | Detected: 350.08 | Target: 349.23 | Delta:   -0.85 | Target Position:   0 | STOP | Step Speed:  -163 | Current Position: 52
  19 (  14ms) | Detected: 348.21 | Target: 349.23 | Delta:    1.02 | Target Position:   4 |   UP | Step Speed:   -64 | Current Position: 50
  20 (  14ms) | Detected: 347.90 | Target: 349.23 | Delta:    1.33 | Target Position:   6 |   UP | Step Speed:   110 | Current Position: 49
  21 (  14ms) | Detected: 347.23 | Target: 349.23 | Delta:    1.99 | Target Position:   9 |   UP | Step Speed:   190 | Current Position: 51
  22 (  14ms) | Detected: 347.46 | Target: 349.23 | Delta:    1.76 | Target Position:   8 |   UP | Step Speed:   232 | Current Position: 54
  23 (  14ms) | Detected: 348.29 | Target: 349.23 | Delta:    0.94 | Target Position:   0 | STOP | Step Speed:   195 | Current Position: 57
  24 (  14ms) | Detected: 348.41 | Target: 349.23 | Delta:    0.82 | Target Position:   0 | STOP | Step Speed:   113 | Current Position: 59
  25 (  14ms) | Detected: 347.91 | Target: 349.23 | Delta:    1.32 | Target Position:   5 |   UP | Step Speed:    66 | Current Position: 60
  26 (  14ms) | Detected: 348.96 | Target: 349.23 | Delta:    0.27 | Target Position:   0 | STOP | Step Speed:   168 | Current Position: 62
  27 (  14ms) | Detected: 348.94 | Target: 349.23 | Delta:    0.28 | Target Position:   0 | STOP | Step Speed:     0 | Current Position: 64
  28 (  14ms) | Detected: 349.95 | Target: 349.23 | Delta:   -0.72 | Target Position:   0 | STOP | Step Speed:     0 | Current Position: 64
  29 (  14ms) | Detected: 350.73 | Target: 349.23 | Delta:   -1.50 | Target Position:  -6 | DOWN | Step Speed:   -66 | Current Position: 64
  30 (  14ms) | Detected: 350.27 | Target: 349.23 | Delta:   -1.05 | Target Position:  -4 | DOWN | Step Speed:  -142 | Current Position: 62
  31 (  14ms) | Detected: 349.59 | Target: 349.23 | Delta:   -0.36 | Target Position:   0 | STOP | Step Speed:  -110 | Current Position: 60
  32 (  14ms) | Detected: 349.72 | Target: 349.23 | Delta:   -0.49 | Target Position:   0 | STOP | Step Speed:     0 | Current Position: 59
  33 (  14ms) | Detected: 349.51 | Target: 349.23 | Delta:   -0.28 | Target Position:   0 | STOP | Step Speed:     0 | Current Position: 59
  34 (  14ms) | Detected: 349.52 | Target: 349.23 | Delta:   -0.30 | Target Position:   0 | STOP | Step Speed:     0 | Current Position: 59
  35 (  14ms) | Detected: 349.80 | Target: 349.23 | Delta:   -0.57 | Target Position:   0 | STOP | Step Speed:     0 | Current Position: 59
  36 (  14ms) | Detected: 349.89 | Target: 349.23 | Delta:   -0.66 | Target Position:   0 | STOP | Step Speed:     0 | Current Position: 59
  37 (  14ms) | Detected: 349.85 | Target: 349.23 | Delta:   -0.62 | Target Position:   0 | STOP | Step Speed:     0 | Current Position: 59
  38 (  14ms) | Detected: 349.58 | Target: 349.23 | Delta:   -0.35 | Target Position:   0 | STOP | Step Speed:     0 | Current Position: 59
  39 (  14ms) | Detected: 350.32 | Target: 349.23 | Delta:   -1.09 | Target Position:  -4 | DOWN | Step Speed:   -66 | Current Position: 59
  40 (  14ms) | Detected: 349.53 | Target: 349.23 | Delta:   -0.30 | Target Position:   0 | STOP | Step Speed:  -168 | Current Position: 57
  41 (  14ms) | Detected: 349.27 | Target: 349.23 | Delta:   -0.04 | Target Position:   0 | STOP | Step Speed:     0 | Current Position: 55
  42 (  14ms) | Detected: 349.23 | Target: 349.23 | Delta:    0.00 | Target Position:   0 | STOP | Step Speed:     0 | Current Position: 55
  43 (  14ms) | Detected: 348.26 | Target: 349.23 | Delta:    0.97 | Target Position:   0 | STOP | Step Speed:     0 | Current Position: 55
  44 (  14ms) | Detected: 348.19 | Target: 349.23 | Delta:    1.04 | Target Position:   4 |   UP | Step Speed:    66 | Current Position: 55
  45 (  14ms) | Detected: 348.40 | Target: 349.23 | Delta:    0.82 | Target Position:   0 | STOP | Step Speed:   168 | Current Position: 57
  46 (  14ms) | Detected: 348.28 | Target: 349.23 | Delta:    0.95 | Target Position:   0 | STOP | Step Speed:     0 | Current Position: 59
  47 (  14ms) | Detected: 348.21 | Target: 349.23 | Delta:    1.02 | Target Position:   4 |   UP | Step Speed:    66 | Current Position: 59
  48 (  14ms) | Detected: 348.59 | Target: 349.23 | Delta:    0.63 | Target Position:   0 | STOP | Step Speed:   168 | Current Position: 61
  49 (  14ms) | Detected: 348.43 | Target: 349.23 | Delta:    0.80 | Target Position:   0 | STOP | Step Speed:     0 | Current Position: 63
  50 (  14ms) | Detected: 349.26 | Target: 349.23 | Delta:   -0.03 | Target Position:   0 | STOP | Step Speed:     0 | Current Position: 63
  51 (  14ms) | Detected: 349.96 | Target: 349.23 | Delta:   -0.73 | Target Position:   0 | STOP | Step Speed:     0 | Current Position: 63
  52 (  14ms) | Detected: 349.61 | Target: 349.23 | Delta:   -0.39 | Target Position:   0 | STOP | Step Speed:     0 | Current Position: 63
  53 (  14ms) | Detected: 349.74 | Target: 349.23 | Delta:   -0.51 | Target Position:   0 | STOP | Step Speed:     0 | Current Position: 63
  54 (  14ms) | Detected: 349.60 | Target: 349.23 | Delta:   -0.37 | Target Position:   0 | STOP | Step Speed:     0 | Current Position: 63
  55 (  14ms) | Detected: 349.74 | Target: 349.23 | Delta:   -0.51 | Target Position:   0 | STOP | Step Speed:     0 | Current Position: 63
  56 (  14ms) | Detected: 350.08 | Target: 349.23 | Delta:   -0.85 | Target Position:   0 | STOP | Step Speed:     0 | Current Position: 63
  57 (  14ms) | Detected: 349.66 | Target: 349.23 | Delta:   -0.43 | Target Position:   0 | STOP | Step Speed:     0 | Current Position: 63
  58 (  14ms) | Detected: 349.59 | Target: 349.23 | Delta:   -0.37 | Target Position:   0 | STOP | Step Speed:     0 | Current Position: 63
  59 (  14ms) | Detected: 350.03 | Target: 349.23 | Delta:   -0.80 | Target Position:   0 | STOP | Step Speed:     0 | Current Position: 63
  60 (  14ms) | Detected: 349.50 | Target: 349.23 | Delta:   -0.28 | Target Position:   0 | STOP | Step Speed:     0 | Current Position: 63
  61 (  15ms) | Detected: 349.85 | Target: 349.23 | Delta:   -0.62 | Target Position:   0 | STOP | Step Speed:     0 | Current Position: 63
  62 (  14ms) | Detected: 349.90 | Target: 349.23 | Delta:   -0.67 | Target Position:   0 | STOP | Step Speed:     0 | Current Position: 63
  63 (  15ms) | Detected: 349.67 | Target: 349.23 | Delta:   -0.44 | Target Position:   0 | STOP | Step Speed:     0 | Current Position: 63
  64 (  14ms) | Detected: 349.54 | Target: 349.23 | Delta:   -0.31 | Target Position:   0 | STOP | Step Speed:     0 | Current Position: 63
  65 (  15ms) | Detected: 349.91 | Target: 349.23 | Delta:   -0.68 | Target Position:   0 | STOP | Step Speed:     0 | Current Position: 63
  66 (  14ms) | Detected: 349.59 | Target: 349.23 | Delta:   -0.36 | Target Position:   0 | STOP | Step Speed:     0 | Current Position: 63
  67 (  15ms) | Detected: 349.71 | Target: 349.23 | Delta:   -0.49 | Target Position:   0 | STOP | Step Speed:     0 | Current Position: 63
  68 (  14ms) | Detected: 349.45 | Target: 349.23 | Delta:   -0.23 | Target Position:   0 | STOP | Step Speed:     0 | Current Position: 63
  69 (  15ms) | Detected: 349.59 | Target: 349.23 | Delta:   -0.36 | Target Position:   0 | STOP | Step Speed:     0 | Current Position: 63
  70 (  14ms) | Detected: 350.20 | Target: 349.23 | Delta:   -0.97 | Target Position:   0 | STOP | Step Speed:     0 | Current Position: 63
  71 (  15ms) | Detected: 349.56 | Target: 349.23 | Delta:   -0.33 | Target Position:   0 | STOP | Step Speed:     0 | Current Position: 63
  72 (  14ms) | Detected: 349.56 | Target: 349.23 | Delta:   -0.34 | Target Position:   0 | STOP | Step Speed:     0 | Current Position: 63
  73 (  15ms) | Detected: 349.85 | Target: 349.23 | Delta:   -0.62 | Target Position:   0 | STOP | Step Speed:     0 | Current Position: 63
  74 (  14ms) | Detected: 349.57 | Target: 349.23 | Delta:   -0.34 | Target Position:   0 | STOP | Step Speed:     0 | Current Position: 63
  75 (  15ms) | Detected: 349.76 | Target: 349.23 | Delta:   -0.53 | Target Position:   0 | STOP | Step Speed:     0 | Current Position: 63
  76 (  14ms) | Detected: 350.07 | Target: 349.23 | Delta:   -0.84 | Target Position:   0 | STOP | Step Speed:     0 | Current Position: 63
  77 (  15ms) | Detected: 349.59 | Target: 349.23 | Delta:   -0.36 | Target Position:   0 | STOP | Step Speed:     0 | Current Position: 63
  78 (  14ms) | Detected: 349.79 | Target: 349.23 | Delta:   -0.56 | Target Position:   0 | STOP | Step Speed:     0 | Current Position: 63
  79 (  15ms) | Detected: 349.76 | Target: 349.23 | Delta:   -0.53 | Target Position:   0 | STOP | Step Speed:     0 | Current Position: 63
  80 (  14ms) | Detected: 349.72 | Target: 349.23 | Delta:   -0.49 | Target Position:   0 | STOP | Step Speed:     0 | Current Position: 63
  81 (  15ms) | Detected: 349.96 | Target: 349.23 | Delta:   -0.73 | Target Position:   0 | STOP | Step Speed:     0 | Current Position: 63
  82 (  14ms) | Detected: 349.74 | Target: 349.23 | Delta:   -0.51 | Target Position:   0 | STOP | Step Speed:     0 | Current Position: 63
  83 (  14ms) | Detected: 349.86 | Target: 349.23 | Delta:   -0.63 | Target Position:   0 | STOP | Step Speed:     0 | Current Position: 63
  84 (  14ms) | Detected: 349.88 | Target: 349.23 | Delta:   -0.65 | Target Position:   0 | STOP | Step Speed:     0 | Current Position: 63
  85 (  14ms) | Detected: 349.89 | Target: 349.23 | Delta:   -0.66 | Target Position:   0 | STOP | Step Speed:     0 | Current Position: 63
  86 (  14ms) | Detected: 350.11 | Target: 349.23 | Delta:   -0.89 | Target Position:   0 | STOP | Step Speed:     0 | Current Position: 63
  87 (  14ms) | Detected: 349.70 | Target: 349.23 | Delta:   -0.47 | Target Position:   0 | STOP | Step Speed:     0 | Current Position: 63
  88 (  14ms) | Detected: 349.85 | Target: 349.23 | Delta:   -0.62 | Target Position:   0 | STOP | Step Speed:     0 | Current Position: 63
  89 (  14ms) | Detected: 350.06 | Target: 349.23 | Delta:   -0.83 | Target Position:   0 | STOP | Step Speed:     0 | Current Position: 63
  90 (  14ms) | Detected: 349.90 | Target: 349.23 | Delta:   -0.67 | Target Position:   0 | STOP | Step Speed:     0 | Current Position: 63
  91 (  14ms) | Detected: 349.77 | Target: 349.23 | Delta:   -0.54 | Target Position:   0 | STOP | Step Speed:     0 | Current Position: 63
  92 (  14ms) | Detected: 349.83 | Target: 349.23 | Delta:   -0.60 | Target Position:   0 | STOP | Step Speed:     0 | Current Position: 63
  93 (  14ms) | Detected: 349.82 | Target: 349.23 | Delta:   -0.60 | Target Position:   0 | STOP | Step Speed:     0 | Current Position: 63
  94 (  14ms) | Detected: 350.09 | Target: 349.23 | Delta:   -0.86 | Target Position:   0 | STOP | Step Speed:     0 | Current Position: 63
  95 (  14ms) | Detected: 350.22 | Target: 349.23 | Delta:   -0.99 | Target Position:   0 | STOP | Step Speed:     0 | Current Position: 63
  96 (  14ms) | Detected: 349.83 | Target: 349.23 | Delta:   -0.60 | Target Position:   0 | STOP | Step Speed:     0 | Current Position: 63
  97 (  14ms) | Detected: 350.00 | Target: 349.23 | Delta:   -0.77 | Target Position:   0 | STOP | Step Speed:     0 | Current Position: 63
  98 (  14ms) | Detected: 349.75 | Target: 349.23 | Delta:   -0.52 | Target Position:   0 | STOP | Step Speed:     0 | Current Position: 63
  99 (  14ms) | Detected: 349.94 | Target: 349.23 | Delta:   -0.71 | Target Position:   0 | STOP | Step Speed:     0 | Current Position: 63
 100 (  14ms) | Detected: 350.07 | Target: 349.23 | Delta:   -0.84 | Target Position:   0 | STOP | Step Speed:     0 | Current Position: 63
 101 (  14ms) | Detected: 349.96 | Target: 349.23 | Delta:   -0.73 | Target Position:   0 | STOP | Step Speed:     0 | Current Position: 63
 102 (  14ms) | Detected: 350.00 | Target: 349.23 | Delta:   -0.78 | Target Position:   0 | STOP | Step Speed:     0 | Current Position: 63
New note: 66
StepTune: Target position: 63 (noteID: 66 | freq: 369.99)
   0 ( 287ms) | Detected: 370.79 | Target: 369.99 | Delta:   -0.79 | Target Position:   0 | STOP | Step Speed:     0 | Current Position: 63
   1 (  14ms) | Detected: 370.19 | Target: 369.99 | Delta:   -0.20 | Target Position:   0 | STOP | Step Speed:     0 | Current Position: 63
   2 (  14ms) | Detected: 370.67 | Target: 369.99 | Delta:   -0.68 | Target Position:   0 | STOP | Step Speed:     0 | Current Position: 63
   3 (  14ms) | Detected: 370.26 | Target: 369.99 | Delta:   -0.26 | Target Position:   0 | STOP | Step Speed:     0 | Current Position: 63
   4 (  14ms) | Detected: 369.84 | Target: 369.99 | Delta:    0.15 | Target Position:   0 | STOP | Step Speed:     0 | Current Position: 63
   5 (  14ms) | Detected: 370.02 | Target: 369.99 | Delta:   -0.02 | Target Position:   0 | STOP | Step Speed:     0 | Current Position: 63
   6 (  14ms) | Detected: 369.76 | Target: 369.99 | Delta:    0.24 | Target Position:   0 | STOP | Step Speed:     0 | Current Position: 63
   7 (  14ms) | Detected: 369.88 | Target: 369.99 | Delta:    0.12 | Target Position:   0 | STOP | Step Speed:     0 | Current Position: 63
   8 (  14ms) | Detected: 369.78 | Target: 369.99 | Delta:    0.21 | Target Position:   0 | STOP | Step Speed:     0 | Current Position: 63
   9 (  14ms) | Detected: 369.93 | Target: 369.99 | Delta:    0.06 | Target Position:   0 | STOP | Step Speed:     0 | Current Position: 63
  10 (  14ms) | Detected: 369.57 | Target: 369.99 | Delta:    0.42 | Target Position:   0 | STOP | Step Speed:     0 | Current Position: 63
  11 (  28ms) | Detected: 369.46 | Target: 369.99 | Delta:    0.54 | Target Position:   0 | STOP | Step Speed:     0 | Current Position: 63
  12 (  28ms) | Detected: 369.25 | Target: 369.99 | Delta:    0.74 | Target Position:   0 | STOP | Step Speed:     0 | Current Position: 63
  13 (  14ms) | Detected: 369.63 | Target: 369.99 | Delta:    0.36 | Target Position:   0 | STOP | Step Speed:     0 | Current Position: 63
  14 (  58ms) | Detected: 369.68 | Target: 369.99 | Delta:    0.31 | Target Position:   0 | STOP | Step Speed:     0 | Current Position: 63
  15 (  58ms) | Detected: 369.62 | Target: 369.99 | Delta:    0.37 | Target Position:   0 | STOP | Step Speed:     0 | Current Position: 63
  16 (  44ms) | Detected: 369.21 | Target: 369.99 | Delta:    0.79 | Target Position:   0 | STOP | Step Speed:     0 | Current Position: 63
   0 ( 217ms) | Detected: 368.21 | Target: 369.99 | Delta:    1.79 | Target Position:   8 |   UP | Step Speed:    66 | Current Position: 63
   1 (  43ms) | Detected: 369.34 | Target: 369.99 | Delta:    0.66 | Target Position:   0 | STOP | Step Speed:     0 | Current Position: 70
   2 (  14ms) | Detected: 369.88 | Target: 369.99 | Delta:    0.12 | Target Position:   0 | STOP | Step Speed:     0 | Current Position: 70
   3 (  14ms) | Detected: 370.67 | Target: 369.99 | Delta:   -0.68 | Target Position:   0 | STOP | Step Speed:     0 | Current Position: 70
   4 (  14ms) | Detected: 370.59 | Target: 369.99 | Delta:   -0.60 | Target Position:   0 | STOP | Step Speed:     0 | Current Position: 70
   5 (  14ms) | Detected: 370.60 | Target: 369.99 | Delta:   -0.61 | Target Position:   0 | STOP | Step Speed:     0 | Current Position: 70
   6 (  14ms) | Detected: 370.65 | Target: 369.99 | Delta:   -0.65 | Target Position:   0 | STOP | Step Speed:     0 | Current Position: 70
   7 (  14ms) | Detected: 370.66 | Target: 369.99 | Delta:   -0.66 | Target Position:   0 | STOP | Step Speed:     0 | Current Position: 70
   8 (  14ms) | Detected: 370.95 | Target: 369.99 | Delta:   -0.96 | Target Position:   0 | STOP | Step Speed:     0 | Current Position: 70
   9 (  14ms) | Detected: 370.98 | Target: 369.99 | Delta:   -0.98 | Target Position:   0 | STOP | Step Speed:     0 | Current Position: 70
  10 (  14ms) | Detected: 370.45 | Target: 369.99 | Delta:   -0.45 | Target Position:   0 | STOP | Step Speed:     0 | Current Position: 70
  11 (  14ms) | Detected: 370.81 | Target: 369.99 | Delta:   -0.81 | Target Position:   0 | STOP | Step Speed:     0 | Current Position: 70
  12 (  14ms) | Detected: 370.76 | Target: 369.99 | Delta:   -0.77 | Target Position:   0 | STOP | Step Speed:     0 | Current Position: 70
  13 (  14ms) | Detected: 370.80 | Target: 369.99 | Delta:   -0.81 | Target Position:   0 | STOP | Step Speed:     0 | Current Position: 70
  14 (  14ms) | Detected: 370.53 | Target: 369.99 | Delta:   -0.54 | Target Position:   0 | STOP | Step Speed:     0 | Current Position: 70
  15 (  14ms) | Detected: 370.81 | Target: 369.99 | Delta:   -0.82 | Target Position:   0 | STOP | Step Speed:     0 | Current Position: 70
  16 (  14ms) | Detected: 371.01 | Target: 369.99 | Delta:   -1.01 | Target Position:  -4 | DOWN | Step Speed:   -66 | Current Position: 70
  17 (  14ms) | Detected: 370.81 | Target: 369.99 | Delta:   -0.82 | Target Position:   0 | STOP | Step Speed:  -168 | Current Position: 68
  18 (  14ms) | Detected: 370.71 | Target: 369.99 | Delta:   -0.71 | Target Position:   0 | STOP | Step Speed:     0 | Current Position: 66
  19 (  14ms) | Detected: 371.28 | Target: 369.99 | Delta:   -1.29 | Target Position:  -5 | DOWN | Step Speed:   -66 | Current Position: 66
  20 (  14ms) | Detected: 370.91 | Target: 369.99 | Delta:   -0.91 | Target Position:   0 | STOP | Step Speed:  -168 | Current Position: 64
  21 (  14ms) | Detected: 370.69 | Target: 369.99 | Delta:   -0.70 | Target Position:   0 | STOP | Step Speed:     0 | Current Position: 62
  22 (  14ms) | Detected: 370.24 | Target: 369.99 | Delta:   -0.24 | Target Position:   0 | STOP | Step Speed:     0 | Current Position: 62
  23 (  14ms) | Detected: 370.38 | Target: 369.99 | Delta:   -0.38 | Target Position:   0 | STOP | Step Speed:     0 | Current Position: 62
  24 (  14ms) | Detected: 369.98 | Target: 369.99 | Delta:    0.02 | Target Position:   0 | STOP | Step Speed:     0 | Current Position: 62
  25 (  14ms) | Detected: 370.37 | Target: 369.99 | Delta:   -0.38 | Target Position:   0 | STOP | Step Speed:     0 | Current Position: 62
  26 (  14ms) | Detected: 370.16 | Target: 369.99 | Delta:   -0.17 | Target Position:   0 | STOP | Step Speed:     0 | Current Position: 62
  27 (  14ms) | Detected: 370.45 | Target: 369.99 | Delta:   -0.46 | Target Position:   0 | STOP | Step Speed:     0 | Current Position: 62
  28 (  14ms) | Detected: 370.37 | Target: 369.99 | Delta:   -0.38 | Target Position:   0 | STOP | Step Speed:     0 | Current Position: 62
  29 (  14ms) | Detected: 370.43 | Target: 369.99 | Delta:   -0.43 | Target Position:   0 | STOP | Step Speed:     0 | Current Position: 62
  30 (  14ms) | Detected: 370.40 | Target: 369.99 | Delta:   -0.40 | Target Position:   0 | STOP | Step Speed:     0 | Current Position: 62
  31 (  14ms) | Detected: 370.12 | Target: 369.99 | Delta:   -0.13 | Target Position:   0 | STOP | Step Speed:     0 | Current Position: 62
  32 (  14ms) | Detected: 370.11 | Target: 369.99 | Delta:   -0.11 | Target Position:   0 | STOP | Step Speed:     0 | Current Position: 62
  33 (  14ms) | Detected: 369.98 | Target: 369.99 | Delta:    0.02 | Target Position:   0 | STOP | Step Speed:     0 | Current Position: 62
  34 (  14ms) | Detected: 370.04 | Target: 369.99 | Delta:   -0.05 | Target Position:   0 | STOP | Step Speed:     0 | Current Position: 62
  35 (  14ms) | Detected: 370.04 | Target: 369.99 | Delta:   -0.05 | Target Position:   0 | STOP | Step Speed:     0 | Current Position: 62
  36 (  14ms) | Detected: 370.16 | Target: 369.99 | Delta:   -0.16 | Target Position:   0 | STOP | Step Speed:     0 | Current Position: 62
  37 (  14ms) | Detected: 370.13 | Target: 369.99 | Delta:   -0.14 | Target Position:   0 | STOP | Step Speed:     0 | Current Position: 62
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
  68 (  15ms) | Detected: 370.25 | Target: 369.99 | Delta:   -0.26 | Target Position:   0 | STOP | Step Speed:     0 | Current Position: 62
  69 (  14ms) | Detected: 370.04 | Target: 369.99 | Delta:   -0.05 | Target Position:   0 | STOP | Step Speed:     0 | Current Position: 62
  70 (  15ms) | Detected: 370.54 | Target: 369.99 | Delta:   -0.54 | Target Position:   0 | STOP | Step Speed:     0 | Current Position: 62
  71 (  14ms) | Detected: 370.15 | Target: 369.99 | Delta:   -0.15 | Target Position:   0 | STOP | Step Speed:     0 | Current Position: 62
  72 (  14ms) | Detected: 369.97 | Target: 369.99 | Delta:    0.02 | Target Position:   0 | STOP | Step Speed:     0 | Current Position: 62
  73 (  14ms) | Detected: 370.45 | Target: 369.99 | Delta:   -0.46 | Target Position:   0 | STOP | Step Speed:     0 | Current Position: 62
  74 (  14ms) | Detected: 369.79 | Target: 369.99 | Delta:    0.21 | Target Position:   0 | STOP | Step Speed:     0 | Current Position: 62
  75 (  14ms) | Detected: 370.39 | Target: 369.99 | Delta:   -0.40 | Target Position:   0 | STOP | Step Speed:     0 | Current Position: 62
New note: 67
StepTune: Target position: 81 (noteID: 67 | freq: 392.00)
   0 ( 304ms) | Detected: 390.13 | Target: 392.00 | Delta:    1.87 | Target Position:   8 |   UP | Step Speed:    66 | Current Position: 81
   1 (  14ms) | Detected: 390.25 | Target: 392.00 | Delta:    1.74 | Target Position:   7 |   UP | Step Speed:   168 | Current Position: 83
   2 (  14ms) | Detected: 389.96 | Target: 392.00 | Delta:    2.04 | Target Position:   9 |   UP | Step Speed:   215 | Current Position: 86
   3 (  14ms) | Detected: 389.12 | Target: 392.00 | Delta:    2.88 | Target Position:  13 |   UP | Step Speed:   225 | Current Position: 89
   4 (  14ms) | Detected: 390.72 | Target: 392.00 | Delta:    1.27 | Target Position:   5 |   UP | Step Speed:   249 | Current Position: 93
   5 (  29ms) | Detected: 393.60 | Target: 392.00 | Delta:   -1.61 | Target Position:  -7 | DOWN | Step Speed:    67 | Current Position: 99
   6 (  14ms) | Detected: 393.82 | Target: 392.00 | Delta:   -1.82 | Target Position:  -8 | DOWN | Step Speed:   -66 | Current Position: 99
   7 (  14ms) | Detected: 395.44 | Target: 392.00 | Delta:   -3.45 | Target Position: -15 | DOWN | Step Speed:  -168 | Current Position: 97
   8 (  14ms) | Detected: 394.94 | Target: 392.00 | Delta:   -2.94 | Target Position: -13 | DOWN | Step Speed:  -245 | Current Position: 94
   9 (  14ms) | Detected: 393.90 | Target: 392.00 | Delta:   -1.91 | Target Position:  -8 | DOWN | Step Speed:  -261 | Current Position: 90
  10 (  14ms) | Detected: 394.11 | Target: 392.00 | Delta:   -2.12 | Target Position:  -9 | DOWN | Step Speed:  -232 | Current Position: 87
  11 (  14ms) | Detected: 394.04 | Target: 392.00 | Delta:   -2.04 | Target Position:  -9 | DOWN | Step Speed:  -221 | Current Position: 83
  12 (  14ms) | Detected: 393.31 | Target: 392.00 | Delta:   -1.31 | Target Position:  -5 | DOWN | Step Speed:  -190 | Current Position: 80
  13 (  14ms) | Detected: 391.44 | Target: 392.00 | Delta:    0.55 | Target Position:   0 | STOP | Step Speed:  -110 | Current Position: 78
  14 (  14ms) | Detected: 390.46 | Target: 392.00 | Delta:    1.53 | Target Position:   6 |   UP | Step Speed:    66 | Current Position: 77
  15 (  14ms) | Detected: 389.72 | Target: 392.00 | Delta:    2.28 | Target Position:  10 |   UP | Step Speed:   168 | Current Position: 79
  16 (  14ms) | Detected: 390.52 | Target: 392.00 | Delta:    1.48 | Target Position:   6 |   UP | Step Speed:   228 | Current Position: 81
  17 (  14ms) | Detected: 390.05 | Target: 392.00 | Delta:    1.95 | Target Position:   8 |   UP | Step Speed:   198 | Current Position: 84
  18 (  14ms) | Detected: 390.72 | Target: 392.00 | Delta:    1.27 | Target Position:   5 |   UP | Step Speed:   187 | Current Position: 87
  19 (  14ms) | Detected: 390.81 | Target: 392.00 | Delta:    1.19 | Target Position:   5 |   UP | Step Speed:   179 | Current Position: 89
  20 (  14ms) | Detected: 391.89 | Target: 392.00 | Delta:    0.10 | Target Position:   0 | STOP | Step Speed:   104 | Current Position: 91
  21 (  28ms) | Detected: 393.36 | Target: 392.00 | Delta:   -1.36 | Target Position:  -6 | DOWN | Step Speed:  -110 | Current Position: 93
  22 (  14ms) | Detected: 392.86 | Target: 392.00 | Delta:   -0.87 | Target Position:   0 | STOP | Step Speed:  -110 | Current Position: 90
  23 (  14ms) | Detected: 392.29 | Target: 392.00 | Delta:   -0.29 | Target Position:   0 | STOP | Step Speed:     0 | Current Position: 89
  24 (  28ms) | Detected: 392.17 | Target: 392.00 | Delta:   -0.18 | Target Position:   0 | STOP | Step Speed:     0 | Current Position: 89
  25 (  14ms) | Detected: 395.04 | Target: 392.00 | Delta:   -3.04 | Target Position: -13 | DOWN | Step Speed:   -66 | Current Position: 89
  26 (  14ms) | Detected: 391.31 | Target: 392.00 | Delta:    0.68 | Target Position:   0 | STOP | Step Speed:  -168 | Current Position: 87
  27 (  14ms) | Detected: 392.57 | Target: 392.00 | Delta:   -0.57 | Target Position:   0 | STOP | Step Speed:     0 | Current Position: 85
  28 (  43ms) | Detected: 391.49 | Target: 392.00 | Delta:    0.50 | Target Position:   0 | STOP | Step Speed:     0 | Current Position: 85
  29 (  14ms) | Detected: 391.60 | Target: 392.00 | Delta:    0.40 | Target Position:   0 | STOP | Step Speed:     0 | Current Position: 85
  30 (  14ms) | Detected: 391.61 | Target: 392.00 | Delta:    0.39 | Target Position:   0 | STOP | Step Speed:     0 | Current Position: 85
  31 (  14ms) | Detected: 391.78 | Target: 392.00 | Delta:    0.21 | Target Position:   0 | STOP | Step Speed:     0 | Current Position: 85
  32 (  29ms) | Detected: 391.34 | Target: 392.00 | Delta:    0.65 | Target Position:   0 | STOP | Step Speed:     0 | Current Position: 85
  33 (  14ms) | Detected: 390.50 | Target: 392.00 | Delta:    1.50 | Target Position:   6 |   UP | Step Speed:    66 | Current Position: 85
  34 (  14ms) | Detected: 390.66 | Target: 392.00 | Delta:    1.33 | Target Position:   6 |   UP | Step Speed:   168 | Current Position: 87
  35 (  14ms) | Detected: 390.92 | Target: 392.00 | Delta:    1.08 | Target Position:   4 |   UP | Step Speed:   182 | Current Position: 90
  36 (  14ms) | Detected: 391.89 | Target: 392.00 | Delta:    0.10 | Target Position:   0 | STOP | Step Speed:   106 | Current Position: 92
  37 (  14ms) | Detected: 392.44 | Target: 392.00 | Delta:   -0.45 | Target Position:   0 | STOP | Step Speed:     0 | Current Position: 93
  38 (  14ms) | Detected: 392.08 | Target: 392.00 | Delta:   -0.09 | Target Position:   0 | STOP | Step Speed:     0 | Current Position: 93
  39 (  14ms) | Detected: 393.03 | Target: 392.00 | Delta:   -1.04 | Target Position:  -4 | DOWN | Step Speed:   -66 | Current Position: 93
  40 (  14ms) | Detected: 392.13 | Target: 392.00 | Delta:   -0.14 | Target Position:   0 | STOP | Step Speed:  -168 | Current Position: 91
  41 (  15ms) | Detected: 393.74 | Target: 392.00 | Delta:   -1.75 | Target Position:  -7 | DOWN | Step Speed:  -184 | Current Position: 89
  42 (  14ms) | Detected: 391.66 | Target: 392.00 | Delta:    0.33 | Target Position:   0 | STOP | Step Speed:  -174 | Current Position: 86
  43 (  15ms) | Detected: 391.99 | Target: 392.00 | Delta:    0.00 | Target Position:   0 | STOP | Step Speed:     0 | Current Position: 84
  44 (  14ms) | Detected: 391.20 | Target: 392.00 | Delta:    0.79 | Target Position:   0 | STOP | Step Speed:     0 | Current Position: 84
  45 (  15ms) | Detected: 391.01 | Target: 392.00 | Delta:    0.99 | Target Position:   0 | STOP | Step Speed:     0 | Current Position: 84
  46 (  14ms) | Detected: 390.64 | Target: 392.00 | Delta:    1.35 | Target Position:   6 |   UP | Step Speed:    66 | Current Position: 84
  47 (  15ms) | Detected: 390.98 | Target: 392.00 | Delta:    1.02 | Target Position:   4 |   UP | Step Speed:   142 | Current Position: 86
  48 (  14ms) | Detected: 390.93 | Target: 392.00 | Delta:    1.07 | Target Position:   4 |   UP | Step Speed:   182 | Current Position: 88
  49 (  15ms) | Detected: 391.03 | Target: 392.00 | Delta:    0.96 | Target Position:   0 | STOP | Step Speed:     0 | Current Position: 91
  50 (  14ms) | Detected: 391.38 | Target: 392.00 | Delta:    0.61 | Target Position:   0 | STOP | Step Speed:     0 | Current Position: 91
  51 (  15ms) | Detected: 392.06 | Target: 392.00 | Delta:   -0.07 | Target Position:   0 | STOP | Step Speed:     0 | Current Position: 91
  52 (  14ms) | Detected: 392.22 | Target: 392.00 | Delta:   -0.23 | Target Position:   0 | STOP | Step Speed:     0 | Current Position: 91
  53 (  15ms) | Detected: 391.52 | Target: 392.00 | Delta:    0.48 | Target Position:   0 | STOP | Step Speed:     0 | Current Position: 91
  54 (  14ms) | Detected: 392.03 | Target: 392.00 | Delta:   -0.03 | Target Position:   0 | STOP | Step Speed:     0 | Current Position: 91
  55 (  15ms) | Detected: 392.40 | Target: 392.00 | Delta:   -0.40 | Target Position:   0 | STOP | Step Speed:     0 | Current Position: 91
  56 (  14ms) | Detected: 391.63 | Target: 392.00 | Delta:    0.36 | Target Position:   0 | STOP | Step Speed:     0 | Current Position: 91
  57 (  15ms) | Detected: 391.81 | Target: 392.00 | Delta:    0.19 | Target Position:   0 | STOP | Step Speed:     0 | Current Position: 91
  58 (  14ms) | Detected: 392.01 | Target: 392.00 | Delta:   -0.01 | Target Position:   0 | STOP | Step Speed:     0 | Current Position: 91
  59 (  15ms) | Detected: 391.76 | Target: 392.00 | Delta:    0.24 | Target Position:   0 | STOP | Step Speed:     0 | Current Position: 91
  60 (  14ms) | Detected: 391.77 | Target: 392.00 | Delta:    0.23 | Target Position:   0 | STOP | Step Speed:     0 | Current Position: 91
  61 (  14ms) | Detected: 391.44 | Target: 392.00 | Delta:    0.56 | Target Position:   0 | STOP | Step Speed:     0 | Current Position: 91
  62 (  14ms) | Detected: 392.13 | Target: 392.00 | Delta:   -0.13 | Target Position:   0 | STOP | Step Speed:     0 | Current Position: 91
  63 (  14ms) | Detected: 392.09 | Target: 392.00 | Delta:   -0.09 | Target Position:   0 | STOP | Step Speed:     0 | Current Position: 91
  64 (  14ms) | Detected: 391.99 | Target: 392.00 | Delta:    0.00 | Target Position:   0 | STOP | Step Speed:     0 | Current Position: 91
  65 (  14ms) | Detected: 391.77 | Target: 392.00 | Delta:    0.23 | Target Position:   0 | STOP | Step Speed:     0 | Current Position: 91
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
  96 (  14ms) | Detected: 392.33 | Target: 392.00 | Delta:   -0.33 | Target Position:   0 | STOP | Step Speed:     0 | Current Position: 91
  97 (  14ms) | Detected: 392.32 | Target: 392.00 | Delta:   -0.32 | Target Position:   0 | STOP | Step Speed:     0 | Current Position: 91
  98 (  14ms) | Detected: 392.08 | Target: 392.00 | Delta:   -0.09 | Target Position:   0 | STOP | Step Speed:     0 | Current Position: 91
  99 (  14ms) | Detected: 392.16 | Target: 392.00 | Delta:   -0.17 | Target Position:   0 | STOP | Step Speed:     0 | Current Position: 91
 100 (  14ms) | Detected: 392.75 | Target: 392.00 | Delta:   -0.76 | Target Position:   0 | STOP | Step Speed:     0 | Current Position: 91
 101 (  14ms) | Detected: 392.08 | Target: 392.00 | Delta:   -0.08 | Target Position:   0 | STOP | Step Speed:     0 | Current Position: 91
 102 (  14ms) | Detected: 392.13 | Target: 392.00 | Delta:   -0.14 | Target Position:   0 | STOP | Step Speed:     0 | Current Position: 91
 103 (  14ms) | Detected: 392.73 | Target: 392.00 | Delta:   -0.73 | Target Position:   0 | STOP | Step Speed:     0 | Current Position: 91
 104 (  14ms) | Detected: 392.30 | Target: 392.00 | Delta:   -0.30 | Target Position:   0 | STOP | Step Speed:     0 | Current Position: 91
 105 (  14ms) | Detected: 392.33 | Target: 392.00 | Delta:   -0.33 | Target Position:   0 | STOP | Step Speed:     0 | Current Position: 91
 106 (  14ms) | Detected: 392.36 | Target: 392.00 | Delta:   -0.37 | Target Position:   0 | STOP | Step Speed:     0 | Current Position: 91
 107 (  14ms) | Detected: 392.41 | Target: 392.00 | Delta:   -0.41 | Target Position:   0 | STOP | Step Speed:     0 | Current Position: 91
 108 (  14ms) | Detected: 392.14 | Target: 392.00 | Delta:   -0.15 | Target Position:   0 | STOP | Step Speed:     0 | Current Position: 91
 109 (  14ms) | Detected: 392.23 | Target: 392.00 | Delta:   -0.24 | Target Position:   0 | STOP | Step Speed:     0 | Current Position: 91
 110 (  14ms) | Detected: 392.40 | Target: 392.00 | Delta:   -0.40 | Target Position:   0 | STOP | Step Speed:     0 | Current Position: 91
 111 (  14ms) | Detected: 392.19 | Target: 392.00 | Delta:   -0.19 | Target Position:   0 | STOP | Step Speed:     0 | Current Position: 91
New note: 68
StepTune: Target position: 108 (noteID: 68 | freq: 415.30)
   0 ( 363ms) | Detected: 415.18 | Target: 415.30 | Delta:    0.12 | Target Position:   0 | STOP | Step Speed:     0 | Current Position: 108
   1 (  29ms) | Detected: 414.51 | Target: 415.30 | Delta:    0.80 | Target Position:   0 | STOP | Step Speed:     0 | Current Position: 108
   2 (  14ms) | Detected: 414.77 | Target: 415.30 | Delta:    0.54 | Target Position:   0 | STOP | Step Speed:     0 | Current Position: 108
   3 (  29ms) | Detected: 415.32 | Target: 415.30 | Delta:   -0.02 | Target Position:   0 | STOP | Step Speed:     0 | Current Position: 108
   4 (  15ms) | Detected: 415.36 | Target: 415.30 | Delta:   -0.06 | Target Position:   0 | STOP | Step Speed:     0 | Current Position: 108
   5 (  14ms) | Detected: 413.92 | Target: 415.30 | Delta:    1.38 | Target Position:   6 |   UP | Step Speed:    66 | Current Position: 108
   6 (  43ms) | Detected: 415.35 | Target: 415.30 | Delta:   -0.05 | Target Position:   0 | STOP | Step Speed:     0 | Current Position: 114
   7 (  14ms) | Detected: 415.78 | Target: 415.30 | Delta:   -0.47 | Target Position:   0 | STOP | Step Speed:     0 | Current Position: 114
   8 (  15ms) | Detected: 415.90 | Target: 415.30 | Delta:   -0.59 | Target Position:   0 | STOP | Step Speed:     0 | Current Position: 114
   9 (  14ms) | Detected: 416.22 | Target: 415.30 | Delta:   -0.91 | Target Position:   0 | STOP | Step Speed:     0 | Current Position: 114
  10 (  15ms) | Detected: 415.66 | Target: 415.30 | Delta:   -0.35 | Target Position:   0 | STOP | Step Speed:     0 | Current Position: 114
  11 (  14ms) | Detected: 415.26 | Target: 415.30 | Delta:    0.05 | Target Position:   0 | STOP | Step Speed:     0 | Current Position: 114
  12 (  15ms) | Detected: 415.34 | Target: 415.30 | Delta:   -0.04 | Target Position:   0 | STOP | Step Speed:     0 | Current Position: 114
  13 (  14ms) | Detected: 415.62 | Target: 415.30 | Delta:   -0.31 | Target Position:   0 | STOP | Step Speed:     0 | Current Position: 114
  14 (  14ms) | Detected: 416.42 | Target: 415.30 | Delta:   -1.11 | Target Position:  -5 | DOWN | Step Speed:   -66 | Current Position: 114
  15 (  14ms) | Detected: 414.58 | Target: 415.30 | Delta:    0.73 | Target Position:   0 | STOP | Step Speed:  -168 | Current Position: 112
  16 (  14ms) | Detected: 415.97 | Target: 415.30 | Delta:   -0.66 | Target Position:   0 | STOP | Step Speed:     0 | Current Position: 110
  17 (  14ms) | Detected: 416.33 | Target: 415.30 | Delta:   -1.02 | Target Position:  -4 | DOWN | Step Speed:   -66 | Current Position: 110
  18 (  14ms) | Detected: 414.79 | Target: 415.30 | Delta:    0.52 | Target Position:   0 | STOP | Step Speed:  -168 | Current Position: 108
  19 (  14ms) | Detected: 414.48 | Target: 415.30 | Delta:    0.82 | Target Position:   0 | STOP | Step Speed:     0 | Current Position: 106
  20 (  14ms) | Detected: 415.06 | Target: 415.30 | Delta:    0.25 | Target Position:   0 | STOP | Step Speed:     0 | Current Position: 106
  21 (  14ms) | Detected: 414.80 | Target: 415.30 | Delta:    0.50 | Target Position:   0 | STOP | Step Speed:     0 | Current Position: 106
  22 (  14ms) | Detected: 415.74 | Target: 415.30 | Delta:   -0.44 | Target Position:   0 | STOP | Step Speed:     0 | Current Position: 106
  23 (  14ms) | Detected: 415.17 | Target: 415.30 | Delta:    0.13 | Target Position:   0 | STOP | Step Speed:     0 | Current Position: 106
  24 (  14ms) | Detected: 415.11 | Target: 415.30 | Delta:    0.19 | Target Position:   0 | STOP | Step Speed:     0 | Current Position: 106
  25 (  14ms) | Detected: 414.62 | Target: 415.30 | Delta:    0.68 | Target Position:   0 | STOP | Step Speed:     0 | Current Position: 106
  26 (  14ms) | Detected: 414.80 | Target: 415.30 | Delta:    0.50 | Target Position:   0 | STOP | Step Speed:     0 | Current Position: 106
  27 (  14ms) | Detected: 414.61 | Target: 415.30 | Delta:    0.69 | Target Position:   0 | STOP | Step Speed:     0 | Current Position: 106
  28 (  14ms) | Detected: 415.23 | Target: 415.30 | Delta:    0.07 | Target Position:   0 | STOP | Step Speed:     0 | Current Position: 106
  29 (  14ms) | Detected: 414.35 | Target: 415.30 | Delta:    0.95 | Target Position:   0 | STOP | Step Speed:     0 | Current Position: 106
  30 (  14ms) | Detected: 414.56 | Target: 415.30 | Delta:    0.74 | Target Position:   0 | STOP | Step Speed:     0 | Current Position: 106
  31 (  14ms) | Detected: 414.60 | Target: 415.30 | Delta:    0.70 | Target Position:   0 | STOP | Step Speed:     0 | Current Position: 106
  32 (  14ms) | Detected: 414.85 | Target: 415.30 | Delta:    0.45 | Target Position:   0 | STOP | Step Speed:     0 | Current Position: 106
  33 (  14ms) | Detected: 414.97 | Target: 415.30 | Delta:    0.33 | Target Position:   0 | STOP | Step Speed:     0 | Current Position: 106
  34 (  14ms) | Detected: 414.32 | Target: 415.30 | Delta:    0.99 | Target Position:   0 | STOP | Step Speed:     0 | Current Position: 106
  35 (  14ms) | Detected: 414.78 | Target: 415.30 | Delta:    0.53 | Target Position:   0 | STOP | Step Speed:     0 | Current Position: 106
  36 (  14ms) | Detected: 414.62 | Target: 415.30 | Delta:    0.69 | Target Position:   0 | STOP | Step Speed:     0 | Current Position: 106
  37 (  14ms) | Detected: 414.93 | Target: 415.30 | Delta:    0.38 | Target Position:   0 | STOP | Step Speed:     0 | Current Position: 106
  38 (  14ms) | Detected: 414.41 | Target: 415.30 | Delta:    0.89 | Target Position:   0 | STOP | Step Speed:     0 | Current Position: 106
  39 (  14ms) | Detected: 415.00 | Target: 415.30 | Delta:    0.30 | Target Position:   0 | STOP | Step Speed:     0 | Current Position: 106
  40 (  14ms) | Detected: 414.55 | Target: 415.30 | Delta:    0.76 | Target Position:   0 | STOP | Step Speed:     0 | Current Position: 106
  41 (  14ms) | Detected: 414.25 | Target: 415.30 | Delta:    1.06 | Target Position:   4 |   UP | Step Speed:    66 | Current Position: 106
  42 (  14ms) | Detected: 414.50 | Target: 415.30 | Delta:    0.81 | Target Position:   0 | STOP | Step Speed:   168 | Current Position: 108
  43 (  14ms) | Detected: 414.66 | Target: 415.30 | Delta:    0.64 | Target Position:   0 | STOP | Step Speed:     0 | Current Position: 110
  44 (  14ms) | Detected: 414.83 | Target: 415.30 | Delta:    0.48 | Target Position:   0 | STOP | Step Speed:     0 | Current Position: 110
  45 (  14ms) | Detected: 415.06 | Target: 415.30 | Delta:    0.25 | Target Position:   0 | STOP | Step Speed:     0 | Current Position: 110
  46 (  14ms) | Detected: 415.34 | Target: 415.30 | Delta:   -0.03 | Target Position:   0 | STOP | Step Speed:     0 | Current Position: 110
  47 (  14ms) | Detected: 414.93 | Target: 415.30 | Delta:    0.38 | Target Position:   0 | STOP | Step Speed:     0 | Current Position: 110
  48 (  14ms) | Detected: 415.01 | Target: 415.30 | Delta:    0.29 | Target Position:   0 | STOP | Step Speed:     0 | Current Position: 110
  49 (  14ms) | Detected: 414.75 | Target: 415.30 | Delta:    0.56 | Target Position:   0 | STOP | Step Speed:     0 | Current Position: 110
  50 (  14ms) | Detected: 414.79 | Target: 415.30 | Delta:    0.51 | Target Position:   0 | STOP | Step Speed:     0 | Current Position: 110
  51 (  14ms) | Detected: 414.87 | Target: 415.30 | Delta:    0.43 | Target Position:   0 | STOP | Step Speed:     0 | Current Position: 110
  52 (  14ms) | Detected: 414.87 | Target: 415.30 | Delta:    0.43 | Target Position:   0 | STOP | Step Speed:     0 | Current Position: 110
  53 (  14ms) | Detected: 414.58 | Target: 415.30 | Delta:    0.72 | Target Position:   0 | STOP | Step Speed:     0 | Current Position: 110
  54 (  14ms) | Detected: 414.80 | Target: 415.30 | Delta:    0.51 | Target Position:   0 | STOP | Step Speed:     0 | Current Position: 110
  55 (  14ms) | Detected: 414.66 | Target: 415.30 | Delta:    0.65 | Target Position:   0 | STOP | Step Speed:     0 | Current Position: 110
  56 (  14ms) | Detected: 414.94 | Target: 415.30 | Delta:    0.37 | Target Position:   0 | STOP | Step Speed:     0 | Current Position: 110
  57 (  14ms) | Detected: 414.55 | Target: 415.30 | Delta:    0.75 | Target Position:   0 | STOP | Step Speed:     0 | Current Position: 110
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
  88 (  14ms) | Detected: 414.83 | Target: 415.30 | Delta:    0.48 | Target Position:   0 | STOP | Step Speed:     0 | Current Position: 110
  89 (  14ms) | Detected: 415.13 | Target: 415.30 | Delta:    0.18 | Target Position:   0 | STOP | Step Speed:     0 | Current Position: 110
  90 (  14ms) | Detected: 414.84 | Target: 415.30 | Delta:    0.46 | Target Position:   0 | STOP | Step Speed:     0 | Current Position: 110
  91 (  14ms) | Detected: 414.85 | Target: 415.30 | Delta:    0.46 | Target Position:   0 | STOP | Step Speed:     0 | Current Position: 110
  92 (  14ms) | Detected: 414.94 | Target: 415.30 | Delta:    0.37 | Target Position:   0 | STOP | Step Speed:     0 | Current Position: 110
  93 (  14ms) | Detected: 414.59 | Target: 415.30 | Delta:    0.72 | Target Position:   0 | STOP | Step Speed:     0 | Current Position: 110
  94 (  14ms) | Detected: 414.76 | Target: 415.30 | Delta:    0.54 | Target Position:   0 | STOP | Step Speed:     0 | Current Position: 110
  95 (  14ms) | Detected: 414.70 | Target: 415.30 | Delta:    0.61 | Target Position:   0 | STOP | Step Speed:     0 | Current Position: 110
  96 (  14ms) | Detected: 414.89 | Target: 415.30 | Delta:    0.42 | Target Position:   0 | STOP | Step Speed:     0 | Current Position: 110
  97 (  14ms) | Detected: 414.43 | Target: 415.30 | Delta:    0.87 | Target Position:   0 | STOP | Step Speed:     0 | Current Position: 110
  98 (  14ms) | Detected: 414.67 | Target: 415.30 | Delta:    0.64 | Target Position:   0 | STOP | Step Speed:     0 | Current Position: 110
  99 (  14ms) | Detected: 414.66 | Target: 415.30 | Delta:    0.65 | Target Position:   0 | STOP | Step Speed:     0 | Current Position: 110
 100 (  14ms) | Detected: 414.87 | Target: 415.30 | Delta:    0.43 | Target Position:   0 | STOP | Step Speed:     0 | Current Position: 110
 101 (  14ms) | Detected: 414.96 | Target: 415.30 | Delta:    0.34 | Target Position:   0 | STOP | Step Speed:     0 | Current Position: 110
 102 (  14ms) | Detected: 414.82 | Target: 415.30 | Delta:    0.49 | Target Position:   0 | STOP | Step Speed:     0 | Current Position: 110
 103 (  14ms) | Detected: 414.77 | Target: 415.30 | Delta:    0.54 | Target Position:   0 | STOP | Step Speed:     0 | Current Position: 110
 104 (  14ms) | Detected: 414.68 | Target: 415.30 | Delta:    0.63 | Target Position:   0 | STOP | Step Speed:     0 | Current Position: 110
 105 (  14ms) | Detected: 414.89 | Target: 415.30 | Delta:    0.41 | Target Position:   0 | STOP | Step Speed:     0 | Current Position: 110
 106 (  14ms) | Detected: 414.80 | Target: 415.30 | Delta:    0.50 | Target Position:   0 | STOP | Step Speed:     0 | Current Position: 110
 107 (  14ms) | Detected: 415.15 | Target: 415.30 | Delta:    0.15 | Target Position:   0 | STOP | Step Speed:     0 | Current Position: 110
 108 (  14ms) | Detected: 414.85 | Target: 415.30 | Delta:    0.45 | Target Position:   0 | STOP | Step Speed:     0 | Current Position: 110
New note: 69
StepTune: Target position: 139 (noteID: 69 | freq: 440.00)
   0 ( 391ms) | Detected: 438.35 | Target: 440.00 | Delta:    1.65 | Target Position:   7 |   UP | Step Speed:    66 | Current Position: 139
   1 (  14ms) | Detected: 438.28 | Target: 440.00 | Delta:    1.72 | Target Position:   7 |   UP | Step Speed:   168 | Current Position: 141
   2 (  14ms) | Detected: 438.70 | Target: 440.00 | Delta:    1.30 | Target Position:   5 |   UP | Step Speed:   215 | Current Position: 144
   3 (  43ms) | Detected: 439.10 | Target: 440.00 | Delta:    0.90 | Target Position:   0 | STOP | Step Speed:     0 | Current Position: 149
   4 (  43ms) | Detected: 439.89 | Target: 440.00 | Delta:    0.11 | Target Position:   0 | STOP | Step Speed:     0 | Current Position: 149
   5 (  72ms) | Detected: 439.13 | Target: 440.00 | Delta:    0.87 | Target Position:   0 | STOP | Step Speed:     0 | Current Position: 149
   6 (  43ms) | Detected: 438.71 | Target: 440.00 | Delta:    1.29 | Target Position:   5 |   UP | Step Speed:    66 | Current Position: 149
   7 (  29ms) | Detected: 439.08 | Target: 440.00 | Delta:    0.92 | Target Position:   0 | STOP | Step Speed:     0 | Current Position: 153
   8 (  58ms) | Detected: 439.10 | Target: 440.00 | Delta:    0.90 | Target Position:   0 | STOP | Step Speed:     0 | Current Position: 153
   9 (  14ms) | Detected: 439.56 | Target: 440.00 | Delta:    0.44 | Target Position:   0 | STOP | Step Speed:     0 | Current Position: 153
   0 ( 115ms) | Detected: 439.37 | Target: 440.00 | Delta:    0.63 | Target Position:   0 | STOP | Step Speed:     0 | Current Position: 153
   1 (  14ms) | Detected: 442.67 | Target: 440.00 | Delta:   -2.67 | Target Position: -12 | DOWN | Step Speed:   -66 | Current Position: 153
   2 (  58ms) | Detected: 439.57 | Target: 440.00 | Delta:    0.43 | Target Position:   0 | STOP | Step Speed:  -110 | Current Position: 143
   3 (  44ms) | Detected: 439.36 | Target: 440.00 | Delta:    0.64 | Target Position:   0 | STOP | Step Speed:     0 | Current Position: 143
   4 (  43ms) | Detected: 439.65 | Target: 440.00 | Delta:    0.35 | Target Position:   0 | STOP | Step Speed:     0 | Current Position: 143
   5 (  87ms) | Detected: 439.97 | Target: 440.00 | Delta:    0.03 | Target Position:   0 | STOP | Step Speed:     0 | Current Position: 143
   6 (  29ms) | Detected: 439.24 | Target: 440.00 | Delta:    0.76 | Target Position:   0 | STOP | Step Speed:     0 | Current Position: 143
   7 (  44ms) | Detected: 440.06 | Target: 440.00 | Delta:   -0.06 | Target Position:   0 | STOP | Step Speed:     0 | Current Position: 143
   8 (  29ms) | Detected: 439.59 | Target: 440.00 | Delta:    0.41 | Target Position:   0 | STOP | Step Speed:     0 | Current Position: 143
   9 (  43ms) | Detected: 439.98 | Target: 440.00 | Delta:    0.02 | Target Position:   0 | STOP | Step Speed:     0 | Current Position: 143
  10 (  14ms) | Detected: 441.49 | Target: 440.00 | Delta:   -1.49 | Target Position:  -6 | DOWN | Step Speed:   -66 | Current Position: 143
  11 (  29ms) | Detected: 439.67 | Target: 440.00 | Delta:    0.33 | Target Position:   0 | STOP | Step Speed:  -110 | Current Position: 139
  12 (  29ms) | Detected: 439.52 | Target: 440.00 | Delta:    0.48 | Target Position:   0 | STOP | Step Speed:     0 | Current Position: 137
  13 (  14ms) | Detected: 439.95 | Target: 440.00 | Delta:    0.05 | Target Position:   0 | STOP | Step Speed:     0 | Current Position: 137
  14 (  14ms) | Detected: 439.21 | Target: 440.00 | Delta:    0.79 | Target Position:   0 | STOP | Step Speed:     0 | Current Position: 137
  15 (  14ms) | Detected: 439.94 | Target: 440.00 | Delta:    0.06 | Target Position:   0 | STOP | Step Speed:     0 | Current Position: 137
  16 (  14ms) | Detected: 439.50 | Target: 440.00 | Delta:    0.50 | Target Position:   0 | STOP | Step Speed:     0 | Current Position: 137
  17 (  14ms) | Detected: 439.35 | Target: 440.00 | Delta:    0.65 | Target Position:   0 | STOP | Step Speed:     0 | Current Position: 137
  18 (  14ms) | Detected: 439.17 | Target: 440.00 | Delta:    0.83 | Target Position:   0 | STOP | Step Speed:     0 | Current Position: 137
  19 (  14ms) | Detected: 439.62 | Target: 440.00 | Delta:    0.38 | Target Position:   0 | STOP | Step Speed:     0 | Current Position: 137
  20 (  14ms) | Detected: 439.23 | Target: 440.00 | Delta:    0.77 | Target Position:   0 | STOP | Step Speed:     0 | Current Position: 137
  21 (  14ms) | Detected: 439.20 | Target: 440.00 | Delta:    0.80 | Target Position:   0 | STOP | Step Speed:     0 | Current Position: 137
  22 (  14ms) | Detected: 439.86 | Target: 440.00 | Delta:    0.14 | Target Position:   0 | STOP | Step Speed:     0 | Current Position: 137
  23 (  14ms) | Detected: 439.83 | Target: 440.00 | Delta:    0.17 | Target Position:   0 | STOP | Step Speed:     0 | Current Position: 137
  24 (  14ms) | Detected: 439.28 | Target: 440.00 | Delta:    0.72 | Target Position:   0 | STOP | Step Speed:     0 | Current Position: 137
  25 (  14ms) | Detected: 440.00 | Target: 440.00 | Delta:   -0.00 | Target Position:   0 | STOP | Step Speed:     0 | Current Position: 137
  26 (  14ms) | Detected: 439.39 | Target: 440.00 | Delta:    0.61 | Target Position:   0 | STOP | Step Speed:     0 | Current Position: 137
  27 (  14ms) | Detected: 439.27 | Target: 440.00 | Delta:    0.73 | Target Position:   0 | STOP | Step Speed:     0 | Current Position: 137
  28 (  14ms) | Detected: 439.25 | Target: 440.00 | Delta:    0.75 | Target Position:   0 | STOP | Step Speed:     0 | Current Position: 137
  29 (  14ms) | Detected: 439.50 | Target: 440.00 | Delta:    0.50 | Target Position:   0 | STOP | Step Speed:     0 | Current Position: 137
  30 (  14ms) | Detected: 439.77 | Target: 440.00 | Delta:    0.23 | Target Position:   0 | STOP | Step Speed:     0 | Current Position: 137
  31 (  14ms) | Detected: 439.07 | Target: 440.00 | Delta:    0.93 | Target Position:   0 | STOP | Step Speed:     0 | Current Position: 137
  32 (  14ms) | Detected: 439.41 | Target: 440.00 | Delta:    0.59 | Target Position:   0 | STOP | Step Speed:     0 | Current Position: 137
  33 (  14ms) | Detected: 439.50 | Target: 440.00 | Delta:    0.50 | Target Position:   0 | STOP | Step Speed:     0 | Current Position: 137
  34 (  14ms) | Detected: 439.42 | Target: 440.00 | Delta:    0.58 | Target Position:   0 | STOP | Step Speed:     0 | Current Position: 137
  35 (  14ms) | Detected: 439.43 | Target: 440.00 | Delta:    0.57 | Target Position:   0 | STOP | Step Speed:     0 | Current Position: 137
  36 (  14ms) | Detected: 439.40 | Target: 440.00 | Delta:    0.60 | Target Position:   0 | STOP | Step Speed:     0 | Current Position: 137
  37 (  14ms) | Detected: 439.81 | Target: 440.00 | Delta:    0.19 | Target Position:   0 | STOP | Step Speed:     0 | Current Position: 137
  38 (  14ms) | Detected: 438.96 | Target: 440.00 | Delta:    1.04 | Target Position:   4 |   UP | Step Speed:    66 | Current Position: 137
  39 (  14ms) | Detected: 439.72 | Target: 440.00 | Delta:    0.28 | Target Position:   0 | STOP | Step Speed:   168 | Current Position: 139
  40 (  14ms) | Detected: 439.17 | Target: 440.00 | Delta:    0.83 | Target Position:   0 | STOP | Step Speed:     0 | Current Position: 141
  41 (  14ms) | Detected: 439.68 | Target: 440.00 | Delta:    0.32 | Target Position:   0 | STOP | Step Speed:     0 | Current Position: 141
  42 (  14ms) | Detected: 439.54 | Target: 440.00 | Delta:    0.46 | Target Position:   0 | STOP | Step Speed:     0 | Current Position: 141
  43 (  14ms) | Detected: 439.37 | Target: 440.00 | Delta:    0.63 | Target Position:   0 | STOP | Step Speed:     0 | Current Position: 141
  44 (  14ms) | Detected: 439.59 | Target: 440.00 | Delta:    0.41 | Target Position:   0 | STOP | Step Speed:     0 | Current Position: 141
  45 (  14ms) | Detected: 439.73 | Target: 440.00 | Delta:    0.27 | Target Position:   0 | STOP | Step Speed:     0 | Current Position: 141
  46 (  14ms) | Detected: 440.05 | Target: 440.00 | Delta:   -0.05 | Target Position:   0 | STOP | Step Speed:     0 | Current Position: 141
  47 (  14ms) | Detected: 439.98 | Target: 440.00 | Delta:    0.02 | Target Position:   0 | STOP | Step Speed:     0 | Current Position: 141
  48 (  14ms) | Detected: 439.24 | Target: 440.00 | Delta:    0.76 | Target Position:   0 | STOP | Step Speed:     0 | Current Position: 141
  49 (  14ms) | Detected: 439.88 | Target: 440.00 | Delta:    0.12 | Target Position:   0 | STOP | Step Speed:     0 | Current Position: 141
  50 (  14ms) | Detected: 440.29 | Target: 440.00 | Delta:   -0.29 | Target Position:   0 | STOP | Step Speed:     0 | Current Position: 141
  51 (  14ms) | Detected: 439.56 | Target: 440.00 | Delta:    0.44 | Target Position:   0 | STOP | Step Speed:     0 | Current Position: 141
  52 (  14ms) | Detected: 439.55 | Target: 440.00 | Delta:    0.45 | Target Position:   0 | STOP | Step Speed:     0 | Current Position: 141
  53 (  15ms) | Detected: 439.45 | Target: 440.00 | Delta:    0.55 | Target Position:   0 | STOP | Step Speed:     0 | Current Position: 141
  54 (  14ms) | Detected: 439.43 | Target: 440.00 | Delta:    0.57 | Target Position:   0 | STOP | Step Speed:     0 | Current Position: 141
  55 (  15ms) | Detected: 439.76 | Target: 440.00 | Delta:    0.24 | Target Position:   0 | STOP | Step Speed:     0 | Current Position: 141
  56 (  14ms) | Detected: 439.35 | Target: 440.00 | Delta:    0.65 | Target Position:   0 | STOP | Step Speed:     0 | Current Position: 141
  57 (  15ms) | Detected: 439.87 | Target: 440.00 | Delta:    0.13 | Target Position:   0 | STOP | Step Speed:     0 | Current Position: 141
  58 (  14ms) | Detected: 439.75 | Target: 440.00 | Delta:    0.25 | Target Position:   0 | STOP | Step Speed:     0 | Current Position: 141
  59 (  15ms) | Detected: 439.51 | Target: 440.00 | Delta:    0.49 | Target Position:   0 | STOP | Step Speed:     0 | Current Position: 141
  60 (  14ms) | Detected: 439.13 | Target: 440.00 | Delta:    0.87 | Target Position:   0 | STOP | Step Speed:     0 | Current Position: 141
STOPPED
