reubenstr/MelodicChimes/images/prototyping/melodic-chimes-early-testing.jpg

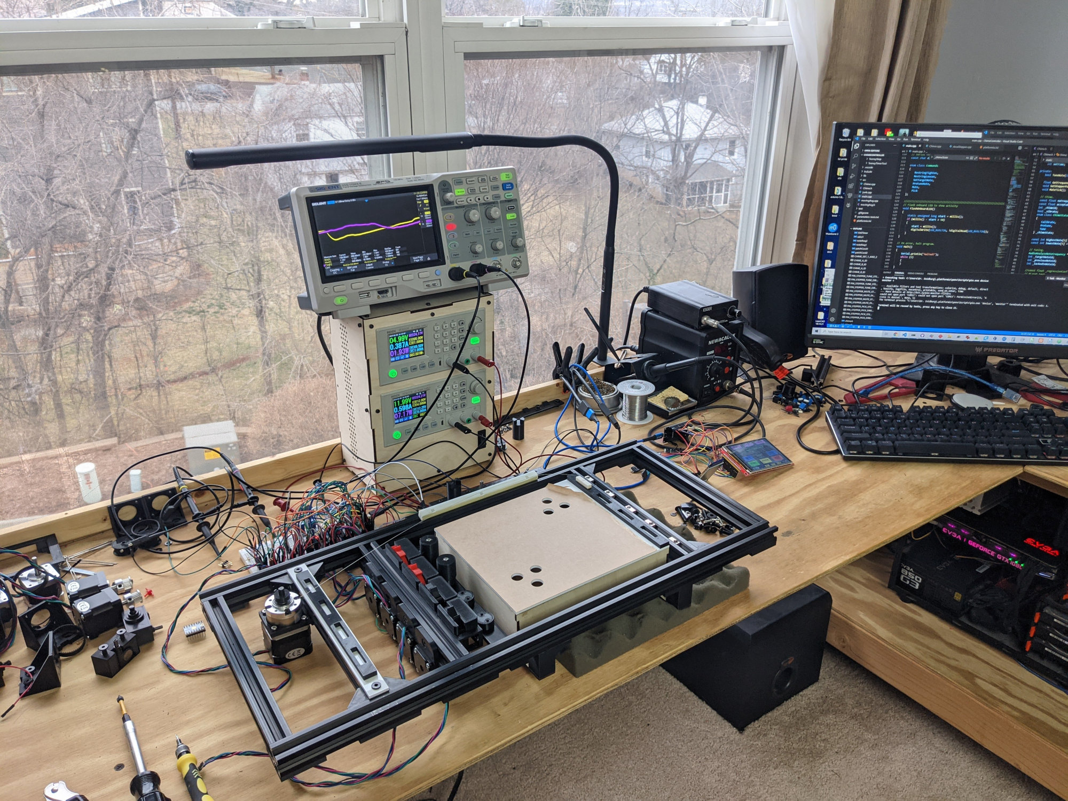
images/prototyping/melodic-chimes-early-testing.jpg
