reubenstr/MelodicChimes/images/prototyping/melodic-chimes-prototype-quad-strings-test.jpg

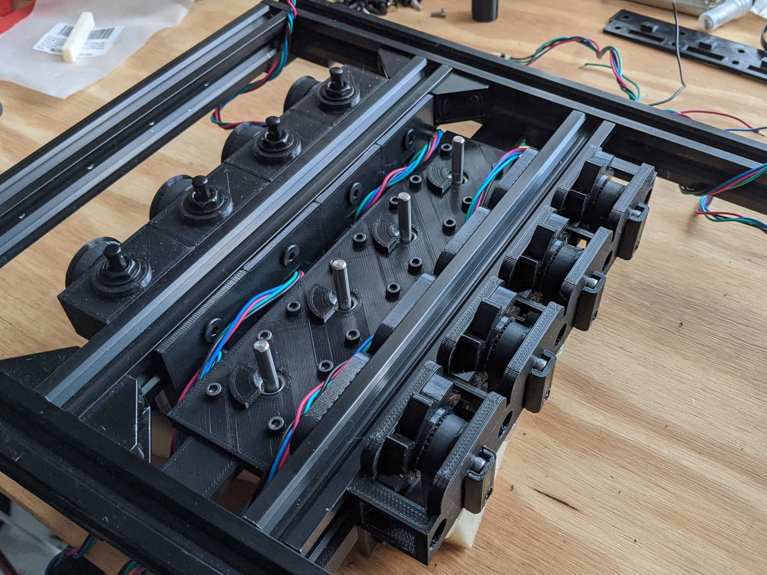
images/prototyping/melodic-chimes-prototype-quad-strings-test.jpg
