reubenstr/MelodicChimes/images/prototyping/melodic-chimes-prototype-worn-tuning-peg-gear.jpg

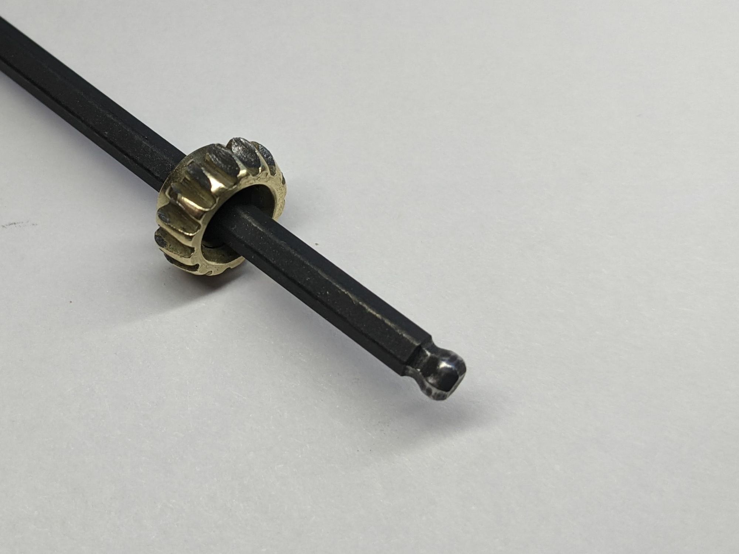
images/prototyping/melodic-chimes-prototype-worn-tuning-peg-gear.jpg
