reubenstr/MelodicChimes/(list of files, drawings)

Other design files:
PCBs/ChimeBoard-Left.dip
PCBs/ChimeBoard-Right.dip
PCBs/ChimeBoard-test.dch
PCBs/ChimeBoard.dch
PCBs/MainBoard.dch
PCBs/MainBoard.dip
