reubenstr/MelodicChimes/firmware/MainController/src/gfxItem.h

#include <Arduino.h>
#include <TFT_eSPI.h>

#ifndef GFXITEM_H
#define GFXITEM_H

struct GFXItem
{
    String text;
    int id;
    int groupId;
    bool isPressable = true;
    int x, y;
    int w = 0;
    int h = 0;

    uint32_t textColor;
    uint32_t fillColor;
    uint32_t activeColor;
    uint32_t borderColor;

    bool isPressed = false;
    int textSize = 1;

    uint8_t datem = TC_DATUM;

    int borderThickness = 0;
    signed int minimumCharacters = -1;
    int padding = -1;
    int cornerSize = 0;

    uint8_t textFont = 0;
    const GFXfont *gfxFont = nullptr;

    GFXItem();

    // Candidate for buttons.
    GFXItem(int id, int groupId, String text, int textSize, int x, int y, int w, int h,
            uint32_t textColor, uint32_t fillColor, uint32_t activeColor,
            uint32_t borderColor, const GFXfont *gfxFont = nullptr)
    {

        this->groupId = groupId;
        this->id = id;
        this->text = text;
        this->textSize = textSize;
        this->x = x;
        this->y = y;
        this->w = w;
        this->h = h;
        this->textColor = textColor;
        this->fillColor = fillColor;
        this->activeColor = activeColor;
        this->borderColor = borderColor;
        this->gfxFont = gfxFont;

        datem = MC_DATUM;
        cornerSize = 5;
        borderThickness = 1;
    }

    // Candidate for labels.
    GFXItem(int id, int groupId, String text, int textSize, int x, int y, int w, int h,
            uint32_t textColor, uint32_t fillColor, uint8_t datem, const GFXfont *gfxFont = nullptr)
    {
        this->id = id;
        this->groupId = groupId;
        this->text = text;
        this->textSize = textSize;
        this->x = x;
        this->y = y;
        this->w = w;
        this->h = h;
        this->textColor = textColor;
        this->fillColor = fillColor;
        this->datem = datem;
        this->gfxFont = gfxFont;
    }

    bool IsPointInBoundry(int xTest, int yTest)
    {
        if (xTest >= x - w / 2 && xTest <= (x + w / 2))
        {
            if (yTest >= y - h / 2 && yTest <= (y + h / 2))
            {
                return true;
            }
        }
        return false;
    }
};

#endif
