reubenstr/MelodicChimes/firmware/MainController/src/tftMethods.h

/*
    tftMethods.h
	
	For ESP32 and TFT_eSPI
*/

#include <FS.h>
#include <TFT_eSPI.h>
#include <SPIFFS.h>

#define CALIBRATION_FILE "/TouchCalData"

void CheckTouchCalibration(TFT_eSPI *tft, bool forceCalibrationFlag)
{
    uint16_t calData[5];
    uint8_t calDataOK = 0;

    if (SPIFFS.begin())
    {
        Serial.println("SPIFFS: Exists.");
    }
    else
    {
        Serial.println("SPIFFS: Formating file system.");
        SPIFFS.format();
        SPIFFS.begin();
    }

    // check if calibration file exists and size is correct
    if (SPIFFS.exists(CALIBRATION_FILE))
    {
        Serial.println("SPIFFS: Getting calibration file.");
        fs::File file = SPIFFS.open(CALIBRATION_FILE, "r");
        if (file)
        {
            if (file.readBytes((char *)calData, 14) == 14)
            {
                calDataOK = 1;
            }
            file.close();
        }
    }
    else
    {
        Serial.println("SPIFFS: calibration files does not exist.");
    }

    if (calDataOK && !forceCalibrationFlag)
    {
        // calibration data valid
        Serial.println("TFT: calibration data valid.");
        tft->setTouch(calData);
    }
    else
    {
        Serial.println("TFT: calibration data invalid.");
        Serial.println("TFT: Start calibration.");

        // data not valid so recalibrate
        tft->fillScreen(TFT_BLACK);
        tft->setCursor(20, 0);
        tft->setTextFont(2);
        tft->setTextSize(1);
        tft->setTextColor(TFT_WHITE, TFT_BLACK);
        tft->println("Touch corners as indicated");
        tft->setTextFont(1);
        tft->println();
        tft->calibrateTouch(calData, TFT_MAGENTA, TFT_BLACK, 15);
        tft->setTextColor(TFT_GREEN, TFT_BLACK);
        tft->println("Calibration complete!");

        // store data
        fs::File file = SPIFFS.open(CALIBRATION_FILE, "w");
        if (file)
        {
            file.write((const unsigned char *)calData, 14);
            file.close();
        }
        Serial.println("TFT: calibration complete.");
    }
}
