reubenstr/MelodicChimes/(commit log)

2020-01-13 First commit.
    [BoardOutline.gbr, Bottom.gbr, BottomAssy.gbr, BottomDimension.gbr, BottomMask.gbr, BottomPaste.gbr, BottomSilk.gbr, Through.drl]
2020-12-23 Continued prototyping.
    [parameters-tests.txt]
2020-12-25 Prototyping. Crude melody playing.
    Need faster motors, 50RPM is way to slow. Need 200+, on the way soon. :)
2020-12-25 Prototyping. New motor control algo.
2020-12-28 Prototyping. Swapping to three DC motors for control.
    [timing-charts.ods]
2020-12-28 Pick and Mute with dc motors.
2021-01-03 Change to solenoid mute.
2021-01-04 Testing n25 motor.
2021-01-05 Swap to stepper, testing.
    [Chime.h, main.cpp]
2021-01-05 Stepper tests.
2021-01-06 State of flux between motor types.
2021-01-08 Prototyping. Working with stepper libraries.
    [BoardOutline.gbr, Bottom.gbr, BottomAssy.gbr, BottomDimension.gbr, BottomMask.gbr, BottomPaste.gbr, BottomSilk.gbr, Through.drl]
2021-01-20 Adding pick calibration tests.
    [MelodicChimes.kicad_pcb, MelodicChimes.sch, mainboard.sch]
2021-01-21 Next phase.
    [parameters-tests.txt]
2021-01-22 Added note tuning by fixed steps.
    [timing-charts.ods]
2021-01-23 GLCD tests.
    [timing-charts.ods]
2021-01-24 GLCD swap from ESP32 to TEENSY
    [timing-charts.ods]
2021-01-25 Label and button classes added.
2021-01-25 Change color on button presses.
2021-01-25 Labels and buttons working in new class format.
2021-01-30 PCB work.
    [DriverBoard.dch, DriverBoard.dip, DriverBoard.kicad_pcb, DriverBoard.sch, MelodicChimes.sch]
2021-01-30 PCB update.
    [DriverBoard.dch, DriverBoard.dip, DriverBoard.sch]
2021-02-05 PCB dev.
    [DriverBoard.dch, DriverBoard.dip, MainBoard.dch, MainBoard.dip, timing-charts.ods]
2021-02-09 Adding UART.
    [ChimeBoard-4.dip, ChimeBoard.dch]
2021-02-11 Intergrating notefreq into the chime class.
    [ChimeBoard-4.dip, ControllerBoard-2.dip]
2021-02-18 ESP32 UART test.
    [ChimeBoard-4.dip, ChimeBoard.dch]
2021-02-26 Planetary stepper test, working very well.
2021-11-26 dev restart
    Project pickup, reconnecting hardware. Minor dev tweaks.
    [ChimeBoard-Left.dip, ChimeBoard.dch, timing-charts.ods]
2021-11-29 cleanup
    removed old physical testing code
    [ChimeBoard-test.dch]
2021-12-14 major cleanup
    [timing-charts.ods]
2021-12-14 add graph
    [timing-charts.ods]
2021-12-17 naming refactor
    [timing-charts.ods]
2021-12-23 cad upload, neopixel add
    [melodic-chimes-3.dxf]
2021-12-26 add nameplate led control
2021-12-29 bug fix: false freq. detection due to harmonics
    [Chime.cpp, Chime.h, main.cpp]
2022-01-08 adding communications from chimes
    [timing-charts.ods]
2022-01-08 added polynomial regression coefs to code
    [ChimeBoard-Left.dip, ChimeBoard-Right.dip, ChimeBoard-test.dch, ChimeBoard.dch, MainBoard.dch, MainBoard.dip, timing-charts.ods]
2022-01-09 gfx draw rework - bug fixed
    [Chime.cpp, Chime.h, gfxItem.h, gfxItems.cpp, graphicsMethods.cpp, graphicsMethods.h, main.cpp, main.h]
2022-01-09 project cleanup
    [timing-charts.ods]
2022-01-09 add STLs
    [frame hanger v5.stl, lower bridge v2.stl, name plate - housing v9.stl, name plate clip v3.stl, pcb - opamp - level block v2.stl, pcb mount riser v5.stl, pick cam v15.stl, plectrum bracket v17.stl]
